Tokisaki3333/h415-LSM6DSV16XTR/docs/参考源_官方手册与规范.md

# 参考源：官方手册、规范与外部实现

> **定位**：本目录集中存放**厂商/官方**的原始资料，供实现与核对时引用。
> 这些资料是**一手权威**，不受本项目历史口径变动影响。
>
> 建立日期：2026-10-15

---

## 1. 器件数据手册（`docs/datasheets/`）

| 文件 | 器件 | 用途 | 本板是否在用 |
|---|---|---|---|
| `LSM6DSV16XTR_datasheet.PDF` | ST LSM6DSV16X | IMU（陀螺 + 加计） | ★ **在用** |
| `MMC5983MA_datasheet.PDF` | MEMSIC MMC5983MA | 三轴磁强计（18 位，SET/RESET） | ★ **在用** |
| `BMP388_datasheet.PDF` | Bosch BMP388 | 气压计 | ★ **在用** |
| `CH32H417_datasheet.PDF` | WCH CH32H417 | MCU 数据手册 | ★ **在用**（V3F/V5F 双核） |
| `CH32H417_reference_manual.PDF` | WCH CH32H417 | MCU 参考手册（寄存器级） | ★ **在用** |
| `ATGM336H_GNSS_module_manual.PDF` | 中科微 ATGM336H | GNSS 模块用户手册 | ★ **在用** |
| `MMC5603NJ_datasheet.PDF` | MEMSIC MMC5603NJ | 磁强计（**无 SET/RESET**） | ✗ 历史/对照 |
| `ICM-42605_datasheet_legacy.PDF` | TDK ICM-42605 | IMU（**旧代器件**） | ✗ 仅旧代归档 |

**另有**：`LSM6DSV16X_register_map.md`（寄存器映射速查，中文，13 KB）。

### 器件换代说明（引用时必须注意）

```
当前硬件 = LSM6DSV16X + MMC5983MA
旧代硬件 = ICM-42605 + IST8310（现存于 _archive/legacy_icm42605_ist8310/）
⟹ 凡文档提到 ICM-42605 / IST8310 / MMC5603NJ 的配置、寄存器、噪声，
   都是【旧代】结论，不可直接用于当前器件。
   ★ 已知受影响文档：docs/reference_implementations_survey.md
     （其全文为 ICM-42605 + IST8310 时代的调研，含旧代寄存器值）
```

---

## 2. 器件驱动源码

**本仓库内的实现即驱动本身**，位于 `Common/Common/`：

| 文件 | 说明 |
|---|---|
| `lsm6dsv16x.c` / `.h` / `lsm6dsv16x_reg.h` | IMU 驱动 + 寄存器定义 |
| `mmc5983.c` / `.h` / `mmc5983ma_reg.h` | 磁强计驱动 + 寄存器定义 |
| `bmp388.c` / `.h` / `bmp388_reg.h` | 气压计驱动 + 寄存器定义 |
| `i2c_soft.c` / `.h`、`sensor_spi.c` / `.h`、`sensor_dma.h` | 总线层 |

**注意**：
```
1. 工程内未内置厂商的原始驱动【包】（ST 的 lsm6dsv16x-pid、MEMSIC 的 MMC5983MA
   参考驱动源码树）—— 本地未找到对应压缩包。
2. 若需逐寄存器核对，请以 docs/datasheets/ 的手册 + 仓库内 *_reg.h 为准；
   后者是从手册抄录的寄存器定义。
3. 磁强计的 SET/RESET 时序口径（官方驱动 AP_Compass_MMC5XX3 的做法）见
   docs/S2_地磁读法与阶段结论.md 与 docs/mag_calibration_log.md。
```

---

## 3. 外部实现对照（调研结论）

`docs/reference_implementations_survey.md` —— PX4 / ArduPilot / Betaflight / Paparazzi / xioTechnologies Fusion 的对照调研。

```
★ 该文档为【旧代（ICM-42605 + IST8310）】时代的产物，其寄存器值与结论不可直接用于
  当前器件；但其"对照什么、用什么判据"的方法论仍可参考。
```

---

## 4. 引用纪律

```
1. 手册 > 仓库内 *_reg.h > 文档中的转述。
   凡"文档说器件如何"与手册冲突，以手册为准，并应修正文档。
2. 任何来自旧代器件的数字（ICM-42605 / IST8310 / MMC5603NJ）必须标注【旧代】。
3. 本目录只放官方/厂商资料。项目的分析口径、常数溯源、结论登记
   分别在 docs/接力_*.md、V5F/User/inc/proc_tune.h 注释、
   docs/地磁结论信任登记表.md 中，不要混入本目录。
```
