Tokisaki3333/h415-LSM6DSV16XTR/地磁工作交接_20261015.md

# 地磁工作交接文档（2026-10-15 建立）

# ★★★★★ 唯一验收判据（本文件一切数字都挂在这条上）

# **地磁矢量在世界系坐标的集中程度**

```
唯一的量:  B̂_world = R(q) · (m̂_body)
           其中 m̂_body = 该姿态下的实测地磁单位矢量
                R(q)   = 该姿态相对世界系的旋转
           集中程度 = 各姿态的 B̂_world 相对其均值的夹角散布

唯一记法:  报告【总角误差】的 σ / max（单位：度）
```

## 明确【不算】判据的量

```
✗ 模长 |B| 的散布                （用户明确：模长没有意义）
✗ "欠零点"的散布                 （中间量，不是判据）
✗ 与陀螺积分的吻合度             （陀螺不是判据的基准）
✗ dip（场与重力夹角）的散布      （诊断量，不是判据）
✗ 同姿态重访的一致性             （辅助量，不是判据）
```

## 为什么必须写在最前面

```
本文件里有三组数字相差一个量级，极易互相误用：
    总角误差  ≈ 2.70°（max）
    倾角分量  ≈ 1.51°（σ）
    偏航分量  ≈ 3.79°（σ）
若不知道"唯一记法是总角误差"，就会把偏航分量的 3.79° 当成"精度 ±4°"，
或把校准后的 0.49° 当成已经达标 —— 两者都是错的。

另：任何精度数字都必须同时标注其【零点前提】（见 §3 U-1），
    否则该数字不可复现、也不可比较。
```

---

> **本文档的用途**：把当前地磁方向精度工作的**全部尝试、实测效果、以及我（AI 助手）的假设**
> 如实交接。**核心要求：严格区分"真理/事实"与"假设"。**
>
> **阅读约定（务必遵守）**：
> - `【事实】` = 由本仓库数据直接算出、可复现、不依赖任何未验证前提的陈述
> - `【假设】` = 我提出的解释或推断，**未经验证，不得当作结论引用**
> - `【已否证】` = 曾提出、已被数据否决
> - `【未验证前提】` = 某结论成立所依赖、但当前无法证实/证伪的条件
>
> **本文档不含"结论级"断言。** 未经验证的推断一律放在 §4~§6，不得提升为事实。
>
> ★ **不得参考分析源脚本实现**：本工作区（含 v3 根目录的 2084 个 .py）里的
>   分析脚本一律**不作为实现依据**，以防止把过程性尝试固化成"事实"。
>   详见 `docs/参考源_官方手册与规范.md` 与接力文档。判据与事实以本文档 §2 为准。

---

## 1. 当前处境（一句话）

```
以【§0 唯一判据】衡量：
  未校准      : 总角误差 max ≈ 2.70°（σ 0.26°）
  单录制校准后: 总角误差 max ≈ 0.97°（σ 0.25°）
但校准用的水平零点偏移 δ 逐录制不同（061932 |δ|=399、052232 |δ|=433），
搬到另一份录制上反而变差（052232: 4.21° → 5.14°）。
⟹ 修正量无法跨录制沿用。这是当前唯一卡住的地方。
```

---

## 2. 【事实】清单（可直接复现）

### F-1 帧解析

```
168 B FULL 帧；帧头 = 4 个 float（2×sync + type + seq）；载荷从 float[4] 开始
  q      = float[4..7]      gyro = float[8..10]   accel = float[11..13]
  mag    = float[23..25]    pol  = flag2 bit0 = float[29]
  flag   = float[17]        bias = float[30..32]
  ts     = float[18]×2^24 + float[41]，单位 10 ns
自检: |q| 偏离 1 ≤ 1.6e-7（全部帧）；R:\ 上有 15 份录制首 sync 在偏移 104
复现: frame168.py
```

### F-2 两份关键录制的性质

| 录制 | 帧数 | 时长 | SET | RST | SET 占比 | |a| 中位 |
|---|---|---|---|---|---|---|
| `rec_20261015_055817` | 230263 | 30.0 s | 228407 | 1856 | 99.19% | 1.0863 |
| `rec_20261015_061932` | 460506 | 60.0 s | 456802 | 3704 | 99.20% | 1.0050 |
| `rec_20261015_052232` | 921255 | 120.0 s | 913842 | — | — | — |

### F-3 两份录制的 SET 样本三维覆盖

```
055817  SET 228407  去均值协方差特征值 [5.7e6, 1.34e7, 2.52e7]   最小/最大 0.226
052232  SET 913842  去均值协方差特征值 [17992.5, 6.788e6, 8.878e6] 最小/最大 0.002027
        最小方差方向 [0.0072, 0.0177, 0.9998]（≈体 z），沿该方向跨度 3738 counts
061932  SET 456802  去均值协方差特征值 [17375, 4.92e6, 9.13e6]   最小/最大 0.001904
```

### F-4 球拟合结果

```
055817（覆盖充分）: 球心 [130652.4, 131531.8, 132346.2]  R = 8091.9  残差 σ = 176.3 (2.1787%)
                   椭球中心 [130725.2, 131487.5, 132298.7]（差 340）
                   半轴比 [1.015649, 1.002318, 0.982032]  各向异性 3.3617%
052232（覆盖不足）: 自拟合给出 R = 4068.5（而 |f| 应 ≈8100）⟹ 退化解
061932（覆盖不足）: 同
```

### F-5 两相中点在单次录制内与姿态无关

```
061932，6 个姿态（0°,45°,…,225°）的两相中点:
  [131718.52 130976.42 132047.57]  [131721.52 130993.63 132041.12]
  [131709.43 130979.66 132032.07]  [131726.70 130964.43 132039.91]
  [131712.76 130970.67 132047.94]  [131726.00 130984.76 132033.70]
  跨姿态极差 = [17.27, 29.20, 15.87] counts
052232，多个姿态的两相中点: |Δ| = 12.0 / 12.2 / 13.8 counts
⟹ 存在一个【姿态无关的固定矢量】，其估计值即两相中点
```

### F-6 两相中点与球心不是同一个点

```
055817: 两相中点 = [131899.48, 130824.78, 132157.04]
        球心     = [130652.40, 131531.80, 132346.20]
        差       = [-1247.1, +707.0, +189.2]   |差| = 1446.0 counts
```

### F-7 陀螺在 061932 六窗口间的净转角（用户声明为整 45°）

```
0→1 44.6146°   1→2 45.1722°   2→3 44.2463°   3→4 44.3726°   4→5 44.7682°
转轴 [-0.007, 0.019, -0.9998]，与体 z 夹角 1.12~1.20°
⟹ 与"步进 45°"一致到 ≤0.75°
```

### F-8 加计在 061932 六窗口间的一致性

```
重力方向（体坐标）: [0.02324 -0.00302 0.99973]  [0.01845 0.00075 0.99983]
                   [0.01255 0.00030 0.99992]  [0.01116 -0.00583 0.99992]
                   [0.01237 -0.01174 0.99985] [0.01850 -0.01539 0.99971]
相对均值散布: 0.2801° ~ 0.5659°
g_z 极差 2.1e-4    |a| 中位 1.00502
```

### F-9 061932 的场矢量与角度分解（零点 = 055817 球心）

```
SET 均值:
  [127752.5 128698.3 139612.1]  [130588.6 127674.3 139621.5]
  [133333.4 129013.8 139581.6]  [134346.9 131817.9 139525.8]
  [133138.0 134522.0 139490.4]  [130390.5 135610.5 139501.9]
|f| : 8320.56  8234.92  8116.61  8079.48  8133.83  8240.67   相对σ 1.0262%
f·ĝ : 7205.12  7269.98  7267.77  7218.60  7138.78  7086.03
dip : 59.9904  61.9848  63.5625  63.3098  61.3620  59.3037
      中位 61.6734°  σ 1.5728°  极差 4.2588°

相邻方位差: 44.5065  48.7198  49.2285  46.7391  43.2450   （应 45°）
```

### F-10 061932 的角度误差分解

```
                        总角误差σ    max       倾角分量σ   偏航分量σ
  原始（锚点 45° 参照）   0.2624°   2.7037°    1.5078°     1.8006°
  原始（陀螺参照）        0.2592°   1.9745°    1.1743°     1.1685°
  零点重解后（锚点）      0.2517°   0.9712°    0.2125°     0.4947°
  零点重解后（陀螺）      0.3901°   2.5370°    1.3187°     1.4649°

原始偏航残差（锚点参照）: -4.4705 -4.9640 -1.2443 +2.9843 +4.7234 +2.9684
   中位|·| 3.7274°  σ 3.7904°  max 4.9640°   （极差/σ = 2.556，接近正弦的 2.83）
原始倾角残差（相对中位）: -1.683 +0.311 +1.889 +1.636 -0.311 -2.370
```

### F-11 水平模长（应恒定）在 061932 上不恒定

```
|h| : 4109.57  3819.36  3564.45  3593.84  3848.79  4137.45
相对σ 5.7951%   极差 573.1 counts
```

### F-12 "正六边形约束"反解水平零点偏移 δ 的效果

```
定义: h_k = (S_k − Z) 的水平分量；约束 = |h_k| 恒定 且 相邻方位差 = 45°；只解 2 参数

061932: δ = (+363.60, −164.60)  |δ| = 399.12
        偏航残差 σ 3.7904° → 1.0241°（max 4.9640° → 1.9137°）
        |h| 相对σ 5.7951% → 0.3616%
        |h| : 4109.6 3819.4 3564.4 3593.8 3848.8 4137.5
            → 3971.6 3983.9 3942.6 3945.8 3962.1 3955.7

052232: δ = (+332.80, +276.40)  |δ| = 432.61   （步数由陀螺定: [0 1 2 3 4 5 5 7 8 9 10 11 12]）
        偏航残差 σ 4.2084° → 0.8061°（max 6.5575° → 1.7415°）
        |h| 相对σ 8.1780% → 0.7295%
```

### F-13 δ 不可跨录制沿用

```
把 061932 的 δ 用到 052232 上:
    偏航残差 σ 4.2084° → 5.1371°（变差）
    |h| 相对σ 8.1780% → 6.8937%
两份录制的 δ: 061932 |δ|=399（方向角≈062°）；052232 |δ|=433（方向角≈040°）
    差值 344 counts，方向差 22°
```

---

## 3. 【未验证前提】清单（结论成立所依赖、但当前无法证实/证伪）

```
U-1 零点取值
    055817 球心能不能当 061932/052232 的零点？
    ⟹ 无法判定。052232/061932 的 SET 覆盖不足（F-3），其真实零点不可辨识。
    ⟹ 一切依赖零点取值的精度数字，都必须标注该前提。

U-2 转台动作的几何
    用户声明 061932 的步进是整 45°、六窗口静置（已用于 F-7 的对照）。
    "转台轴 = 世界竖直" 这一条未独立验证。

U-3 磁与加计的相对安装
    假定两者同体坐标系、无相对安装角。未独立标定。

U-4 场在装置所处位置的均匀性与时间稳定性
    按物理常识假定地磁矢量在录制期间恒定。未独立测量。
```

---

## 4. 【假设】清单（我的推断，均未验证）

```
H-1 偏航误差的主要来源是"未补偿的水平零点/硬磁偏移"
    支持: F-11（|h| 随方位周期波动 5.8%）+ F-12（解掉该偏移后偏航误差降 3.7 倍）
    反证缺失，但也未排除其他来源（标度/交叉轴/加计对应项）
    状态: 【假设】

H-2 F-12 里解出的 δ 是一个"物理量"而非拟合噪声
    支持: 只用 2 个参数，同时改善了 (a) 12~13 点的模长恒定性 与 (b) 步进等角性
    风险: 单录制拟合，无法排除"吸收了这个录制特有的系统项"
    状态: 【假设】

H-3 δ 逐录制不同的原因
    候选（本数据无法区分）:
      a) 磁零点的会话间漂移
      b) 055817 球心估计本身的系统偏差（其 RST 仅 1856 样本）
      c) 两个水平轴的标度/交叉轴项（会伪装成 δ）
    状态: 【假设，未区分】
```

### 曾提出并已【已否证】的假设

```
X-1 "差分流 (RST−SET)/2 自动消掉零点，无需重拟合"
    ⇒ 否证依据: 用 055817 球心作零点时还需额外 δ（F-12）；两相中点与球心差 1446（F-6）
    注: 后来用户裁断"无法判断一个预制零点是否合适"，故该否证本身也降级为
        "两种零点口径给出不同结果"这一事实陈述

X-2 "运动污染地磁读数"
    ⇒ 否证: 055817 SET 样本 corr(log10|ω|, 球拟合残差%) = +0.098（不相关）
            各运动层 |f−c| 均值 8048~8123（差 0.9%）

X-3 "dip 极差由竖直零点或水平增益造成"
    ⇒ 否证: c_z 变动 ±200 counts ⟹ dip 极差仅 4.21°→4.31°
            水平 ×0.95~1.05 ⟹ dip 极差仅 4.14°→4.37°

X-4 "用 grav_open 位可直接判定静置平台"
    ⇒ 否证: 052232 里 grav_open=1 有 331 个游程，绝大多数 <0.3 s，前后闭口 0.00~0.04 s
            段内 |ω| max 普遍 20 dps（门开/关过渡的爆发）

X-5 "陀螺与磁不自洽（差 23~26°）"
    ⇒ 否证: 我自己把步进几何公式写反了。
            正确式 θ = arccos(cos²α + sin²α·cosφ)（α = 场与转轴夹角）
            我误用 arccos(sin²α + cos²α·cosφ)
```

---

## 5. 【事实】级的勘误（我犯过、必须留档）

```
E-1 Δts 单位错: 曾按 1 µs 用，实为 10 ns（dt 差 100 倍）
E-2 录制时长: 曾用 ts 跨度当时长 ⟹ 误报"丢帧 88%"。
    实际是文件开头 ~8 KB CDC 陈旧积压（时戳早 74 s），实时窗口内 Δseq ≡ 1
E-3 帧头 float 数: 曾数成 3 个，实为 4 个
E-4 无 sync 搜索的加载器: 在 size%168==104 的文件上 100% 静默错误
E-5 列位置: 曾把 float[4:7] 当加计（那是 qw,qx,qy）；float[14:16] 当 mag_u（那是 IGG 权与统计量）
E-6 degrees(sum) 漏乘 dt: 把 179° 读成 10256°
E-7 用 ∫ω dt 的模当转轴: 多动作窗口下不可靠，应从积分四元数取轴
E-8 二次型拟合不看条件数: 曾输出"各向异性 1.54%"，而奇异值 min/max = 2.86e-10
E-9 共面点集做 3D 球拟合: 曾给出 R=7032 的伪解（而 |f|≈8563）
E-10 PowerShell 内联 Python 改文件时 \n 被当真换行，块间多插 16 个空行
E-11 我曾用中间版索引去覆盖当前索引，丢掉了 10-13 的合法更新（已恢复）
```

---

## 6. 待做的判定实验（最小充分条件）

```
D-1 【区分"零点漂移"与"标度/交叉轴"】
    同一姿态、把器件原地绕竖直自转 180°（不换面、不换夹具），再回到原位
      δ 跟着器件朝向变 ⟹ 标度/交叉轴（与器件朝向绑定）
      δ 不变         ⟹ 零点漂移（与姿态无关）
    理论依据: F-5 已证明两相中点与姿态无关；若 δ 属于同一类，它也应与姿态无关

D-2 【分离"系统性"与"重复性"】
    每个姿态停 ≥2 s 并重复访问（如 0°/45°/…/315° 各停两次）
    当前 061932 每个姿态只测一次，无法把方位相关系统误差与随机误差分开

D-3 【独立验证"转台轴 = 世界竖直"】
    在同一录制内加一段纯倾斜（不绕竖直转），看 dip 是否随倾斜角保持
```

---

## 7. 脚本资产（本次工作产出）

| 脚本 | 作用 | 状态 |
|---|---|---|
| `frame168.py` | 168 B 帧权威解析（sync 搜索） | 已验 |
| `gyro_pc.py` | PC 侧陀螺零偏追踪复现 | 已验（与板载差中位 ≤0.0036 dps） |
| `deltasolve2.py` | 正六边形约束反解水平零点 δ | F-12 来源 |
| `deltacross2.py` | δ 的跨录制验证 | F-13 来源 |
| `sep_061932.py` | 倾角/偏航分量分离 | F-10 来源 |
| `dipdiag.py` / `dipdiag2.py` | dip 极差归因（否证 X-3） | X-3 来源 |
| `zerocross.py` | 两相中点姿态无关性、球心 vs 中点 | F-5 / F-6 来源 |
| `ellipsoid_full.py` | SET-only 球/椭球拟合 | F-4 来源 |
| `prec_061932.py` | 精度口径汇总 | F-10 汇总 |
| `anchor061932.py` `anchor2_061932.py` `anchor3_061932.py` | 锚点法（含两次符号错误留档） | 参考 |
| `motionresid.py` | 残差 vs \|ω\| 相关性（否证 X-2） | X-2 来源 |

---

## 8. 交接要点（给下一位）

```
1. 先读顶部【唯一验收判据】，再读 §2（事实）与 §3（未验证前提），最后 §4（假设）。
   不要把 §4 当结论。
2. 凡引用任何精度数字，必须同时标注其【零点前提】（见 U-1）。
3. 零点标定必须用专用全覆盖录制；验收录制不具备自标定能力（F-3）。
4. 静置平台提取不要用 grav_open 直接判定（X-4）。
5. 每个精度数字必须写明是"哪两个坐标系之间的角"：
   总角误差 ≠ 倾角分量 ≠ 偏航分量（F-10 三个数差一个量级）。
6. 卡点只有一个：δ 逐录制不同（F-13）。D-1 是解开它的最小实验。
```

---

## 9. 仓库边界与已知冲突点（2026-10-15 补齐）

### 9.1 ★ 知识污染防护：不得参考分析源脚本

```
本项目明确【不得参考分析源脚本的实现】。

理由：本次及以往工作在工作区根目录（v3）积累了 2084 个一次性分析脚本。
      它们承载的是【当时的过程性尝试】，其中相当一部分后来被证否：
        · 以模长 |B| 为判据
        · 用自制 |ω| 阈值 / 滑杆中值切静置平台
        · 在近共面（三维覆盖不足）的点集上做 3D 球拟合
        · 二次型拟合不看条件数（曾输出伪"各向异性 1.54%"，实际条件数 1e9）
        · 用 arcsin(|f·ĝ|/|f|) 或 180°−∠ 算 dip
        · Δts 当 1 µs（实为 10 ns）
      把这些脚本放进仓库，会让后来者把它们当成"已验证的方法"照搬，
      从而把已被否证的思路复活。

⟹ 判据、事实、常数溯源一律以【文档 + 原始 .bin + 固件源码】为准，
   不以任何分析脚本的实现为准。
⟹ 本仓库【不收】分析脚本；`tools/recording/` 只收采集工具与协议。
```

### 9.2 已发现并已修正的不一致

| # | 位置 | 问题 | 处置 |
|---|---|---|---|
| 1 | `V5F/User/src/proc_eskf.c` L64 注释 | 注释写 `ESKF_KS_SCALE = 636 ppm` 并附完整推导，而 L71 实际定义是 `7.5e-5f`（75 ppm），两值差 8.5 倍；且 `ESKF_KS_SCALE²` 进 Q，倍率差 72 倍，直接决定所有观测的 K | **已改**：注释改为"当前 75 ppm；下方 636 ppm 为已被替换的旧值推导记录，勿据它改回"。变更出处 `8c30f77` 已写入注释 |
| 2 | `V5F/User/inc/proc_tune.h` L121-142 | 注释论证"K 取 0.02"，实际 `CORR_K_MIN = CORR_K_MAX = 0.0f`，二者矛盾，读者会以为漏改 | **已改**：注明 `= 0` 是**有意关闭**（出处 `3f9bfc0` 原注释「关闭：本链路只做陀螺直接积分」），并指明地磁牵引强度的实际控制点在 `proc_eskf.c` 的 `ESKF_MAG_PERP_DEG` / `ESKF_MAG_PAR_DEG` / `ESKF_KS_SCALE` |
| 3 | `docs/接力_20261014_地磁与ESKF.md` §1.9 | 称 9 个改动"未提交"，实际均已在仓库 | **已加**顶部状态校正表，原文保留 |
| 4 | 同上 §2.1 | 称目标行在 `proc_eskf.c:1108` | **已加**校正：实际在 `:1022`（文件现 1284 行），行号已漂移 |
| 5 | `docs/reference_implementations_survey.md` | 全文为**旧代器件**（ICM-42605 + IST8310）时代 | **已加**标注（在 `docs/参考源_官方手册与规范.md` §1 与接力文档顶部校正表），不可用于当前器件 |

### 9.3 ⚠️ 未处置的冲突：零点是三方冲突，**需你裁决**

```
三套零点值同时存在，且互不一致：

【A】V5F/User/inc/proc_tune.h  宏定义（固件正在用）
     MAG_ZERO_X/Y/Z_CNT = [130417.0, 131373.0, 132319.0]
     出处：2026-10-14 连续采样模式下两次独立会话的 SET 相球心均值
     该文件同时断言："用【常量】零点，不做逐录制拟合"，
       理由是"地磁矢量方向在世界系恒定 ⟹ 本就不需要拟合"，
       且"姿态覆盖不足的录制逐录制拟合会病态"

【B】本会话 2026-10-15 在 rec_20261015_055817 上拟合的 SET-only 球心
     [130652.4, 131531.8, 132346.2]   R = 8091.9   残差 2.1787%
     已写入本文档 §2 F-4 与 §4 H-3

【C】proc_tune.h 注释中保留的更旧值
     [129652.4, 131607.4, 131318.5]（触发模式时代）

冲突点：
  · A 与 B 差 [−235.4, +158.8, +27.2]，|差| = 285 counts
  · 本会话 F-13 实测"额外水平偏移 δ 逐录制不同"（061932 |δ|=399、052232 |δ|=433）
    ⟹ 与 A 的"用常量、不拟合"直接矛盾
  · 但按用户裁断，052232/061932 的 SET 覆盖不足、其真实零点不可辨识（U-1）
    ⟹ 本会话【无法】判定 A 与 B 谁对

处置：本轮【未改动】任何零点常量（改动会改变固件行为，属实质决策）。
      请裁决：以 A 为准？以 B 为准？或先做 D-1 实验再定？
```

### 9.4 本仓库缺什么（补齐记录）

```
已补齐（2026-10-15）:
  ✓ docs/datasheets/  —— 9 份官方手册/规范（LSM6DSV16X、MMC5983MA、MMC5603NJ、
                          BMP388、ICM-42605[旧代]、CH32H417 数据手册与参考手册、
                          ATGM336H GNSS 手册、LSM6DSV16X 寄存器映射表）
  ✓ docs/参考源_官方手册与规范.md —— 手册索引 + 器件换代说明 + 引用纪律
  ✓ tools/recording/  —— record.ps1 / record.cmd / 录制协议 / 本目录 README
  ✓ 本文件（地磁工作交接_20261015.md）

仍然缺（按必要性）:
  ✗ §4.3 的 7 份【MCU 原始录制】—— 全部不存在
    （R:\ 为 RAM 盘已清空；_recordings/ 为空目录；全盘搜索无 rec_20261014_*.bin）
  ✗ 构建 / 烧录 / 取录制的运行手册（按用户指示，这些由使用者自行完成，本仓库不提供）
  ✗ 厂商原始驱动包（ST lsm6dsv16x-pid / MEMSIC MMC5983MA 参考驱动源码树）——
    本地未找到；工程内 Common/Common/ 的实现即驱动本身
```

### 9.4.1 ★ 已找到并保留下来的录制数据（2026-10-15）

```
【PC 复刻导出】—— 唯一幸存的录制数据
  位置: R:\rec_关键_20261014\        （按用户指示，大文件放 R 盘）
  内容: 8 个文件, 482 MB, 已逐个 SHA256 校验通过
        x_025232_on.bin  x_025232_off.bin      (75.1 MB × 2)
        x_034941_on.bin  x_034941_off.bin      (58.0 MB × 2)
        x_033516_on.bin  x_033516_off.bin      (49.7 MB × 2)
        x_043549_on.bin  x_043549_off.bin      (58.4 MB × 2)
        _on = 磁观测开启, _off = 磁观测关闭（供 A/B 对照）
  格式: 76 B/帧 = 19 × float32，1,036,002 帧/份
  清单: R:\rec_关键_20261014\录制清单.md（逐文件 SHA256 + 与接力文档 §4.3 的对应表）

  对应关系: 这四份正是接力文档 §4.3 的 A / B / C / D

  ★ 但它们【不是】MCU 原始 .bin，而是 PC 复刻链的输出 —— 比原始字节少一层信息。
    若需要"原始字节级复现"，必须重新录制（见 tools/recording/）。

  ✗ 仍缺: rec_20261014_023847 / 023556（100 s 全静止，γσ = 0.1248°/0.1197° 的来源）
          rec_20261014_025044（多姿态静止，球心用于零点更新的依据）

【PC 复刻源码】存在于工作区根目录（未入库，按知识污染纪律）:
    pc_chain_main.c  pc_eskf_main.c  pc_shim.h
    build_pcchain.bat  build_pcchain_nomag.bat  build_pceskf.bat  magmap.py
  （magmap.py 另有一份已入库: docs/tools/magmap.py）
```

### 9.4.2 ★ 大文件纪律（用户明确指示）

```
"大文件操作（例如录制缓存、仿真缓存）放到 R 盘"

⟹ 录制输出、PC 复刻导出、仿真中间产物、任何百 MB 级缓存，统一写 R:\，
   不要写在 C:\ 的工作区/仓库里。
★ 但 R:\ 是 RAM 盘（本机 4 GB，可用约 2.5 GB），重启即失。
  ⟹ R:\ 是【工作区】不是【归档处】；需长期保留的必须另存持久位置。
```

### 9.5 关于本次 67 个分析脚本

```
按 9.1 的纪律，它们【不入库】。
若确需留存，请放在版本控制之外的位置（例如本地备份目录），
并明确标注"过程性尝试，不得作为实现依据"。
本会话已另有一份带 SHA256 校验的本地备份：
    备份_20261015_地磁方向精度_源码\  （含 备份校验清单.md 与 _verify_backup.py）
```
