Tokisaki3333/h415-LSM6DSV16XTR/docs/接力_20261014_地磁与ESKF.md

# 接力文档 —— 地磁链路与 ESKF（2026-10-14 会话交接）

> ## ⚠️ 2026-10-15 状态校正（由后续会话追加，原文未改）
>
> 本文档写于 2026-10-14，其"代码树状态"描述已过期。校正如下：
>
> | 原文处 | 原文 | 现况（2026-10-15 核实） |
> |---|---|---|
> | §1.9 | "代码树当前状态（**未提交**，未烧录）"，列出 9 个 `M` 文件 | **这些改动已在仓库中**（见 `git log`：`3f9bfc0` / `c9c5d46` / `8c30f77` / `e0a3c01`）。§1.9 的 `git status` 快照不再成立。 |
> | §1.9 | "未跟踪: 任务③…、地磁结论信任登记表.md、接力_20261014…" | **三者均已入库**。 |
> | §2.1 | "`proc_eskf.c:1108`" | **行号已漂移**：目标语句实际在 `proc_eskf.c:1022`（该文件现 1284 行）。 |
> | §2.1 | "用单一 `k_s = 75 ppm`" | 与代码一致（`ESKF_KS_SCALE = 7.5e-5f`），**但该常量上方注释仍写着 636 ppm**，已在本轮修正注释。 |
>
> **另需知道的两条（本轮核实）**：
> 1. `docs/reference_implementations_survey.md` 全文为**旧代器件**（ICM-42605 + IST8310）时代，
>    不可用于当前 LSM6DSV16X + MMC5983MA。
> 2. **本文档 §4.3 的 7 份关键录制、§4.2 的 11 个分析脚本，在仓库与 `_recordings/` 中均不存在**
>    （`R:\` 为 RAM 盘，仅存当日录制；`_recordings/` 为空目录）。
>    ⟹ §2.1 / §2.2 的验收判据目前**无法执行**。
>
> **本轮工作的交接见**：`地磁工作交接_20261015.md`（含唯一验收判据、事实/假设分级、三处冲突点）。
> **官方手册与录制工具**：`docs/参考源_官方手册与规范.md`、`tools/recording/`。

> 目的：把本会话的**成果、残留任务、未解疑惑**集中到一处，供接力者直接接手。
> **铁律**：判据只能是**原始 `.bin` 字节 + 生成它们的固件源码**。任何未经验证的结论不得进入设计依据。
> 时间戳规则见 `地磁结论信任登记表.md`（唯一正确磁读取脚本 = `magmap.py`）。

---

## 0. 一句话现状

**磁链读取/解算链路已闭合且板上验证；ESKF 侧剩一个明确的参数问题：`k_s` 偏低导致所有观测增益 `K = P/(P+R)` 偏小，磁牵引偏弱。**
**已定位到具体行号与具体数值，未实施（见 §2.1）。**

---

## 1. 成果（已实施 / 已验证）

### 1.1 固件硬件层（板上实测验证）

| # | 项 | 结果 | 证据 |
|---|---|---|---|
| 1 | **连续采样模式修复** | 磁率 **743 → 1206 Hz** | `023556`/`023847`/`025044`/`025232`/`034941`/`033516` 六份录制 |
| 2 | **按需 RST**（V5F 请求 → V3F 构造时序） | RST 间隔 **1.0001~1.0008 s**，`req`/`done` 同步增长 | 同上；语义：`req` 持续领先 `done` ⟹ V3F 未响应（地磁失效） |
| 3 | **RST 状态机修复** | 状态优先（`s_polarity==1` 必走完收尾） | `board_io.c:592`；缺陷由 `verify_rst_fsm.py` 抓出 |
| 4 | **连续 SET 段不再每拍写 CTRL0 触发** | 仅 `s_mmc_cmm_on==0` 时写一次 | `board_io.c:650` |
| 5 | **RST 收尾恢复连续模式** | 写回 `CTRL0=0x24` + `CTRL2=0x8F` | `board_io.c:604-610` |
| 6 | **停止累加被禁的中点零点** | `(RST+SET)/2` 不再累加 | `board_io.c:564-575` |

**RST 两代实现的判别法**：旧 = 间隔恒为 1024 个磁样本；新 = 间隔恒为 1.000 s。

### 1.2 标定参数（代码已改）

| 文件:行 | 常量 | 旧 → 新 | 依据 |
|---|---|---|---|
| `proc_tune.h:63-65` | `MAG_ZERO_X/Y/Z_CNT` | 129652.4 / 131607.4 / 131318.5 → **130417 / 131373 / 132319** | 两次独立会话球心互证：`025044`[130430.3 131333.5 132385.0]（多姿态静止，覆盖 118.5°）与 `025232`[130403.7 131411.5 132252.3]（剧烈全姿态，球残差 1.079%），两者仅差 **156 counts**；旧值距新值 1214~1348 counts（15~17%） |
| `proc_eskf.c:94` | `ESKF_SIG_NOGRAV` | 6.7e-3 → **2.384e-3** rad/s | 四份录制双参数拟合 b = 0.1366 °/s。旧值是"为让 `000422` 落进 IGG 接受域"反推的，**而磁通道 IGG 已移除，该理由不再成立** |
| `proc_eskf.c:69` | `ESKF_KS_SCALE` | 保持 **7.5e-5**（75 ppm） | **⚠ 待改，见 §2.1**；注释里"636 ppm"是陈旧文字，需同步 |

### 1.3 EKF 结构改动（代码已改）

| 文件:行 | 改动 |
|---|---|
| `proc_eskf.c:317` | `eskf_update()` 增加 `uint8_t use_igg` 参数 |
| `proc_eskf.c:385+` | IGG 三段权包进 `if (use_igg)`；`use_igg==0` ⟹ `w ≡ 1.0` |
| `proc_eskf.c:1180` | **磁**调用：`eskf_update(v_mag, z, rp², rq², **0u**)` |
| `proc_eskf.c:1225` | **重力**调用：`eskf_update(v_up, z, rs², rs², **1u**)`（保持） |

**动机**：磁与重力原先共用 `eskf_update` ⟹ 共用 IGG ⟹ 磁的大新息被判粗差、权重压到 `WMIN=1e-3`。
（**⚠ 该"改善"的性质存疑，见 §3.1**）

**★★ IGG-III 本身的完整设计记录见 `IGG-III稳健权设计记录.md`**
（含设计动机、旧方案失效原因、χ² 自由度归一修正、离线验证、
 以及"为何对重力无害而对地磁有害"的机理与未解疑惑）。

### 1.4 建立的分析口径（用户指定，唯一合法）

```
真磁残差(t) = angle( z_meas(t) , R(q_nomag(t))ᵀ · v_mag )

  z_meas = (mag − MAG_ZERO)/|·|   或 magmap 正路 cal[want] 球心（两者自洽）
  q_nomag = 【未融合地磁的 EKF】姿态（pc_chain_nomag 输出）
  v_mag   = 世界系场参考；由运动前静止段拟合，或取板上 EKF 实际值（两者自洽）

★ 禁止: 用"融合了地磁的 EKF"与"未融合的"作比较（磁开结果在参数未定时无物理意义）
★ 分段 = 每两个磁数据之间为一段（段极短 ⟹ 无 180° 环绕）
★ 物理含义: q_nomag 可信 ⟹ 残差 = 地磁链 + 姿态误差在 ⊥场 方向的投影
```

### 1.5 拟合出的方程（核心成果）

```
残差 = a·转角 + b·时间          ← 用户给定模型，无常数项（常数视为白噪声）

四份录制联合：a = 81.8 ppm      b = 0.1366 度/秒
  录制（记号见 §4.3.1）    θ/t 比(°/s)   |ω|中位(dps)
  A `025232`                1385          1725
  B `034941`                1312          1735
  C `033516`                1435          1727
  D `043549`（慢转）          553           561      ← ★ 它打破共线（corr 0.99+ → 0.694，条件数 2.6e3）

交叉点（地磁开始主导的判据）：
  比例项 θ* = σ_m/a :  σ_m=0.44° → 5379°    σ_m=0.12° → 1467°
  零偏项 t* = σ_m/b :  σ_m=0.44° → 3.22 s   σ_m=0.12° → 0.88 s
```

### 1.6 率相关标度的直接测量（关键新发现）

**按 |ω| 分档测过原点斜率（ppm）：**

| 录制（记号见 §4.3.1） | 0-200 | 200-600 | 600-1200 | 1200-2000 |
|---|---|---|---|---|
| **D** `043549` **慢转** | 430 | 306 | 227 | — |
| **B** `034941` 快转 | 147 | 104 | 231 | **260** |
| **A** `025232` 快转 | 138 | 128 | 217 | **214** |
| **C** `033516` 快转 | 93 | 128 | 105 | **194** |

```
★ 低转速段 (<600 dps):  93~430 ppm，中位 ≈ 130 ppm
★ 高转速段 (1200~2000):  194~260 ppm，中位 ≈ 220 ppm
★ 四份一致单调上升 ⟹ 陀螺标度误差【率相关】确认
★ 这解释了代码里两个并存的值：ESKF_KS_SCALE=75 ppm（低端）与 SG_PPM=246 ppm（高端）
```

### 1.7 已排除的候选（省得接力者重走）

| 候选 | 结论 | 证据 |
|---|---|---|
| 地磁启动漂移 | ✗ 排除 | 启动窗内磁方向变化 0.000~0.028° |
| `v_mag` 构造方式（方案2 世界系约定） | ✗ 数学等价于原式 | 与原式倾角完全相同；mag_resid 逐位相同 |
| 零点错误导致末态 7° | ✗ 排除 | 新旧零点下末态残留 7.74° vs 7.86° |
| 重力/加计误差 | ✗ 排除 | 用户确认"每次放回台座姿态正确" |
| 滞后（测量→DRDY） | ✗ 排除 | 残差与 \|ω\| 相关系数仅 −0.05~+0.03；滞后 0~0.5 ms < 采样周期 0.829 ms |
| 软磁/非旋转映射（3×3） | ✗ 排除 | 3×3 拟合使残差【变差】（3.8→5.0°）；奇异值形变仅 1~3.6% |
| 地磁传感器数据伪迹 | ✗ 排除 | 磁矢量方向变化/陀螺转动 中位 0.761 ≤ 1；原始 counts 平滑 |
| 姿态冻结 | ✗ 排除 | 逐陀螺帧(130µs) θ_quat/θ_gyro = 0.996；10ms 窗 0.986~0.992 |
| 陀螺野值污染 θ | ✗ 排除 | 限幅 ±2000 dps 前后 θ 逐位相同 |
| 表头列映射偏移 | 已确认 | v4 = 168B/42 floats，含 4-float 前导 ⟹ 文档列号偏移 **+4** |
| 输出列含义 | 已确认 | `pc_chain_main.c:174-184`；`col4=acc_resid col5=mag_resid col6=ready col7=grav_open col12-15=q_pre col16-19=q_post` |

### 1.8 常数清单（地磁→EKF 路径）

```
磁→体坐标  : MAG_ZERO_X/Y/Z_CNT(130417/131373/132319)  MAG_CNT_PER_G(16384)
             MAG_DEV_BIAS_G/UX/UY/UZ  ← 死/近死（MAG_DEV_BIAS_G 引用=0）
             MAG_ZERO_CNT             ← 死（引用=0，仅注释提及）
有效性门   : MAG_MIN_UNIT(0.10G)  MAG_STALL_FRAMES(1536)
             MAG_MIN_PERP(0.02G)  MAG_ACC_LIMIT_G(0.03)   ← 仅 proc_mag_corr.c 用
世界系参考 : MAG_REF_NX/NY/NZ(0/0.53920/0.84218)  ← 默认值，PC 复刻会注入覆盖
EKF 磁观测 : ESKF_MAG_PERP_DEG(0.44° ← ★待改)  ESKF_MAG_PAR_DEG(4.00°)
             ESKF_MAG_SIG_DEG(0.3°) ← 观测未使用
EKF 重力   : ESKF_ACC_SIG_DEG(0.1312°)  ESKF_ACC_MAGLIM_G(0.05)  ESKF_GRAV_WLIM_DPS(20)
EKF 的 Q   : ESKF_SIG_G(3.6943e-05)  ESKF_KS_SCALE(7.5e-5 ← ★待改)  ESKF_SIG_NOGRAV(2.384e-3)
并行链路   : SG_PPM(246 ppm)  PG_THR_DEG(0.30)  W_FLOOR_DPS(40)  CORR_K_MIN(0)
             ← 这些被 proc_attitude.c 使用（★ 不要误删，本会话曾误删并已恢复）
```

**★ 重要：`proc_attitude.c` 只在 `proc_eskf_ready()==0`（上电标定完成前）活跃。ESKF 正式运行期间 `k_s` 始终是 `ESKF_KS_SCALE`。**

### 1.9 代码树当前状态（★ 未提交，未烧录）

```
git status（工作区 C:\Users\33\Documents\v3\h415-imu42605-）:

 M Common/Common/board_io.c         (连续模式/SET 段/RST 收尾/状态优先/停止中点累加)
 M Common/Common/mipc_shm.h         (mmc_rst_req / mmc_rst_done / mmc_rst_hz_x10)
 M Common/Common/mmc5983.c          (注释修正)
 M V5F/User/inc/proc.h
 M V5F/User/inc/proc_tune.h         (MAG_ZERO_X/Y/Z 更新; 死常数核查后未删)
 M V5F/User/main.c                  (V5F 每秒发一个 RST 请求)
 M V5F/User/src/proc_chain.c
 M V5F/User/src/proc_eskf.c         (use_igg 参数; ESKF_SIG_NOGRAV 重标)
 M V5F/User/src/proc_mag.c

未跟踪:
 ?? docs/任务③_地磁在线标定方案.md
 ?? docs/地磁结论信任登记表.md
 ?? docs/接力_20261014_地磁与ESKF.md   ← 本文档

★ 板上固件版本 = 上述改动【除 §2.1 与 §2.2】（即已烧录并实测的那一版）
★ 本次会话对 proc_tune.h 的常数删除【曾误删后已全部恢复】，当前与改动前一致
  （误删原因：审计脚本漏扫 proc_attitude.c，而它引用了 SG_PPM/PG_THR_DEG/
    W_FLOOR_DPS/CORR_K_MIN。★ 接力者清理死常数时务必先扫 proc_attitude.c）
```

---

## 2. 残留任务（按优先级）

### 2.1 ★★★ 实施率相关 `k_s`（最高优先，已定位到行）

**问题**：`proc_eskf.c:1108`
```c
qg += 2.0f * ESKF_KS_SCALE * ESKF_KS_SCALE * s_throt_acc * wn * dt_s;
```
用单一 `k_s = 75 ppm`，而实测率相关（130 ppm @<600dps，220 ppm @1700dps）。

**后果**：Q 在高速段偏小 `(220/75)² = 8.6` 倍 ⟹ P 偏小 ⟹ **所有观测的 `K = P/(P+R)` 偏小** ⟹ 磁牵引弱、重力重锚慢。
（地磁通道已无 IGG ⟹ 牵引强度**完全**由 K 决定 ⟹ 这是唯一解释。）

**建议实施**（`k_s(|ω|) = k0 + k1·|ω|`，`|ω|` 单位 dps）：
```c
/* 实测两点拟合: |ω|=400 → 130 ppm, |ω|=1600 → 220 ppm */
#define ESKF_KS_K0   1.0e-4f     /* 100 ppm */
#define ESKF_KS_K1   7.5e-8f     /* 0.075 ppm per dps */
...
float ks = ESKF_KS_K0 + ESKF_KS_K1 * wn;
qg += 2.0f * ks * ks * s_throt_acc * wn * dt_s;
```
**验收判据**：四份转动录制（**A `025232` / B `034941` / C `033516` / D `043549`**，见 §4.3.1）PC 复刻重跑：
- `mag_resid` 中位与末段应【下降】（现为 0.31~1.15°）
- 高速段（\>1200 dps）的 `mag_resid` 应显著改善
- 重力门行为不得变差（`grav_open` 开率、`acc_resid`）

**替代方案（更简、更保守）**：直接把 `ESKF_KS_SCALE` 提到 **200 ppm**（高速端对，低速端偏大 1.5 倍）。

### 2.2 重标 `ESKF_MAG_PERP_DEG`

```
现值 0.44°（旧触发模式时代的估计）
实测（新连续模式）γσ = 0.1197°（023556）、0.1248°（023847）
⟹ 建议改为 0.12°
```
**收益**：K 提高约 13 倍（方差比 (0.44/0.12)²）⟹ 牵引更快。
**注意**：与 §2.1 的改动叠加后需重新验收，避免 K 过大（`PG_CEIL_DEG=2.0` 的注释警告"K→1 退化为直连磁输出"）。

### 2.3 清理与文档同步

| 项 | 位置 | 动作 |
|---|---|---|
| 陈旧注释 `ESKF_KS_SCALE = 636 ppm` | `proc_eskf.c:62` | 改为 75 ppm + 说明率相关 |
| 死常数 `MAG_ZERO_CNT`、`MAG_DEV_BIAS_G` | `proc_tune.h` | 删除（引用=0） |
| 近死 `MAG_DEV_BIAS_UX/UY/UZ` | `proc_tune.h` | 仅 `proc_mag.c` 1 处引用，核查后决定 |
| `ESKF_MAG_SIG_DEG` | `proc_eskf.c:164` | 观测未使用，核查后决定 |
| **`proc_mag.c:145` 被禁中点 TODO** | `proc_mag.c` | 该 TODO 推荐 `(SET+RST)/2`（**被禁口径**）⟹ 必须改，防后来者照做 |
| 文档列映射偏移 4 | `mag_calibration_log.md` 等 | 全部原始列号 +4 |
| 死代码 `s_pend_rst`/`s_have_rst` | `board_io.c:595-598` | 保留（零成本，将来可做 (SET−RST)/2 差分校验）或删除 |

### 2.4 绝对航向问题（独立议题）

```
现象: 023847（100% 静止）的 mag_resid 中位 31.805°
根因: v_mag = MAG_REF_N = (0, 0.5392, 0.84218)（水平指向 +Y=北）与该录制实际朝向差 31.8°
影响: 不影响零点与相对精度，只影响【绝对航向验收】
建议: v_mag 应取该站点实测场方向（含磁偏角），而非 MAG_REF_N
```

### 2.5 `proc_mag_corr.c` 降级链路的处置

```
调用点: proc_chain.c:247 if (mag_valid && proc_eskf_valid()) proc_mag_corr_step(...)
        —— 仅 ESKF 未 ready 时生效
★ 若要删除整条链路，需同时处理该调用点与 proc_attitude.c 的常量引用
```

---

## 3. 未解疑惑（接力者需正面回答）

### 3.1 ★★★ "去掉地磁 IGG 使残差降 8.5 倍"是真改善还是自证式改善？

```
实测: 末段 mag_resid 5.598° → 0.661°（025232）；中位 3.659° → 0.603°
★ 质疑（用户提出，未被反驳）:
   残差的定义就是【姿态与磁的差】⟹ 让滤波器更信磁，残差【必然变小】
   ⟹ 这是【自证式改善】，不能作为"IGG 有害"的证据
   ⟹ 若磁本身有误差，姿态会被拽到磁的方向 ⟹ 残差小但姿态错
★ 需要: 一个【独立于磁】的判据来评价该改动（例如与重力倾斜的一致性、
   或与外部真值对比、或看航向复现性）
```

### 3.2 ★★★ 残差的慢变主项（2.6~3.8° RMS）是什么？

```
性质（已实测）:
  · 慢变占 98.6~98.9%（83 ms 均值 RMS 3.2~3.8°，快变仅 0.39~0.45°）
  · 与 |ω| 无关（相关系数 −0.05~+0.03）
  · 与转角弱相关（R²=0.002~0.065）
  · 四份录制：025232 3.844 / 034941 3.297 / 033516 3.400 / 043549 3.407（RMS）
已排除: 滞后、软磁、比例误差、零偏、磁传感器伪迹、姿态冻结
★ 基线参考: 023847（100 s 全静止）的磁关残差 1.09~2.20°
  ⟹ 运动段的 3.2~3.8° = 1~2° 基线 + 1.5~2° 未知
★ 头号剩余嫌疑: 磁链的慢时变项 —— 但 023847 实测漂移仅 0.3°/min，18 s 只够 0.1°
★ 或: v 的优化方式仍不足以吸收（可试全局最小二乘 / 椭球全矩阵）
```

### 3.3 ★★ `a = 81.8 ppm`（联合拟合）与分档测量的 130/220 ppm 不一致

```
· 四份联合双参数拟合: a = 81.8 ppm（θ/t 共线被 043549 打破后）
· 按 |ω| 分档过原点斜率: 低速中位 130 ppm，高速中位 220 ppm
⟹ 两者差 1.6~2.7 倍 ⟹ 哪个才是"陀螺比例误差"？
★ 可能: 分档斜率混入了慢变主项（§3.2）的残余趋势 ⟹ 被高估
★ 或: 联合拟合的 a 被慢变主项"吸收"走了一部分 ⟹ 被低估
★ 需要: 一个能把 §3.2 主项分离掉的口径
```

### 3.4 ★ 率相关标度的物理机理未定

```
已确认现象: 400 dps → ~130 ppm，1700 dps → ~220 ppm（四份一致）
候选机理:
  ① 交叉轴耦合（∝|ω|）—— 文档 mag_calibration_log.md §8.16 记录过
     "29 dps 慢转档 Y −2387 ppm vs 297 dps −4860 ppm ⇒ 速率相关标度"
  ② 驱动模态 AGC 响应滞后
  ③ 非线性标度
★ 未做: 用转台在不同速率下逐轴测，分离 ①/②/③
```

### 3.5 `v_mag` 的倾角是否需在线精化？

```
现状: v_mag = R0·u_mean，其【倾角由启动窗口那 2 秒的加计均值决定】
★ 该量= cos(angle(a_body, m_body))（旋转不变量）⟹ 信息只来自 a 与 m
★ 若 a 的启动方向有误差 ⟹ v_mag 倾角永久偏 ⟹ 重力与磁在倾斜上分歧
★ 用户已确认"放回台座姿态正确"⟹ 重力无误差 ⟹ 该路径未必有问题
★ 但: 用户建议的方案1（在线精化标量夹角 θ_est）尚未实现，也未验证是否有收益
   建议形态（防自陷）: θ_est ← θ_est + k·(angle(a,m) − θ_est)，k 小（时间常数数十秒）
                        v_mag = [0, cos(θ_est), sin(θ_est)]  ← 由标量重建，不做姿态回代
```

### 3.6 `025232` 在 t=29.0~29.4 s 的孤立磁事件

```
现象: 磁体坐标方向在 0.4 s 内变化约 3.5°（my 132980→132458）
      而同期陀螺积分仅 0.073°、加计 |a| 不变、四元数不变
★ 细查: 原始 counts 是【平滑渐变】不是跳变 ⟹ 数据自洽
★ 系统性检查: 静止段中"磁方向变>2° 且 陀螺积分<0.2°"的事件数
   025232: 1 个 / 034941: 0 个 / 033516: 0 个
   ⟹ 用户判断正确: 若是系统错误应有【大量】⟹ 这是孤立事件
★ 该事件使 025232 的偏航残差从 4.74° 跳到 7.98° 并保持
★ 未定案: 是什么（外部磁干扰？相间残留？读取链路偶发？）
```

### 3.7 重力门与 `k_s` 的关系（本会话曾推理错误，已纠正）

```
★ 错误链条（曾提出后被用户否证）:
   "k_s 偏小 ⟹ P 偏小 ⟹ 重力门自锁"
★ 否证: 现用 75 ppm 跑，而高速录制实测 200+ ppm，重力门【没有】自锁
★ 正确理解:
   · 自锁需要【两个条件同时满足】: ① P 偏小（S 塌到 R）② 残差 r 远大于 R
   · 重力门开门条件是 | |a|−1 |<0.05 且 |ω|<20 dps ⟹ 门一开残差本来就小
     ⟹ 即便 P 偏小，rd 也不会越界 ⟹ 不自锁
   · ★ 所以"高速录制没自锁"是【残差小】决定的，不能用来检验 k_s
★ 另: ESKF 的 IGG 有 WMIN=1e-3 【地板】（不是拒绝）
   ⟹ 不是数学意义上的锁，但收敛时间常数被拉长 1000 倍 ⟹ 录制时长内表现为锁
```

---

## 4. 工具与数据索引

### 4.1 PC 复刻

```
构建: build_pcchain.bat（磁观测开）  build_pcchain_nomag.bat（/DESKF_USE_MAG_OBS=0）
运行: pc_chain.exe <rec.bin> <out.bin>     ← ★ 不要传后面三个参数（argv[6..8]）
                                             传了会把 v_mag 注入成 [0,0,0]
输出 57 floats/帧: col0-3=q_eskf col4=acc_resid col5=mag_resid col6=ready
                   col7=grav_open col8-11=q_eskf col12-15=q_pre col16-19=q_post
                   col20-23=upd col24=nis col25=applied col26-28=p_pre
                   col29-31=p_post col32-37=p6pre col38-43=p6post col44=wigg
                   col45=mv col46=mn col47=mr col48=magcnt ...
★ PC 复刻不编译 board_io.c ⟹ 该文件改动只能靠人工核对 + 仿真验证
★ pc_chain_main.c:866 有 v_mag 注入分支（优先于 proc_eskf.c:737 的构造）
```

### 4.2 本会话新建的分析脚本（工作区根 C:\Users\33\Documents\v3）

| 脚本 | 用途 |
|---|---|
| `magmap.py` | **唯一正确的磁读取**（`Frames` → `calibrate` → `MagSolver.run` → `mag_vector`） |
| `rawmag_only.py` | 真磁残差（magmap 正路 + magmap 球心 + 纯陀螺姿态） |
| `curves_final.py` | 磁残差 vs 转角 / vs 时间（磁关 vs 磁开，**磁开不得用于设计依据**） |
| `joint_fit_vk.py` | 联合拟合 (v, k) 消常数偏置 |
| `fit_with_slow.py` | 双参数 `r = a·θ + b·t`（含慢转 043549 打破共线） |
| `rate_dep_scale.py` | **率相关标度的分档测量**（§1.6 的来源） |
| `check_softiron.py` | 3×3 非旋转映射检验（已排除） |
| `diagnose_resid_main.py` | 残差主项诊断（慢变/快变分解、与 \|ω\| 相关性） |
| `deliver_true_resid.py` | 真磁残差（磁关复刻 vs 磁传感器） |
| `audit_constants.py` | 常数引用审计（★ 慢，且遗漏 proc_attitude.c，慎用） |
| `verify_rst_fsm.py` | RST 状态机仿真 |
| `chk_*`/`recalc_*`/`deliver_*` | 各类专项核查 |

### 4.3 关键录制

| 录制 | 类型 | 关键数据 |
|---|---|---|
| `R:\rec_20261014_025232.bin` | 剧烈翻滚 45 s | θ末 25371°，\|ω\|中位 1725 dps，磁率 1205.8 Hz |
| `R:\rec_20261014_034941.bin` | 剧烈翻滚 35 s | θ末 18393°，\|ω\|中位 1735 |
| `R:\rec_20261014_033516.bin` | 剧烈翻滚 30 s | θ末 26227°，\|ω\|中位 1727 |
| `R:\rec_20261014_043549.bin` | **慢转 30 s** | θ末 14420°，\|ω\|中位 561，θ/t=553 °/s ← **打破共线，关键** |
| `R:\rec_20261014_023847.bin` | 100 s 全静止 | γσ=0.1248°，漂移 0.51°/100s |
| `R:\rec_20261014_023556.bin` | 静止 | γσ=0.1197°（本会话最佳） |
| `R:\rec_20261014_025044.bin` | 多姿态静止 45 s | 球心用于零点更新，覆盖 118.5° |

#### 4.3.1 ★★ 本文档中"几次转动录制"具体指哪几份

**§1.5（双参数拟合）、§1.6（率相关标度）、§2.1（`k_s` 验收）、§3.2（残差主项）
所用的"转动录制"= 以下四份，全部为新固件（连续模式 + 按需 RST，磁率 1170~1278 Hz）：**

| 记号 | 文件 | 转动性质 | \|ω\|中位 | θ末 | θ/t 比 | 在分析中的角色 |
|---|---|---|---|---|---|---|
| **A** | `R:\rec_20261014_025232.bin` | 剧烈翻滚 45 s | 1725 dps | 25371° | 1385 °/s | 主力样本；t=29.2 s 有孤立磁事件（§3.6） |
| **B** | `R:\rec_20261014_034941.bin` | 剧烈翻滚 35 s | 1735 dps | 18393° | 1312 °/s | 主力样本；磁开曲线纹波最小之一 |
| **C** | `R:\rec_20261014_033516.bin` | 剧烈翻滚 30 s | 1727 dps | 26227° | 1435 °/s | 主力样本；θ 最大 |
| **D** | `R:\rec_20261014_043549.bin` | **慢转 30 s** | **561 dps** | 14420° | **553 °/s** | ★★ **关键：唯一打破 θ/t 共线的样本**（把池化 corr 从 0.99+ 降到 0.694） |

**★ A/B/C 是"快转"，D 是"慢转"—— 这个快慢差异正是 §1.6 率相关结论与 §1.5 可辨识性的来源。**

**另有两份旧录制在早期分析中出现过（触发模式时代，**不作为设计依据**）：**

| 文件 | 性质 | 用途 |
|---|---|---|
| `R:\rec_20261014_022427.bin` | 触发模式 743 Hz 剧烈翻滚 45 s | 仅用于"连续模式修复前后"的对照（磁率 743 vs 1205 Hz） |
| `R:\rec_20261011_235545.bin` | 触发电磁时代 | 仅存在于早期 ppm 拟合记录中 |

**静止参照（非转动录制）：** `023847`（100 s）、`023556`、`025044`（多姿态静止）。

### 4.4 权威文档（★ 注意弃用）

| 文档 | 状态 |
|---|---|
| `mag_calibration_log.md` §8.16.1/§8.16.2/§8.16.3 | ★ **权威方法**：tg 锚点 + 倾角残差 + **每轴路径角**分母 |
| `ekf_native_gate_design.md` | 权威：Q/R 的诚实卡尔曼设计 |
| `地磁结论信任登记表.md` | 权威：铁律三条 + 时间线 + 逐条登记 |
| `任务③_地磁在线标定方案.md` | 结论：不做在线标定（但该结论用了**模长口径**，已作废，需用方向口径复核） |
| ~~`636 / 890~4860 / 2000 ppm`~~ | ★ **已弃用**（用户明示） |
| `SG_PPM = 246 ppm` | 仍在用（proc_attitude.c），代表**高速端**实测值 |

### 4.5 用户告知的客观事实（不得质疑）

```
★ 陀螺比例误差 = 75 ppm，由大量数据定出
★ 每次放回台座姿态正确 ⟹ 重力无误差
★ 地磁没有 IGG-III 级别门控的必要，且现在不考虑外部磁干扰
★ 重力门本身的开关先前已反复实验无误
★ 636 / 890~4860 / 2000 ppm 是陈旧的已弃用文档
```

---

## 5. 建议的接手顺序

```
1. 读 §1.5/§1.6 建立对"残差 = a·θ + b·t"与率相关标度的认识
2. 解决 §3.3（81.8 vs 130/220 ppm 的不一致）—— 它决定 §2.1 的 k_s 取值
3. 实施 §2.1（率相关 k_s），PC 复刻四份录制验收
4. 实施 §2.2（R_mag 重标），与 3 联合验收
5. 清理 §2.3（尤其 proc_mag.c:145 的被禁 TODO —— 风险最高）
6. 回答 §3.1（IGG 改动的独立判据）与 §3.2（残差慢变主项）
```

**★ 最后提醒：本会话多次因口径错误得出错误结论（模长 vs 方向、路径 vs 净转角、
标签反转、单位 ×57.3、样本筛选错位、把并行链路的常量当 ESKF 的）。
任何结论落进设计依据前，务必先用【与结论独立的判据】交叉验证。**
