Tokisaki3333/h415-LSM6DSV16XTR/docs/任务③_地磁在线标定方案.md

# 任务③：地磁正常工况下的在线标定方案

> 建立日期：2026-10-14
> **前提：本文所有依据必须能在 `地磁结论信任登记表.md` §3 查到。**
> 依据条目：§3-A（两相不同心，已逐位复现）、§3-F（可辨识性，自量）、
> §3-G（离线零点 0.82°）、§3-H（融合收益）、§3-I（必要性，弱）。
> **本文不引用任何早于 `magmap.py`(10-13 08:26) 且未经复现的地磁说法。**

---

## 一、必要性（实测结论：**弱，且不在"慢漂"上**）

| 判据 | 实测值 | 含义 |
|---|---|---|
| 同录制前后半 SET 球心差 | **1.11°**（158.6 counts），拟合残差 122.3 counts ⟹ 比值 **1.3** | 零点确实在动，但只略高于拟合噪声 |
| 跨录制 SET 球心散布 | 中位 **0.75°**，max **2.83°** | 会话间变化小 |
| 地磁自身精度 | γ σ = **0.737°** | 标尺 |
| 离线常量 vs 六面金牌标准 | **0.82°** | 已足够好 |

**⟹ 结论：**
1. **离线预标定已把零点做到与地磁自身噪声同量级** ⟹ 在线标定跟随慢漂的**边际收益只有 ~1° 量级**；
2. **在线标定真正的价值是【捕捉阶跃变化】**：新增磁体 / 换装夹 / 换外壳 / 换电池
   ⟹ 硬磁可能**跳变**数十度，这类变化离线常量无法预知；
3. **⟹ 因此设计目标不是"更激进的跟踪"，而是"有充分证据才动的、带锚定的慢跟踪 + 跳变告警"。**

**❌ 已否证、禁止使用的必要性论据**（见信任登记表 §3-D）：
"换摆位硬磁可达 27°"。恒定体坐标硬磁产生的是**随航向的正弦误差**
`δψ ≈ (c_⊥/|B_h|)·sin(ψ−φ)`，不是摆位改变硬磁。

---

## 二、在线数据能标定什么（可辨识性，实测）

**方法（不用姿态）：** 机体系磁场单位向量 `N_i=(m_i−c)/|m_i−c|` 的
局部可辨识矩阵 `M = Σ N_i N_iᵀ`，其特征值 `λ1≥λ2≥λ3` 即各方向被激励的强度。

| 工况 | mz 跨度 | λ3/λ1 | 可辨识性 |
|---|---|---|---|
| `230659` 纯水平慢转 | **139~328 counts** | **0.0000~0.0024** | 竖直方向**不可辨识** ⟹ `c_z` 与 `A` 的 z 行不可辨识 |
| `234141` 含翻滚（良好窗口） | 16178 | 0.14~0.55 | 三维可辨识 |
| 六面整圈（全姿态） | 16178 | 0.11~0.19 | 三维可辨识 |

**⟹ 可标定 / 不可标定清单：**

| 量 | 正常工况（不大的姿态运动） | 依据 |
|---|---|---|
| **水平子空间的零点分量**（⊥ 重力锥轴） | ✅ 可标定 | λ1,λ2 被激励 |
| **沿重力/锥轴的分量 `c_z`** | ❌ **不可标定** ⟹ 必须冻结 | λ3/λ1 ≤ 0.0024 |
| **9 参数椭球（含 z 行尺度与交叉）** | ❌ 不可标定 | 需全球面激励 |
| **RST 相零点** | ❌ 不可拟合（1024:1 下仅 15~91 样本） | 信任登记表 §2 |
| **两相混用** | 🚫 **禁止**（两相球心距 3588 counts = 43% 场强） | §3-A |
| **观测量 `|m−c| = |B|`** | ✅ 免姿态、非循环 | 物理恒定事实 |

---

## 三、在线标定目标（设计）

> **⚠ 阅读顺序警告：§三 与 §四点五 是中间过程稿。其中"样本准入门"里的
> `|ω|` 门已被 §7.1 审计判定为【有害】（与姿态强相关，引入 3800~9100 counts 偏置），
> §7.3 已正式取消。**
> **最终权威结论在 §七（7.1~7.4）。引用请以 §七 为准。**

### 3.1 目标（按优先级）

```
G1【主目标】在【可辨识子空间】内在线修正 SET 相零点 c_SET，
            未激励方向【严格冻结】在离线先验 c_off 上。
G2【副产物】在线给出 |B|（场强）及其散布 —— 作为标定质量与"磁场环境变化"的健康指标。
G3【告警】 |B| 或拟合残差出现【阶跃/持续超限】时给出"需重标"告警（捕捉阶跃变化）。
G4【门控】 SET-only + 准静态 + |a|≈1g 的样本准入（见 §3.3）。
```

### 3.2 算法：子空间约束的递推球拟合（已在真实数据上验证）

```
观测量（免姿态）：  |m_i − c| = |B|           （物理事实，与姿态无关 ⟹ 非循环）

滑窗 W（建议 30~60 s 或固定样本数）内：
  1) 一次无约束球拟合得 c0，取法向 N_i = (m_i−c0)/|m_i−c0|
  2) 局部可辨识矩阵  M = Σ_i N_i N_iᵀ ，特征分解得 λ(升序), V
  3) 取可辨识基  B = V[:, λ_k ≥ rel_thr·λ_max]      （rel_thr 建议 0.10）
  4) 令 c = c_off + B·α ，代回球方程 |m|² = 2c·m + b（对 c 线性）：
         min_{α,b}  Σ_i ‖ |m_i|² − 2(c_off+Bα)·m_i − b ‖²
     ⟹ 精确最小二乘（无迭代、无姿态）
  5) 输出 c；并把 (λ_max/λ_min, B 的维数, 残差 RMS, |B|) 作为置信度与告警输入
```

**★ 这个形式的三个关键性质（均已数值验证）：**

| 性质 | 说明 | 实测 |
|---|---|---|
| **不可辨识方向自动冻结** | `B` 只含激励足够的特征向量 ⟹ 沿锥轴的分量**根本不出现在参数里** | `230659`: 与先验差 **119~342** counts（对比弱标量正则的 7500~9700，改善 **20~80 倍**） |
| **激励充分时自动退化为全参数** | 三轴都被激励 ⟹ `B` 取满 3 维 | 六面: 取 3 维，收敛到 magmap 球心 **36~71 counts = 0.25~0.49°** |
| **维度随窗口自洽切换** | 窗口退化时降维、恢复时升维 | `234141`: 1 维 ⇄ 3 维自动切换 |

### 3.3 样本准入门（四道）

```
① 极性: 仅 SET（pol==0）。RST 样本一律丢弃 —— 两相球心距 43% 场强，混用即灾难。
② 速率: |ω| < W_MAX（建议 25~50 dps）。理由：磁与姿态的配准受上报栅格限制，
        |ω|=50 dps 下配准误差约 0.15°（该限制的定量来源见 S3 协议，但该文档未验证，
        故此处以"宁严勿松"取值）。
③ 重力: | |a| − 1g | < 0.05（重力可信 ⟹ 姿态可信 ⟹ 样本可信）。
④ 场强: ||m−c| − |B|_ref| < 阈值（剔除被外部磁体污染或卡死的样本）。
```

### 3.4 更新策略：锚定 + 慢时标 + 阶跃告警

```
· 先验锚定: c 从 c_off 出发；c_off = 固件离线常量（已验证距六面金牌 0.82°）。
· 慢时标:   滑窗长度取 30~60 s；且对 c 的更新再加一阶低通（时间常数 60~300 s）。
           理由（§3-I）：真实慢漂只有 ~1°，不需要快跟踪；快跟踪只会放大噪声。
· 死区:     当 |Δc| 小于噪声当量（约 0.3~0.5°）时不写回，避免抖动。
· 阶跃告警: 当 |B| 中位相对基线偏移 > 1.5%（各录制实测散度中位 1.606%），
           或拟合残差 RMS 持续 > 2 倍基线 ⟹ 置"需重标"标志，而不是自动大改 c。
           （阶跃变化用告警+重标，比让在线估计器去追更安全。）
```

### 3.5 明确不做（Non-goals）

```
✗ 不做 9 参数椭球在线拟合  —— 需全球面激励，正常工况不可辨识（§二）
✗ 不做 RST 相零点在线拟合  —— 1024:1 下样本 15~91 个，不可拟合（§二）
✗ 不做两相混用/中点零点    —— 信任登记表 §3-A/§3-D 已否证
✗ 不追慢漂（>0.5°/min 的响应没必要）—— §一 显示边际收益仅 ~1°
✗ 不用姿态当观测基准       —— 循环论证（信任登记表铁律）
```

---

## 四、验收判据（设计完成后应满足）

| # | 判据 | 门限 |
|---|---|---|
| V1 | 纯水平旋转数据上，`c` 的沿锥轴分量漂移 | **< 0.3°**（当前设计实测 119~342 counts ≈ 0.8~2.4°；需再压低，见下"待办"） |
| V2 | 全姿态数据上，在线 `c` 与 magmap 逐录制球心差 | **< 0.5°**（实测 0.25~0.49° ✅） |
| V3 | 在线 `c` 相对离线常量的偏离 | 在无环境变化时 **< 1°** |
| V4 | 场强 `|B|` 中位稳定 | 跨会话 σ < 1% |
| V5 | 阶跃告警 | 人为贴磁体后 60 s 内告警 |

---

## 四点五、自陷点分析与精度预算（2026-10-14 补充，关键）

### A. 为什么"弱可辨识方向"绝不能"勉强标定"

```
严格冻结: 该方向根本不在参数里 ⟹ 保持离线先验 ⟹ 误差 = 先验误差（已实测 0.82°）
勉强标定: 该方向在参数里但信息量不足 ⟹ 解由噪声/病态决定 ⟹ 误差可任意大，
         且会反过来污染下一拍的可辨识结构与门控 ⟹ 【自陷】
```

**实测证据（本设计的递推版，`t3f_recursive.py` 第一版）**：
`c` 从 `[129652 131607 131318]` 发散到 `[-236742 120596 285388]` 并**稳定停在那里**。
这就是自陷点的活体标本：`c` 错 ⟹ `N=(m−c)/|m−c|` 错 ⟹ 基 `B` 错 ⟹ 解出的 `c` 更错。

### B. 反馈回路穷举与切断（自陷源清单）

| 回路 | 路径 | 状态 | 切断方式 |
|---|---|---|---|
| A | `c` → `N=(m−c)/\|m−c\|` → 基 `B` → 解 → `c` | **实测自陷** | 基的参考**固定为 `c_off`**，禁止用当前 `c` |
| B | `c` → 门控 `\|\|m−c\|−\|B\|\|` → 样本集 → 解 → `c` | 隐患 | 门控用固定先验 `c_off`，带宽取宽（±5%） |
| C | `c` → 残差 → 置信度 → 更新率 → `c` | 隐患 | 更新率固定，不由残差自适应 |
| D | `c` → ESKF → 姿态 → 磁处理 → `c` | **天然切断** | 观测量只用 `\|m−c\|=\|B\|`，**不含姿态** |
| E | `c` → ESKF → 重力门 → 样本集 → `c` | **天然切断** | 门控用**原始加计**，不经 ESKF |

**⟹ 安全设计的硬条件：A 必须切；B/C 必须显式断开；D/E 由"免姿态"天然满足。**

### C. 精度预算（用实测数字闭合）

```
|B| = 8316 counts(三维)   |B_h| = 4002 counts(水平)   放大因子 1/cos(dip) = 2.08

环节                        误差贡献              折算航向误差
离线常量 vs 六面金牌        118 counts            1.69°
逐录制球心跨会话            中位 0.75° / max 2.83° 1.6° / 5.9°
同录制前后半漂移            158.6 counts          2.27°
弱方向"勉强标定"            119~342 counts        1.7° ~ 4.9°    ← 可接受上限
弱方向"自陷"                7500~9700 counts      107° ~ 139°    ← 灾难，必须杜绝
拟合噪声底                  122 counts            1.75°
地磁自身噪声(γ σ)           0.737°                0.74°

闭合验证: 1.69² ⊕ 1.75² ⊕ 0.74² 开方 = 2.56°
          实测【融合后固件内部 mag_resid 中位 = 2.18°】⟹ 预算闭合 ✓
          （这就是任务②-3 项"精度符合单验结论"的定量答案）
```

### D. 由预算推出的设计安全界限（新增硬约束）

```
S1 在线修正幅度硬限幅: |Δc| ≤ 300 counts
      理由: 300/4002 = 4.3°，与噪声同量级；超出则拒绝更新并置告警
S2 灾难门槛: |Δc| ≥ 3000 counts 视为自陷征兆 ⟹ 立即回滚到 c_off + 报警
S3 弱可辨识方向【严格冻结】，不得"勉强标定"
      理由: 该方向对误差的贡献是 1.7°(冻结) vs 107°(自陷)，差 60 倍
S4 无跨窗状态: 每次更新【独立】求解，不累积正反馈（放弃递推式累积）
S5 不可自愈性认识: 一旦错误零点写进运行状态，该次上电全程航向带
      δψ ≈ (δc_⊥/|B_h|) 的航向正弦偏置，滤波器无法区分 ⟹ 只能靠限幅预防
```

### E. 修订后的算法（相对 §3.2 的变更）

```
取消: 递推累积可辨识矩阵 SM（会产生回路 A/C 的跨窗正反馈）
改为: 每次更新只用【一个固定长度窗口】独立求解，且
      ① 基 B 由【固定参考 c_off】下的法向计算（切断回路 A）
      ② 门控用固定先验 c_off（切断回路 B）
      ③ 更新率固定（切断回路 C）
      ④ 更新量硬限幅 ±300 counts（S1），超限拒绝并告警
      ⑤ 拒绝后【不做任何状态累积】，下一窗口从 c_off 重新出发（S4）
```

---

### F. 最终验证结果（`t3g_safe.py`，无自陷安全设计）

```
工况                         维数  w3/w1          max|c−c_off|    与magmap差   结论
六面整圈(全姿态)             2→3   0.086~0.188    102.4 counts    33~84 counts  ✅ 收敛
230659(纯水平慢转)            1    0.00003~0.004  300(限幅)       8270(注)      ✅ 未失控
233844(混合)                 1→2   0.0001~0.011   300(限幅)       153~296       ✅ 未失控
234141(含翻滚)                1    0.0002~0.0007  300(限幅)       314~319       ✅ 未失控
000534(静止为主)              1    ~0.0000        300(限幅)       307           ✅ 未失控
```
（注：`230659` 的 magmap 球心自身退化，R=4098、几何门判不可用，不是可靠参照。）

**对比递推版**：同一批数据上递推版发散到 `[-236742 120596 285388]`（航向误差 ~10⁴°），
安全设计把最大偏离压在 **300 counts**（航向当量 4.29°）⟹ 改善约 **2.4 万倍**。

### G. 关键发现：**两道门都需要，而且安全网是限幅**

```
· 子空间约束 → 防【维度灾难】（冻结不可辨识方向）—— 六面/纯水平都已验证有效
· 硬限幅     → 防【噪声驱动偏移】—— 但实测弱激励工况【频繁打满限幅】
  ⟹ 说明：在姿态多样性不足时，连"被识别出的那一维"也在跟噪声走
  ⟹ 单靠子空间约束【不够】，限幅才是最终安全网
· ⟹ 因此还需第三道：激励准入
     要求 λ1/M（归一化激励强度）超过阈值，否则【本窗不产生任何更新】
     典型: 000534(静止为主) 的 w3/w1≈0，应直接判"本窗不可标定"而不出解
```

### H. 三道门 + 一道网的最终架构

```
① 极性门  : 仅 SET（pol==0）
② 样本门  : |ω|<50 dps 且 | |a|−1 |<0.05 且 场强带（用固定先验 c_off 判）
③ 激励门  : λ1/M ≥ 阈值（不够则本窗【不出解】，而不是出个勉强解）
④ 冻结+限幅: 基 B 只取 λ_k ≥ 0.10·λ_max 的方向；|Δc| ≤ 300 counts，超限拒绝并告警
```

---

## 七、数据判决与最终设计（2026-10-14）

> **本节经过一次自我否证与重做。** 第一版（§7-旧）依据"在线校正量摆动且偏离离线值
> 2000~7000 counts"得出"关闭在线校正"。**该结论已被审计推翻**，原因是我自己的
> 估计器有两个缺陷（见 §7.1）。保留全过程以便复核。

### 7.1 【审计】为何曾得出"偏离数千 counts"——两个自身缺陷

**自洽性前提**：离线常量 `MAG_ZERO_*` 已验证距六面金牌 SET 球心仅 **118 counts = 0.82°**。
⟹ **任何正确的在线估计器都应落在离线常量附近（百 counts 量级）**；
若给出数千 counts 偏差，**必是实现有 bug**，不能归因于"激励不足"。

**逐级加功能的审计（`t3i_audit.py`）**：

| tag | V0 magmap(参照) 与c_off | **V1 朴素全样本** 与c_off | **V2 +样本门** 与c_off | V3 +子空间 与c_off |
|---|---|---|---|---|
| 六面整圈 | 118.7 | **118.7（与V0逐位相同）** | 121.1 | 121.1 |
| 230659 | 8544.1 | **8544.1（同V0）** | 8481.0 | **4.7** |
| 232607 | 342.3 | **342.3（同V0）** | 316.4 | 316.4 |
| 233844 | 151.9 | **151.9（同V0）** | **4859.2** | 786.2 |
| 234141 | 55.8 | **55.8（同V0）** | **3827.7** | 3473.9 |
| 235545 | 135.1 | **135.1（同V0）** | **9100.3** | 7978.6 |
| 000534 | 10.4 | **10.4（同V0）** | **8681.8** | 8522.0 |

**结论：**
```
缺陷① 【样本门有害】 V1（全部样本）与 magmap 逐位相同 ⟹ 数据口径与球拟合都对。
       加上 |ω|<50 dps 且 | |a|−1 |<0.05 的门后偏离 3800~9100 counts。
       根因: 该门是为【姿态辅助拟合】准备的（那才需要姿态准）；
             而本设计是【免姿态】的（只用 |m−c|=|B|），磁计数在任何转速下都有效。
             ⟹ 该门既无必要，又因筛出的样本与姿态强相关而引入严重偏置。
缺陷② 【窗太短】 切 12 窗（每窗 ~8%）时 σ|Δc| 达 2200~5200 counts；
       窗加长到 ≥30% 后降到 27~110 counts。
```

### 7.2 去门后的窗宽扫描（`t3j`，最终依据）

```
σ|Δc| (counts)
数据         10%    15%    20%    30%    40%    50%   全样本
六面         460    134    101     31     27     37    118.7
232607      4372   4161   4192   3476   2468   3222    342.3   ← 纯平动，永不收敛
233844      3197   2968    333     79     90     62    151.9
234141      3938   3846   3183     32     65     65     55.8
235545      3340     89   3457     90     45     89    135.1
ARC13       3200    819    812     98    110     80    167.4
```

**两条硬结论（取代 §7-旧）：**
1. **窗 ≥30% 时 σ|Δc| = 27~110 counts，与全样本偏差（56~168）同量级 ⟹ 在线估计【收敛且正确】✓
   ⟹ 在线零点校正在技术上【可行】；其可达精度 ~100 counts ≈ 0.7° 航向，优于离线常量的 1.69°。**
2. **唯一真正无信息的是 `232607`（纯平动、零转动）：任何窗宽都不收敛（2468~4372）⟹
   需要【覆盖率/激励门】把它挡掉。这不是"窗不够长"，是真的没有姿态多样性。**

### 7.3 最终设计（修订版，取代 §四点五 与 §7-旧）

```
D0 【窗长】滑窗 ≥ 会话的 30%（或等价的长时标累积，时间常数 ≥ 数分钟）。
       理由: §7.2 —— 窗 ≥30% 才收敛；短窗解是病态噪声，必须丢弃。
D1 【取消运动门】不做 |ω| 门、不做 |a| 门。
       理由: §7.1 缺陷① —— 免姿态估计器不需要，且会引入姿态相关偏置。
       仅保留: 极性门（仅 SET）。若需防"加计不可信"，只把它用在【健康判定】上，
       绝不用于筛标定样本。
D2 【覆盖率/激励门】用 λ1/M（归一化激励强度）判本窗是否可标定；
       不够则【本窗不出解】。用于挡掉 232607 那类纯平动、零转动工况。
D3 【子空间冻结】基 B 只取 λ_k ≥ 0.10·λ_max 的方向；不可辨识方向严格冻结在 c_off。
       理由: 实测 230659（纯水平旋转）下，这个约束把偏差从 8544 压到 4.7 counts（1800 倍）。
D4 【硬限幅】|Δc| ≤ 300 counts（≈3×收敛值）。超限 ⟹ 拒绝更新 + 告警。
D5 【无递推反馈】每窗独立求解，不跨窗累积状态。
       理由: 递推版实测自陷并发散到 −2e5（`t3f_recursive.py`）。
D6 【阶跃告警】若要捕捉"贴磁体/换安装"的阶跃，用 |B| 模长与残差判定并告警，
       不靠自动挪零点（阶跃期短窗解不可信，见 §7.2）。
```

### 7.4 与固件现状的关系

```
固件现状: 离线常量 + 不做在线零点跟踪 ⟹ 零点误差恒为已知的 0.82°(航向 1.69°)
本设计  : 可把该误差压到 ~0.7° 航向，代价是要实现长窗球拟合 + 3x3 特征分解 + 三道门
⟹ 属于【可选优化】而非【必需修复】；若不做，现状也是安全的。
⟹ 但 §7.1 缺陷① 的教训必须记住: 任何为"姿态辅助"设计的门，
   都不能搬到免姿态的估计器上。
```

### 【已作废】旧 §7 的 A/B/C/D 四小节

> 旧版据「Δc 摆动且偏离离线值 2000~7000 counts」得出「关闭在线校正」。
> **该结论已被 §7.1 审计推翻**：那是我的样本门（与姿态强相关，
> 引入 3800~9100 counts 偏置）与短窗病态（σ 2200~5200 counts）两个自身缺陷叠加的假象。
> 去门 + 长窗后 σ|Δc| 降到 27~110 counts，估计器收敛（§7.2）。
> **一切以 §7.1~§7.4 为准。** 全文删除上述四小节以免误引。

### 7.5 【正面效果证明】收益存在但可忽略；且风险远大于收益（`t3k_benefit.py`）

**一致性只是最基本的交叉校验。** 要证明正面效果，必须比"用离线常量"更好。
姿态不可用作参照（循环），故用**免姿态判据**：模长一致性 `RMS(|m − c|)` ——
它就是球拟合的目标函数，`c` 越准残差越小，且完全不含姿态。

三种零点对比：`c_off`（固件离线常量）、`c_win`（在线算法，会话后半长窗）、
`c_rec`（该录制自身球心 = 逐会话 oracle = 在线标定的理论上限）。

```
tag        RMS(c_off) RMS(c_win) RMS(c_rec)   离线当量°  在线当量°  oracle当量°
六面整圈        92.7      66.5      56.4       0.638     0.458     0.389
ARC09           99.4      66.0      65.0       0.685     0.455     0.448
ARC10           86.8      69.0      68.5       0.598     0.475     0.472
235545         136.4     125.9     115.3       0.940     0.867     0.794
233844         147.9     130.7     129.6       1.019     0.901     0.893
ARC13          196.1     185.9     180.2       1.351     1.281     1.242
232607         275.4     258.7     256.0       1.897     1.783     1.764
ARC11          333.2     302.8     253.1       2.296     2.086     1.744
000534         130.4     132.5     130.3       0.899     0.913     0.898   ✗
234141         140.1     143.7     138.2       0.966     0.990     0.952   ✗
ARC12          189.9    1077.9     169.6       1.861     5.887     1.662   ✗✗ 灾难

★ 中位方向当量: 离线 0.940°   在线 0.901°   oracle 0.893°
★ 在线改善 0.039°    oracle 改善（理论上限）0.047°   在线捕获 83%
★ 正面对比 11/15（百分比口径中位 +6.378%）
```

**结论（三条，缺一不可）：**
```
B1 正面效果【确实存在】：oracle 可改善 0.047°，在线捕获 83%（0.039°）
   ⟹ 不是"估计器坏"，也不是"无信息"，是真的有一点点收益
B2 但收益【可忽略】：0.039° 相对地磁自身噪声 0.737° 只有 5%，
   相对离线零点折算的 1.69° 航向误差只有 2%
B3 而风险【远大于收益】：ARC12 一个实例就把方向当量从 1.86° 恶化到 5.9°（+4.1°）
   ⟹ 收益 0.04° vs 风险 4.1° ⟹ 风险/收益 ≈ 100 倍
```

**⟹ 工程结论：不做在线零点校正。** 固件现状（离线常量 `MAG_ZERO_*` + 不做在线零点跟踪）
是正确且安全的。理由不再是"估计器有 bug"（§7.1 已修），
而是**收益 0.039° 抵不上任何一点引入自陷风险的可能**。

**⟹ 若仍要做，则必须同时满足（否则风险>收益）：**
```
C1 激励门 λ1/M（挡掉 230659 那类竖直不可辨识、232607 那类零转动）
C2 质量控制门（挡掉 ARC12 那类 usable_for_calibration=False）
C3 收益门：只有当本窗估计与当前零点之差在 yaw 当量上 > 0.1°（> 噪声的 ~15%）才允许更新
C4 硬限幅 ±300 counts + 超限拒绝与告警（§7.3-D4）
```

### 7.6 目前会被在线标定修改的固件常数（唯一清单，已核对源码）

| 常数 | 位置 | 当前值 | 是否该被在线标定改 |
|---|---|---|---|
| **`MAG_ZERO_X_CNT`** | `proc_tune.h:54` | 129652.4f | **★ 是（唯一合法目标）** |
| **`MAG_ZERO_Y_CNT`** | `proc_tune.h:55` | 131607.4f | **★ 是** |
| **`MAG_ZERO_Z_CNT`** | `proc_tune.h:56` | 131318.5f | **★ 是** |
| `MAG_CNT_PER_G` | `proc_tune.h:41` | 16384.0f | ❌ 标度在线不可辨识（需全球面） |
| `MAG_DEV_BIAS_G/UX/UY/UZ` | `proc_tune.h:59-64` | 0.0423 / (.528,−.342,.777) | ❌ **死常数**（仅赋给未使用的 `s_bias_u`；`proc_tune.h:52` 已注明"从未被使用/验证"） |
| `MAG_REF_NX/NY/NZ` | `proc_tune.h:163-165` | 0 / 0.5392 / 0.84218 | ❌ **站点**常数（当地场方向），非安装常数 |
| `ESKF_MAG_PERP_DEG` / `PAR_DEG` | `proc_eskf.c:83,86` | 0.44 / 4.00 | ❌ 观测噪声 R |
| `MAG_MIN_PERP` / `MIN_UNIT` / `ACC_LIMIT_G` / `STALL_FRAMES` | `proc_tune.h:140-145` | — | ❌ 门限 |
| `MAG_COS_MAX_STEP` | `proc_mag.c:49` | cos10° | ❌ 配对连续性判据 |

**使用点**：`proc_mag.c:127-129`  `gx=(cur[0]−MAG_ZERO_X_CNT)/MAG_CNT_PER_G`（同理 y/z）。

### 7.7 【发现的缺陷】`proc_mag.c:145` 的 TODO 推荐了被禁的中点零点

```
proc_mag.c:145-146 原文:
  * TODO(更优)：用 (SET+RST)/2 在线标定器件偏置、净场取 (SET−RST)/2，
  *   则两相样本都可用，且不必硬编码零点。
```
**该写法正是 `地磁解析根因_定位.md` §五-1 明令禁止的 E4 中点零点**
（残余 `|Δ|/2 = 1794 counts = 场强 21.6%`，会产生 ±21.6% 的确定性方向调制）。
**⟹ 这是一个潜伏陷阱：后来者照此实现会引入永久性大误差。必须改掉该注释。**

同段注释里的数字也需更正（来自 `magmap.py` 之前的时代）：
```
"球心距实测 3820~4452 counts"  ⟹ magmap 逐位复现值: 3588.2 counts（六面）
"两相球心距 3820~4452" 与 "28.1°/11.3°/10.1° 残差" 均属未验证时代数字
```

| 脚本 | 作用 |
|---|---|
| `t3a_necessity.py` | §一 必要性（前后半/跨录制球心差） |
| `t3b_identify.py` | §二 可辨识性（各轴跨度、s3/s1） |
| `t3c_design_check.py` | 弱标量正则的失效演示（7500~9700 counts 漂移） |
| `t3d_aniso_design.py` | 各向异性权重构造（未生效，留作反例） |
| `t3e_subspace.py` | 单窗子空间约束（§3.2） |
| `t3f_recursive.py` | 递推累积版 —— **自陷反例**（发散到 −2e5） |
| `t3g_safe.py` | §四点五-F 无自陷安全设计（已验证） |
| `t3h_oscillation.py` | 摆动/单调判决（**含有害门的版本，已被 §7.1 推翻**） |
| **`t3i_audit.py`** | **§7.1 审计：定位"样本门有害"（V0/V1 逐位吻合 magmap，V2 偏离 3800~9100）** |
| **`t3j_sweep.py`** | **§7.2 去门后窗宽扫描（最终依据：≥30% 收敛到 27~110 counts）** |
| **	3k_benefit.py** | **§7.5 正面效果证明（模长一致性 + 方向当量换算）** |

---

## 八、待办（诚实列出未闭合处）

```
U1 §七-C 的阈值 T_ok=150 / T_warn=500 counts 取自本批数据的 3σ 量级，
   样本偏小（13 份录制）。建议扩充会话后再定。
U2 §七-C 未在固件实现，也无 MCU 算力评估（球拟合 + 3x3 特征分解，
   每 30~60 s 一次，算力可接受但未实测）。
U3 未做"人为贴磁体"的阶跃实验来验证 D2 的告警确实触发。
U4 §七-B 显示 1024:1 录制"怎么加宽都不收敛"，其根因（竖直不可辨识）已由
   §二 的 s3/s1 解释，但未做"加入一次 180° 翻转后是否收敛"的验证 ——
   若要给在线方案留后路，这是唯一值得试的方向。
```
