Tokisaki3333/h415-LSM6DSV16XTR/docs/地磁结论信任登记表.md

# 地磁结论信任登记表（Trust Registry）

> **本表是一道闸门。** 任何人（包括 AI 助手）在引用、依赖、或写回固件之前，
> 必须先在表内查到该结论，并满足其"信任级别"要求。
>
> 建立日期：2026-10-14
> 触发原因：本项目的地磁分析长期被**读取口径错误**污染。文档跨越三代口径，
> 而"唯一验明的读取脚本" `magmap.py` 的时间戳是 **2026-10-13 08:26**。
> **凡早于该时刻的地磁说法，一律视为未验证，除非本表记录了我的独立复现。**

---

## 0. 铁律（三条）

1. **唯一验明的读取脚本 = `magmap.py`**（工作区根 + `h415-imu42605-/docs/tools/` + `备份_20261013_S2_源码/tools/`，三处同版）。
   用法只走正路：`M.Frames(path)` → `M.calibrate(fr)` → `M.MagSolver(cal).run(fr)`；
   单样本用 `M.mag_vector(...)`。**不得自造零点、不得碰列号。**
2. **时间戳早于 `magmap.py` 的地磁说法，默认不可信。** 要用，必须先在 §3 留下复现记录。
3. **禁止的三种口径**（`magmap` 的防错层会抛 `ForbiddenConvention`，历史上真实发生过）：
   - **E4 中点零点** `(m_SET + m_RST)/2`
   - **E5 两相混用**（同一球/椭球里混 SET 与 RST）
   - **E6 固定零点**（不做逐录制/逐会话标定就硬编码）

---

## 1. 时间系统（地磁相关文档与脚本，按时间戳升序）

| 时间戳 | 文件 | 相对 `magmap.py` | 地磁可信度 |
|---|---|---|---|
| 09-21 02:36 | `docs/mag360_recording_protocol.md` | 早 22 天 | 未验证（其 `selftest_mag360.py` 已不存在） |
| 09-22 12:26 | `docs/S3_precise_calibration.md` | 早 21 天 | 未验证 |
| 09-23 05:24~06:28 | `docs/ekf_yaw_*.md`、`_archive/.../mag_calibration_log.md`(83KB) | 早 20 天 | 未验证 |
| 10-10 02:24~02:28 | `mag_debug.py` `mag_setrst.py` `mag_quality.py` `mag_shape.py` `mag_check2.py` | 早 3 天 | 未验证（旧口径） |
| 10-11 20:49~21:35 | `mag_new.py` `mag_verify.py` `mag_rst.py` `mag_selfcheck.py` `mag_ab.py` `mag_az.py` `agmag_pc.py` | 早 2 天 | 未验证（旧口径） |
| 10-12 13:37~14:09 | **`docs/mag_calibration_log.md`(113KB)**、`地磁特性实验记录.md`、`地磁修正设计.md`、`MMC5983MA旋转性能问题_阶段成果.md`、`ESKF_锁定事实.md`、`固件落地方案.md`、`文档索引.md` | **早 18 小时** | **未验证（本表 §3 已否证其中一条）** |
| 10-12 14:00 | `_setonly*.py` `_cal45*.py` `_aniso*.py` `_magerr.py` `_zero.py` | 早 18 小时 | 未验证 |
| 10-12 22:37~23:49 | `_aniso90.py` `_zeropair.py` `_zerostab.py` `_tt_zero*.py` | 早 9~10 小时 | 未验证 |
| 10-13 01:53 | **`_zerocal.py`（`Z=(mS+mR)/2` 中点零点源头）** | 早 6.5 小时 | **违反 §0-3，禁止** |
| 10-13 01:56 | `_zero_points.md` | 早 6.5 小时 | **含中点零点，禁止** |
| 10-13 03:02 | `帧结构说明_移交.md` | 早 5.4 小时 | **§五/§六.7 含中点零点，禁止** |
| 10-13 03:09~03:25 | `_colprobe.py` `_root1..4.py` `_anchorv.py` `_mload.py` | 早 5 小时 | 复现脚本，可用 |
| 10-13 03:28 | **`地磁解析根因_定位.md`** | 早 5 小时 | **✅ 已逐位复现（§3-A），可信** |
| 10-13 03:28 | `_gyrotrack.py`（PC 零偏追踪复刻） | 早 5 小时 | 可用（用于 ±2g 批次） |
| 10-13 05:44 | `地磁逐相球心_固件常量.md` | 早 2.7 小时 | 未逐条验证 |
| **10-13 08:26** | **`magmap.py`** | **基准** | **★ 唯一验明** |
| 10-13 08:40 | `docs/S2_地磁读法与阶段结论.md` | 晚 | 与本表同代 |
| 10-14 | 本表、`t2a/t2bc/t3a/t3b` 各脚本 | 晚 | 本表范围内 |

---

## 2. 三代读取口径（理解时间线的前提）

| 代 | 固件做法 | 数据特征 | 正确用法 |
|---|---|---|---|
| **高频翻转** | 每拍翻转（1040 Hz） | SET:RST ≈ 1:1，两相各数万样本 | 分相各自拟合（`rst_usable=True`） |
| **1024:1** | 每 1024 个 SET 做一次 RST | SET:RST ≈ 1024:1，RST 仅 15~91 个 | **只能 SET-only**（`rst_usable=False`） |

**实测证据（本表作者复现）**：
```
六面整圈84B（高频翻转）  : n_SET 51986 / n_RST 51993  (50.003%)  rst_usable=True
14 份 1024:1 录制        : n_RST  15~91 (0.091~0.100%)         rst_usable=False
```
**⟹ 高频/低频的差别不在物理，而在 RST 的样本数。** 高频时代两相都能拟合；
低频时代 RST 无法拟合，故 `magmap` 判其不可用。

---

## 3. 结论级登记（逐条）

### 3-A ✅ 已验证：两相是两个不同心的球

| 项 | 结论 | 复现方式与结果 |
|---|---|---|
| 数据 | `证据链归档_20261013/02_加计交叉验证_六面整圈84B.bin`（= `rec_20261012_031605`） | 84 B RAW，全姿态 |
| SET | center `[129732.75 131572.02 131238.61]`，R=8316.6，残差 **0.678%**，n=51986 | `magmap.Frames→calibrate→MagSolver` |
| RST | center `[133038.92 130480.38 132106.24]`，R=8320.5，残差 **0.700%**，n=51993 | 同上 |
| 两相球心距 | **\|Δ\| = 3588 counts = 场强的 43.15%**；半径比 0.99953 | 同上 |
| 判定 | **两相不可混用**；分开后传感器干净到 0.7%，真实各向异性仅 ~1.2% | — |
| 与 `地磁解析根因_定位.md` §E2 比对 | **逐位一致（小数点后 1 位全部相同）** | ⟹ 该文档可信 |

### 3-B ❌ 已否证：`mag_calibration_log.md`（10-12）§9.4 "RESET 零点相对 SET 有约 2.04° 常数偏移"

**用 `magmap` 实测同一份六面数据**：两相球心距 3588 counts，
折算方向偏移 `atan2(3588, 8316) = 23.3°`，**不是 2.04°（差 11 倍）**。
**⟹ 该条不可引用**（疑似来自中点口径或被"每拍翻转"时代的某种混算）。

### 3-C ⚠️ 未验证但**获得独立佐证**：γ σ = 0.820°（9 个 45° 停泊点）

**本表作者独立复算**（免姿态量 `γ = angle(a_g, m)`，14 份录制 + 六面）：
```
γ σ 中位 0.737°（范围 0.382~1.722）   vs 文档 0.820°   ⟹ 一致
```
**⟹ 可引用，但引用时须注明"由本表作者独立复现"而非"文档如此"**。

### 3-D ❌ 已更正：文档译读错误（本表作者自己犯的）

`mag_calibration_log.md` §7.1 "绝对残差 −8.5 / −16.4 / −26.8°，由站位/摆位硬磁主导"
**被本表作者误读为"换摆位硬磁可达 27°"——荒谬。**
正确读法：恒定体坐标硬磁 `c` 产生的航向误差是
`δψ ≈ (c_⊥/|B_h|)·sin(ψ−φ)`，是**随航向的正弦**；8.5/16.4/26.8 只是同一硬磁在三个航向的取值。
**实测反证**：跨 14 份录制（不同时段/摆放/朝向）的 SET 球心散布仅
**0.75° 中位 / 2.83° max** ⟹ 硬磁跨会话只变 1~3°，绝无 27°。
**⟹ 禁止再用"站位硬磁可达数十度"作为在线标定必要性的论据。**

### 3-E ⚠️ 未验证：`mag_calibration_log.md` §9.4 "高频 RESET 对数据质量有恶劣影响"

其判据为 `σz`（SET 17.2 / RESET 24.5~25.5 counts，1.45 倍）。
**但 magmap 实测六面（高频翻转）的 RST 球拟合残差 0.700%，与 SET 的 0.678% 同档 ⟹
RST 本身是干净的**。该说法至少被夸大，其"恶劣影响"更可能来自**混用两相**而非 RESET 通道。

### 3-F ⚠️ 未验证：`mag360_recording_protocol.md`(09-21) §2 "零空间 6 维 / 1 维"

其自检脚本 `selftest_mag360.py` 在工作区内不存在 ⟹ 无法复现。
**本表作者改用自量指标**（机体系磁场方向的 SVD，`s3/s1`；及各轴跨度）：

| 工况 | mz 跨度 | s3/s1 | 可辨识性 |
|---|---|---|---|
| `230659` 纯水平慢转 | **328 counts** | **0.029** | 竖直不可辨识 ⟹ z 行与 c_z 不可辨识 |
| 六面整圈（全姿态） | 16178 | **0.862** | 三轴充分激励 ⟹ 全参数可辨识 |

**⟹ 该文档的定性结论方向正确，但数字须以本表为准。**

### 3-G ✅ 已验证：固件现用零点 `MAG_ZERO_*` 的精度

```
固件 MAG_ZERO_X/Y/Z_CNT = [129652.4 131607.4 131318.5]
vs 六面金牌 SET 球心 [129733 131572 131239]  ⟹ 差 118.7 counts = 1.427% 场强 = 0.82°
vs 逐录制 SET 球心（13 份合格）              ⟹ 0.07° ~ 2.93°，中位 ~0.75°
```
**⟹ 离线预标定合格。**

### 3-H ✅ 已验证：融合收益（真实录制 A/B）

14 份 168 B 录制，`/DESKF_USE_MAG_OBS=0` vs 现固件，判据 = 场自洽度
（磁场在导航系恒定是物理事实，非拿陀螺当参照 ⟹ 非循环）：
```
改善 中位 +4.086°  均值 +5.812°  范围 −27.5~+32.1  正面 11/14
收益随转动量单调增长（静止 +0.7° → 翻滚 +7.6° → 漂移最大者 +32.1°）
```
**遗留**：`235405` 内部 `mag_resid` 0.328° 而外部场自洽度 55.1°（未闭合，线索：其几何门 `usable_for_calibration=False`）。

### 3-I ✅ 已验证：在线标定必要性（**弱**，且不在漂移上）

| 判据 | 实测 |
|---|---|
| 同录制前后半 SET 球心差 | 中位 **158.6 counts = 1.11°**；拟合残差（噪声底）122.3 counts ⟹ **比值仅 1.3** |
| 跨录制 SET 球心散布 | 中位 **0.75°**，max 2.83° |
| 地磁自身精度 | γ σ = **0.737°** |
| **⟹ 结论** | 离线常量已把零点做到与地磁噪声同量级 ⟹ **在线标定的边际收益只有 ~1° 量级**；其真正价值是**捕捉阶跃变化**（新增磁体/换装夹/换外壳）与**长时漂移**，不是跟随慢漂 |

---

## 4. 工具与脚本登记

| 脚本 | 作用 | 可信度 |
|---|---|---|
| `magmap.py` | **唯一验明**的地磁读取（分相球心、状态机、防错层） | ★ 基准 |
| `mag_standalone.py` | 单验：分相标定/状态机/几何门/\|B\| | 本表同代 |
| `t2a_zero_verify.py` | 固件零点 vs 逐录制球心（§3-G） | 本表同代 |
| `t2bc_fusion.py` | 融合收益 A/B（§3-H） | 本表同代 |
| `mag_gamma_acc.py` | 免姿态精度量 γ（§3-C） | 本表同代 |
| `t3a_necessity.py` | 必要性：前后半/跨录制球心（§3-I） | 本表同代 |
| `t3b_identify.py` | 可辨识性：s3/s1 与各轴跨度（§3-F） | 本表同代 |
| `_root1/2/3/4.py` `_anchorv.py` | 根因复现（§3-A 的独立互证） | 可用 |
| `_gyrotrack.py` | PC 零偏追踪复刻（±2g 批次必需） | 可用 |

**已知坑**：`±2g 批次`（未写 `CTRL8`）上报 \|a\|≈8.04，须 ÷8；
`pc_chain_main.c` 里的 `if (an > 3.0f) al /= 8.0f;` 就是为它。`magmap` 已处理该修正。

---

## 5. 使用流程（强制）

```
1. 拿到一个地磁结论 → 在 §3 里查
2. 查不到 → 该结论【不存在】，必须自己用 magmap 复现并新增条目
3. 查到但级别为"未验证" → 不得引用；须先复现并升级条目
4. 查到"已否证" → 禁止引用，且在代码/文档里若发现依赖它，须一并修正
5. 任何新写入固件的常数，必须在 §3 留下"来源 + 复现方式 + 数字"
```
