Tokisaki3333/h415-LSM6DSV16XTR/docs/S2_地磁读法与阶段结论.md

# S2 阶段结论 + 地磁读法防错清单

**日期**：2026-10-13
**交付录制**：`20261013_S2阶段已达成目标_地磁基准陀螺残差.bin`（= `rec_20261013_082322.bin`，168 B v4）
**本文件的目的**：让任何人看过之后**不再重复本阶段我犯过的 6 个错**。前 4 个是真实犯下的，后 2 个是"看似合理但会被数据否掉"的陷阱。

> 阅读顺序：先看 §2 的错误清单，再看 §1 的已核实事实，最后 §3 的正确工作流。
> **凡与本文冲突的早期 md 文档，一律不作依据**（`magmap.py` 文件头的 D1 原则同样适用）。

---

## 1. 本阶段新核实的事实（都有一份录制或一次测量作依据）

| 项 | 值 | 依据 |
|---|---|---|
| v4 帧长 | **168 B**（= v3 的 164 B + `[41] ts_lo24`） | 解析步长实测 168；`magmap` 已加支持，`layout_v=4` |
| 磁 counts 位置 | **col23..25（当前拍）/ col26..28（上一拍）** | `magmap` C3；实测两域数值完全重复 |
| `col14..16` | **`mag_u`，本版固件写死 0** | 实测 100% 为 0；`magmap` E8 |
| 磁计数数值域 | 122925 ~ 139855（18 位，中心偏移 ≈131000） | 本录制统计 |
| `MAG_CNT_PER_G` | **16384.0**（±8 G 满量程，名义零点 131072） | 器件手册；球拟合 R=8304 counts ⟹ 0.5068 G ✓ 地磁场量级 |
| 地磁采样率 | **≈1 kHz**（实测 `new_mag` = 10.17% × 7677.5 = 781 Hz） | 本录制 + 用户确认"地磁频率 1 kHz" |
| MMC 一次测量耗时 | **0.5 ~ 1 ms** | 用户确认（**不是 10 ms**，见 M2） |
| RST 样本数 | **35 / 34970** ⟹ 只能 **SET-only** | `magmap` C7；`calibrate` 的 `info['rst_usable']=False` |
| `mag_valid` | **0.00%**（固件不把地磁送进 ESKF） | flag bit0；`proc_mag.c` 未算 `mag_u` |
| 椭球(软磁)各向异性 | **仅 0.4%** | `_ellip_set.npy` 的 Q 对角 1.4727/1.4607/1.4715e-8 ⟹ 半轴比 1 : 1.00411 : 0.99959 |
| 椭球交叉项 | 约为对角元的 0.5~0.7% | 同上（Q 非对角 −7.96e−11 / −3.14e−11 / −5.58e−11） |
| 椭球等效半径 | 1/√1.4727e−8 = **8241 counts = 0.5030 G** | 与 `magmap` 的 8304.2 = 0.5068 G 相差 0.7% |

---

## 2. ★ 错误清单（本阶段我真实犯过 / 险些犯下）

### M1 —— 把 `|B|` 的模长起伏当成"地磁误差"或"环境场梯度" ❌

**我当时的推理**：图上 `|B|` 在运动段有 ±7~8% 的大幅摆动 ⟹ 地磁在运动中不可用。

**为什么错**：**模长起伏不代表角度误差。** 地磁的角度精度是典型 **±0.5°、且与速度无关**（先前实测）。模长会被以下因素改变而角度不受影响：传感器在非均匀场中平移、运动引起的真实场扰、乃至标定残差。

**正确口径**：
```
只用【方向】：v = mag_vector(...);  v /= |v|
模长可以完全丢弃，不进入任何误差量。
判据用【角度】，不用【模长】。
```

---

### M2 —— 把磁-姿态残差里的 18° 归因于 MMC 的"10 ms 测量延迟" ❌

**我当时的推理**：MMC 一次测量 10 ms，2000 dps 下就是 20°，正好解释观测到的 18° 振荡。

**为什么错**：**MMC5983MA 一次测量只要 0.5~1 ms。** 1 ms @2000 dps 只有 **2°**，两个数量级都不够。

**而且实测直接否掉了"存在时差"这个前提**（见 M5）：Δτ 扫描在 [0, 1 ms] 上**单调上升、无谷底**，最优就是 Δτ=0。

**教训**：**先用已知量级做上限自检**。任何"解释"如果要求某个参数比器件手册差 10 倍，先怀疑解释本身。

---

### M3 —— 拿磁的**净转角**去比陀螺的**路径长度** ❌

**我当时的推理**：`Σ|ω|dt`（陀螺）vs 磁的每样本转角，比值 0.64~0.88 ⟹ 磁在高转速下漏读 30%。

**为什么错**：磁测到的是**净转角 `|∫ω dt|`**，而我算出的是**路径长度 `∫|ω|dt`**。翻滚时**转轴自身在转（锥动）**，路径必然 ≥ 净转：

```
路径 ∫|ω|dt  ≥  净转 |∫ω dt|     等号仅在转轴固定时成立
⟹ 比值 < 1 是锥动的【必然结果】，不是漏读
```

**正确口径**：要比就比同一种量——**陀螺必须取矢量积分的模 `|Σ ω·dt|`**，不是标量积分的 `Σ|ω|·dt`。

---

### M4 —— 以为"套上椭球矫正"能压掉模长起伏 ❌

**我当时的推理**：B 做过椭球矫正，所以起伏是没套软磁矩阵造成的。

**为什么错**：实测椭球**各向异性只有 0.4%**（Q 对角 1.4727/1.4607/1.4715e-8），交叉项 0.5~0.7%。**套上去最多改 0.4%，差 20 倍**，解释不了 ±7~8%。

**另一层**：`magmap.to_gauss()` 本来就**只做硬磁**（逐相球心 `(m − center)/16384`）。这不是缺陷——**C4 的实测结论是分相各减自己球心后残差 0.678%/0.700%，已经够了**；软磁项小到不值得引入。

---

### M5 —— "磁样本与帧姿态有固定时差"（陷阱：无谷底时不要硬凑）⚠

**这个方向本身是对的**（值得测），错的是**结论的读法**。

```
正确做法: 对每个磁样本做 q_true = q[j] ⊗ exp(−ω[j]·Δτ)，扫 Δτ 使 b_nav 最稳
实测结果: Δτ = 0.00 ms → 运动 RMS 2.5920°   （最小）
          Δτ = 0.50 ms → 运动 RMS 2.7360°
          Δτ = 1.00 ms → 运动 RMS 2.8327°   （最大）
          ⟹ 单调上升，无任何极小值
```

**正确的读法**：**无谷底 = 对齐量本就是 0 = 磁样本与帧姿态本来就对齐**。
**错误的读法**（要避免）：因为曲线在边界最小，就去扫描负 Δτ 或扩大范围，硬找出一个谷底。
**单调 + 边界最优 ⟹ 结论就是"无需补偿"。**

---

### M6 —— 量级自检缺失会直接产出荒谬数 ⚠

我在修 M3 时写了个有 bug 的矢量积分，**1.3 ms 内算出 157° 的净转角**。

**自检规则（务必执行）**：
```
任意区间的净转角  ≤  |ω|max × Δt
   本例上限: 2500 dps × 1.303 ms = 3.26°
   ⟹ 算出 157° 就是实现错误，不要往下解读
```
**任何物理量先算它的上限，超了就回头查代码，不要写进结论。**

---

## 3. 正确工作流（照抄即可）

```python
import sys; sys.path.insert(0, '.')
import numpy as np, magmap

fr = magmap.Frames(path)                       # 跳 8192 B；按字节判别布局；168 ⟹ layout_v=4

# ★ calibrate 返回【元组】，不是单个对象
cal, info = magmap.calibrate(fr, prefer='SET')
#   cal['SET'] = PhaseCal(n=…, R=…, 残差=…%, 转轴可辨识=…, cov比=…)
#   info      = {'n_set':…, 'n_rst':…, 'rst_usable':…, 'primary':'SET'}
R = cal['SET'].radius_gauss                    # ★ 属性，不要加括号

# 只取【新磁样本】的帧（C9 卡死判据）
m = fr.new_mask(); idx = np.where(m)[0]
raw = fr.mag[m]; polm = fr.pol[m]              # pol: 0 = SET, 非 0 = RST

for k in range(len(idx)):
    try:
        v, degraded = magmap.mag_vector(raw[k], polm[k], cal, strict_phase=True)  # ★ 也返回元组
        v = v / np.linalg.norm(v)              # ★ 只留方向（M1）
    except Exception:
        continue                               # 该相未标定 ⟹ 跳过，绝不用另一相顶替（C4）

# 地磁当绝对基准量陀螺残差:
#   b_nav = R(q_eskf) · b_body_unit
#   err   = angle(b_nav, mean(b_nav))        ← 这条曲线就是"陀螺残差"
```

**必须遵守的旧约束**（`magmap.py` 文件头，不要绕开）：
```
C1 跳开头 8192 B
C4 绝不用 (m_SET + m_RESET)/2 当零点；两相是两个不同心球（球心距 3588.2 counts = 场强 43.15%）
C5 零点必须逐录制解，不能沿用常量（SET 相球心跨录制 x 差 38、y 差 204 counts）
C6 偏航录制的转轴分量先天不可辨识 ⟹ 用 axis_known=False 标出，倾角不可信
C7 RST < MIN_RST(100) 时只能 SET-only
C9 卡死判据：新磁样本 = mmc_cnt 递增
```

---

## 4. S2 阶段达成情况

### 4.1 门控修复链（每一步都有量化依据）

| 级 | 改动 | 实测量化 | 验证方式 |
|---|---|---|---|
| S1 | **删除自适应残差门** `resid < acc_thr` | 恢复能力 **0% → 97.2%**；低速大残差保全 0.2% → 100% | 离线消融 + 硬件 |
| S2a | 速率门 `ESKF_GRAV_WLIM_DPS` 2.0 → 20.0 | 手端平开门 **48.3% → 85.5%**；`\|ω\|>20` 帧开门率 0% | 五份录制消融 |
| S2b | `Q` 的 `k_s` 项改为**系统性**形式 `2k_s²θ_rot·\|ω\|·dt` | `P` 倾斜 1σ 随转角线性长到 ~24°（旧式只有 0.49°） | 板载 P 六分量实测 + 保真复刻 |
| S2c | **限幅从 `dx` 移到增益 `K`** | resid 13.478° → 3.0°（4.5 倍） | 硬件 `082033` |
| S2d | **关闭 NIS**（阈值 → 1e9） | resid 2.999° → **0.131°**；末段 `grav_open` 0% → **100%** | 硬件 `082322` |

**S2c 为什么必须移到 K 上**：只截断 `dx` 会让**协方差按全额增益收缩、而姿态几乎不动** ⟹ `S = HPHᵀ+R` 塌掉 ⟹ NIS 爆炸 ⟹ 此后永久拒绝。板载实测证据：tilt σ **12.61°(t=16) → 0.36°(t=20)** 而 resid 停在 9.07°。

### 4.2 交付录制的验收数字（`082322`）

```
ready 100%  valid 100%  calib_n 15000
grav_open 总 45.2%
末段: resid 0.131°   grav_open 100.0%
运动后静止段 (t=16):  grav_open 89.4%   resid 0.277°
手持段      (t=20):  grav_open 60.5%   resid 0.317°
大运动段 (t=8/12/24/28): grav_open 0.0~0.3%   ← 正确关闭
```

### 4.3 地磁作为绝对基准的验证结论

```
① 静止段磁自身每样本表观转角 0.14°（陀螺在那里只有 0.0003°）
   ⟹ 0.14° 只能是磁的角度抖动 ⟹ 与"角度精度典型 ±0.5°"一致 ✓
② Δτ 扫描 [0,1ms] 无谷底 ⟹ 磁样本与帧姿态本来对齐，无时差 ✓
③ 残差曲线【光滑、每转一次、幅度受限】而非随机散布
   ⟹ 磁若有角度噪声，扫任何 Δτ 都压不下去；磁若有时差，扫描会出现明显谷底
   ⟹ 二者都没有 ⟹ 磁矢量是干净的绝对基准 ✓

运动段残差: 2.6° RMS / max 18.5°  ⟹ 这是 ESKF/陀螺的真实误差
   （运动中重力门关闭、姿态纯陀螺积分 ⟹ 标度类误差累积，量级自洽）
静止段残差: 7.1° → 2.8° → 7.1°，跨 34,146° 转角【无累积】
   ⟹ 门一开就被重力拉回；静止段看到的是"当次偏航偏置"，不是累计漂移
待办: 用这条干净基准【独立重标 k_s】（先前 636 ppm 是在坏固件上得到的）
```

---

## 5. 归档内容

```
证据链归档_20261013_S2\
  20261013_S2阶段已达成目标_地磁基准陀螺残差.bin      ← 交付录制 (55.0 MB)
  20261013_S2前一步_NIS未关留3度平台.bin              ← 对照: 关 NIS 前
  20261013_S2前一步_限幅在dx导致3度平台.bin           ← 对照: 限幅移到 K 前
  20261013_旧门锁死基线_手持段grav开0pct.bin          ← 对照: 修复前基线
  20261013_五秒保活printf已删_稳态丢帧0.bin           ← 对照: 5s 周期丢帧已消除
  gyro_resid_by_mag.png                               ← 陀螺残差图
  mag_error_082322.png                                ← 误读示范图（见 M1/M4: 那是模长，不是误差）
  README_地磁读法与S2结论.md                          ← 本文件

备份_20261013_S2_源码\                                 ← 复制粘贴备份（未用 git）
  src\  proc_eskf.c proc_chain.c proc_gyro_bias.c proc_mag.c proc_mag_corr.c
        proc_attitude.c main.c justfloat.c mipc_shm.h board_io.c sensor_dma_rx.c
  inc\  proc_tune.h justfloat.h
  pc\   pc_chain_main.c pc_eskf_main.c pc_shim.h build_pcchain.bat build_pceskf.bat
  tools\ magmap.py plot_gyro_resid.py plot_mag.py scan_dtau.py mag_gyro_short.py
```

---

## 6. 待办（本阶段已定位、未完成）

1. **用磁基准独立重标 `k_s`**（现在的 636 ppm 是坏固件时期得的；M5 的方法已经能给出干净基准）
2. **地磁融合的准入门**：`mag_valid` 仍为 0。若要接偏航观测，准入应同时看**场的局部稳定性**与 `|ω|`，且只在准静止窗口更新（M1 的教训：判据用角度，不用模长）
3. **`mag_u` 未算**：`proc_mag.c` 未产出体坐标磁矢量
4. **PC 复刻的一个已知局限**：`s_throt_acc` 注入为 0（板载是自开机累加），因此阈值附近的门抖动相位可能与板载不同；门开合逐帧一致率 99.8%，但个别边界帧会分叉
5. **稳态丢帧 0.18%（634 帧/24 事件）**：属 CDC 背压突发，非主算法问题（`Δq = |ω|·d_real` 已证明板载积分用真实 dt）
