Tokisaki3333/h415-LSM6DSV16XTR/docs/img_gyro_resid_by_mag.png

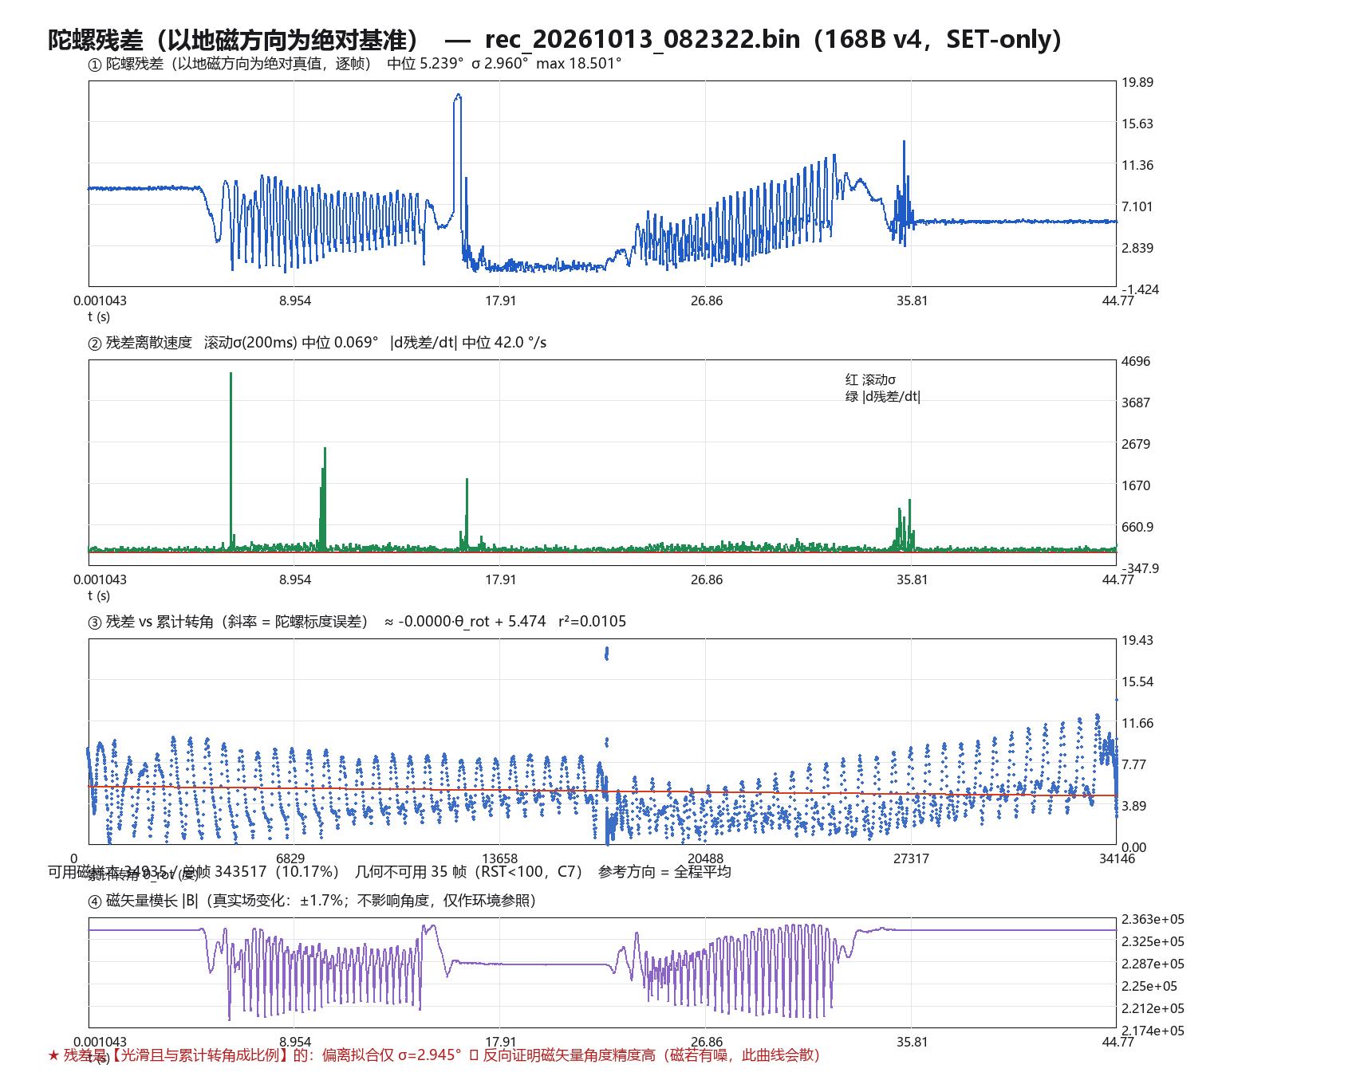
docs/img_gyro_resid_by_mag.png
