Tokisaki3333/h415-LSM6DSV16XTR/docs/img_mag_modulus_misread_demo.png

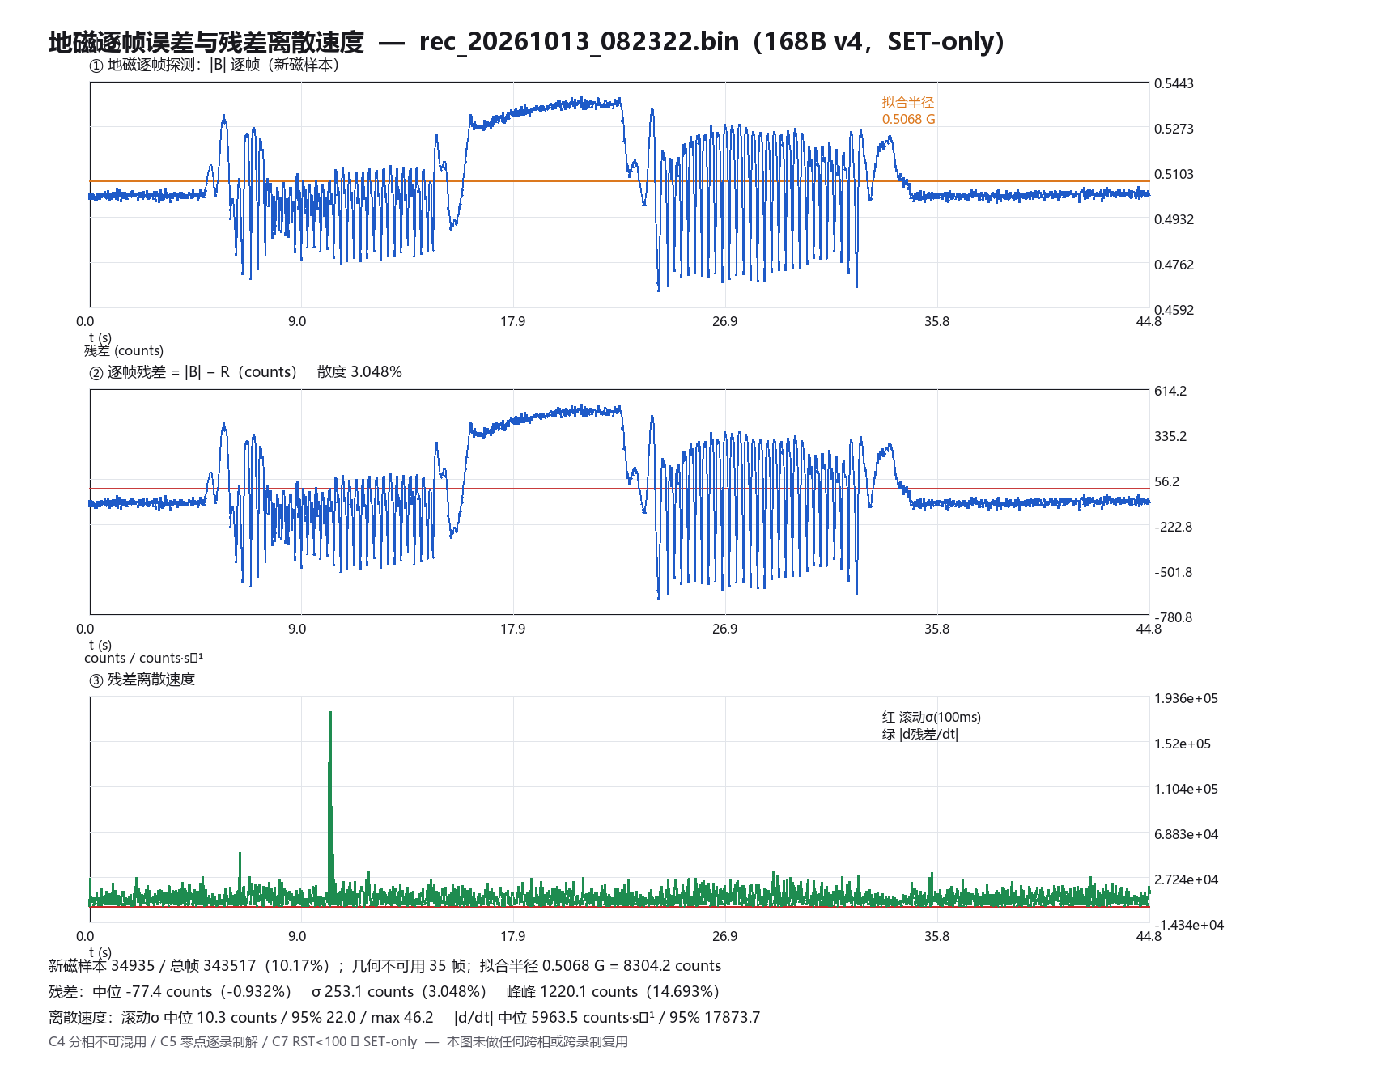
docs/img_mag_modulus_misread_demo.png
