Tokisaki3333/h415-LSM6DSV16XTR/docs/img_mag_show_preview.png

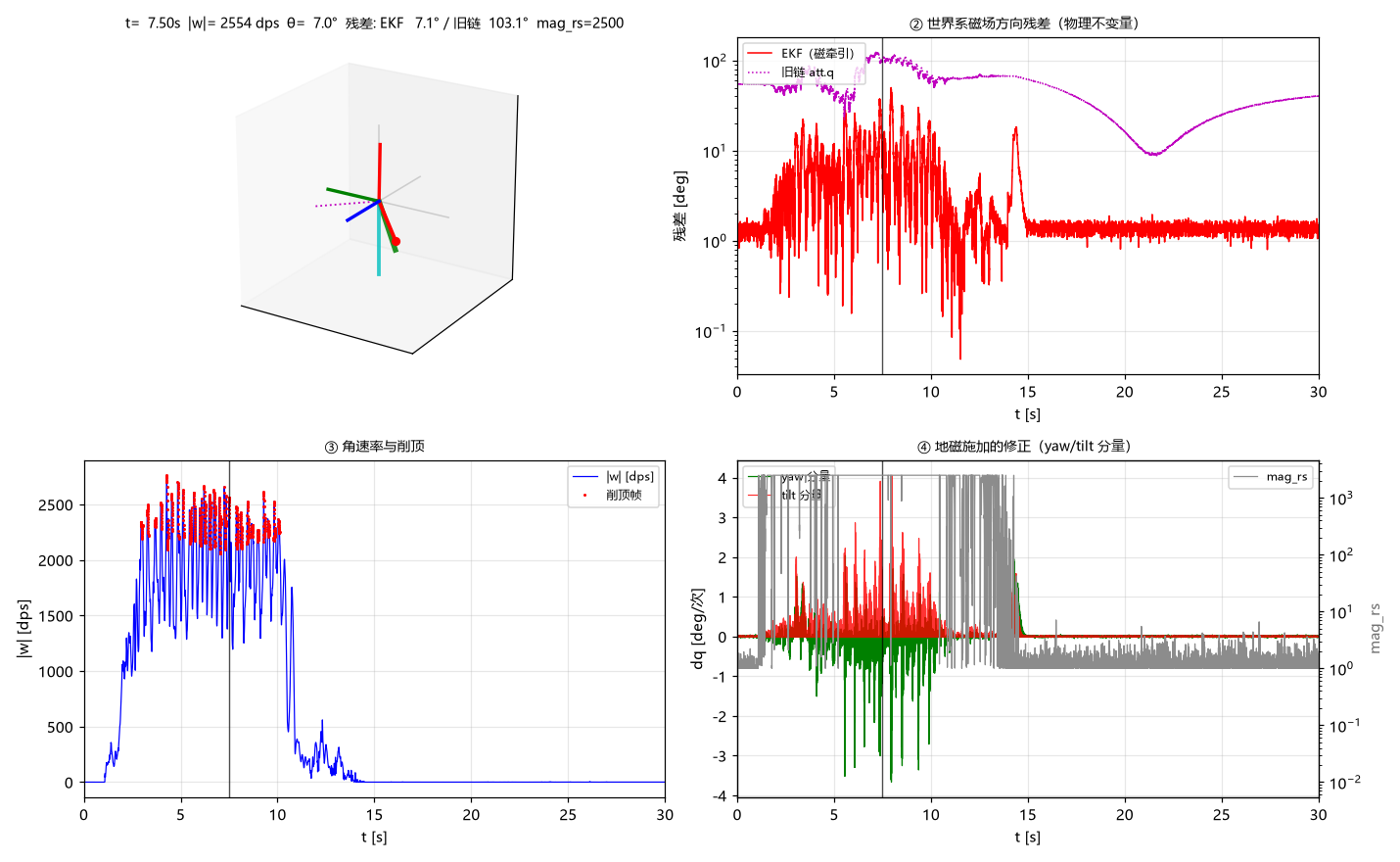
docs/img_mag_show_preview.png
