Tokisaki3333/h415-LSM6DSV16XTR/hardware/calibration_fixture/零件.FCStd

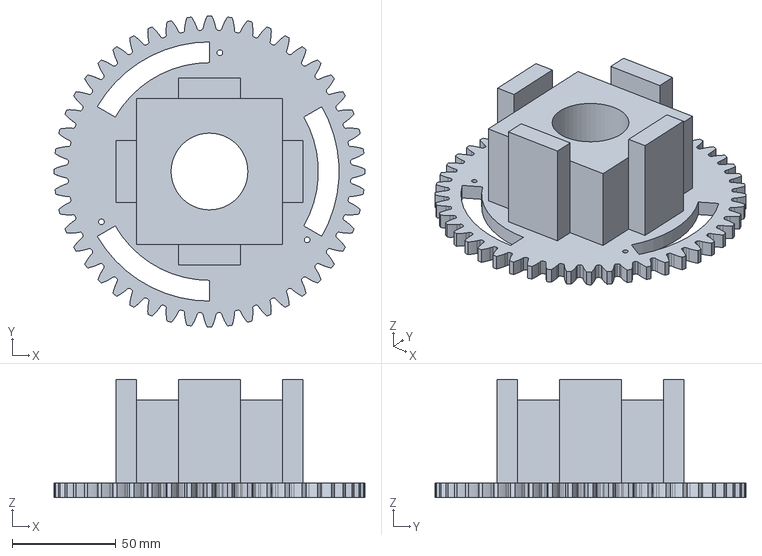
[picture p4: CAD file, 2026-10-14]
hardware/calibration_fixture/零件.FCStd
150.0 x 150.0 x 57.0 mm
