Tokisaki3333/h415-LSM6DSV16XTR/hardware/calibration_fixture/支架.FCStd

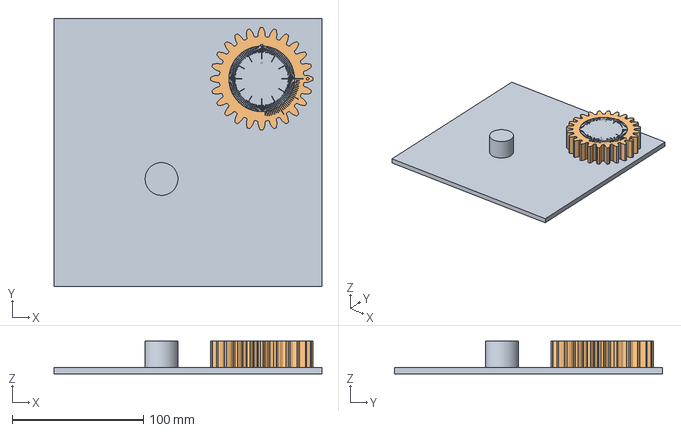
[picture p5: CAD file, 2026-10-14]
hardware/calibration_fixture/支架.FCStd
204.4 x 204.4 x 25.0 mm
