Tokisaki3333/h415-LSM6DSV16XTR/hardware/calibration_fixture/下齿轮.FCStd

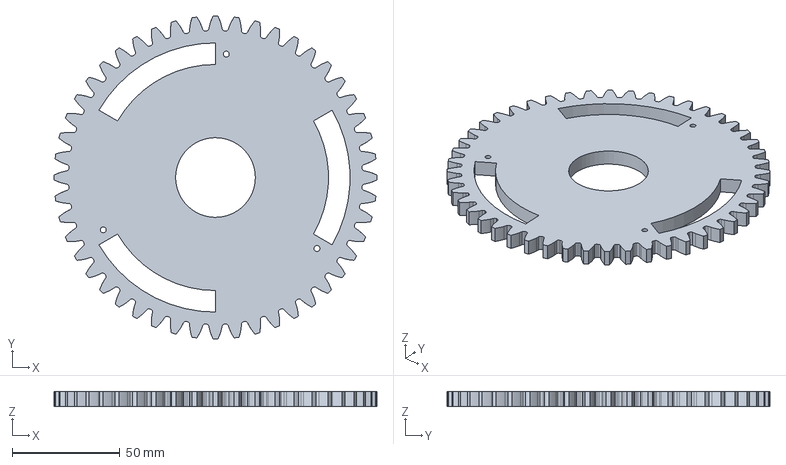
[picture p6: CAD file, 2026-10-14]
hardware/calibration_fixture/下齿轮.FCStd
150.0 x 150.0 x 7.00 mm
