Tokisaki3333/h415-LSM6DSV16XTR/hardware/calibration_fixture/未命名.FCStd

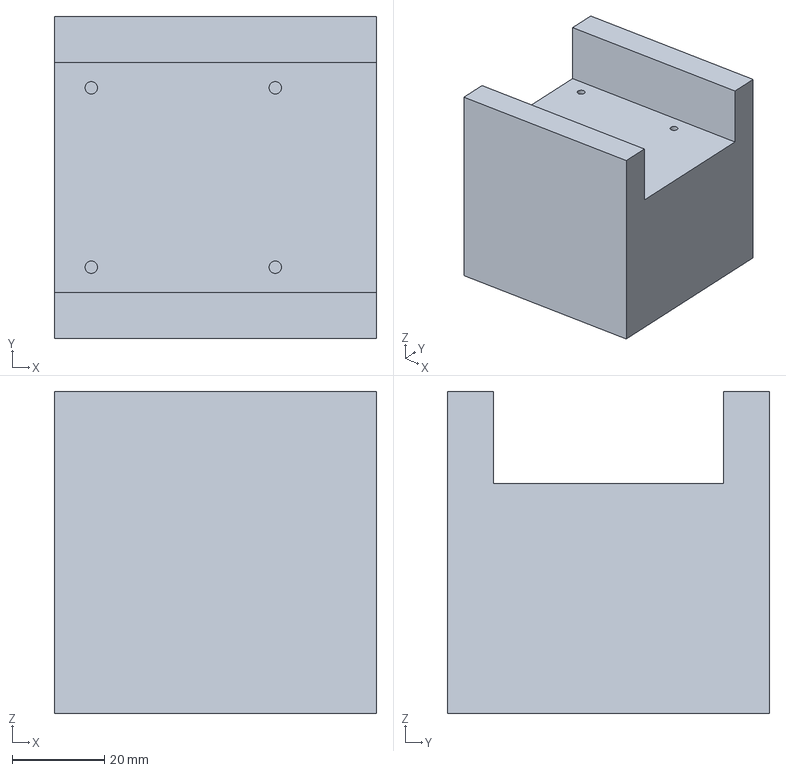
[picture p7: CAD file, 2026-10-14]
hardware/calibration_fixture/未命名.FCStd
70.0 x 70.0 x 70.0 mm
