Tokisaki3333/h415-LSM6DSV16XTR/(list of files, cad)

Other CAD files:
hardware/calibration_fixture/上齿轮.FCStd
hardware/calibration_fixture/齿轮台.FCStd
