Tokisaki3333/h415-LSM6DSV16XTR/docs/mag_calibration_log.md

# 磁标定版本台账（每版 A/C 的完整验证数字，别再丢）

> **最后核对**：早于 2026-10-12 14:09 记录 —— **未经本轮复核**。若与本仓库 2026-10-12 14:09 之后核对的文档冲突，以时间较晚者为准。

## 目录

- [0. 四条判据（缺一不可！）](#0-四条判据缺一不可)
- [1. 版本台账](#1-版本台账)
- [2. 数据清单（都在 `R:\`）](#2-数据清单都在-r)
- [3. 台面(107/108) A/C —— VER=116 现用](#3-台面107108-ac-ver116-现用)
- [4. 下一步（VER=116 的验收与收敛）](#4-下一步ver116-的验收与收敛)
- [5. 工具与脚本](#5-工具与脚本)
- [6. VER=113/114/115 的定责数字（2026-09-21）](#6-ver113114115-的定责数字2026-09-21)
- [7. VER=116 落地记录](#7-ver116-落地记录)
  - [7.1 校验录像 `054928`（VER=115 实机、朝北(不精确)起步、顺时针精确 90°×3、每段静置 9.6~13.5 s）](#71-校验录像-054928ver115-实机朝北不精确起步顺时针精确-903每段静置-96135-s)
  - [7.2 综合测验 `055519`（**VER=116 实机** fw_tag=7643655；正北(外部仪器精确)起步、多次旋转 + 一次大旋转、60 s、7 静置段）](#72-综合测验-055519ver116-实机-fwtag7643655正北外部仪器精确起步多次旋转-一次大旋转60-s7-静置段)
- [8. VER=117 / VER=118：误差模型按标准 KF 方式载入](#8-ver117-ver118误差模型按标准-kf-方式载入)
  - [8.1 VER=117：算力探针](#81-ver117算力探针)
  - [8.2 VER=118：S3 标定结论 → EKF 噪声模型](#82-ver118s3-标定结论-ekf-噪声模型)
  - [8.3 S3 实测标定数字（用于 8.2）](#83-s3-实测标定数字用于-82)
  - [8.4 VER=119：三轴陀螺标度的固定比例修正 + R 降低](#84-ver119三轴陀螺标度的固定比例修正-r-降低)
  - [8.5 【作废 / 从未上机】VER=121：地磁偏航"慢牵引"](#85-作废-从未上机ver121地磁偏航慢牵引)
    - [8.5.1 要抵消的漂移率 = 1000 ppm × 满量程 = 2 dps（**不是** 1.23 deg/h）](#851-要抵消的漂移率-1000-ppm-满量程-2-dps不是-123-degh)
    - [8.5.2 设计准则：**牵引稳态滞后 = 漂移率 × τ ≤ σ_mag = 2°**](#852-设计准则牵引稳态滞后-漂移率-τ-σmag-2)
    - [8.5.3 顺带量出来的三个模型错（不是调参）](#853-顺带量出来的三个模型错不是调参)
    - [8.5.4 改动清单（`patch_v121_magpull.py`）](#854-改动清单patchv121magpullpy)
    - [8.5.5 遗留项（不阻塞本次验收）](#855-遗留项不阻塞本次验收)
    - [8.5.6 验收（烧录 VER=121 后）](#856-验收烧录-ver121-后)
- [8.6 【2026-09-22 回退记录】VER=119/120/121 全部作废，源码回到 VER=118](#86-2026-09-22-回退记录ver119120121-全部作废源码回到-ver118)
  - [8.6.1 本次回退了什么、从哪个备份回退](#861-本次回退了什么从哪个备份回退)
  - [8.6.2 回退后的静态自检（PC 侧，全部通过）](#862-回退后的静态自检pc-侧全部通过)
  - [8.6.3 事后判断：VER=119~121 各改了什么（供定位"乱转"）](#863-事后判断ver119121-各改了什么供定位乱转)
  - [8.6.4 后续铁律（避免再犯）](#864-后续铁律避免再犯)
- [8.7 VER=122 = VER=118 + ①恢复 v119 精度标定 + ②地磁修正速度用 **EKF 标准数学** 实现](#87-ver122-ver118-①恢复-v119-精度标定-②地磁修正速度用-ekf-标准数学-实现)
  - [8.7.1 ① v119 精度标定（原样恢复）](#871-①-v119-精度标定原样恢复)
  - [8.7.2 ② 修正速度为什么必须"以标准数学实现"](#872-②-修正速度为什么必须以标准数学实现)
  - [8.7.3 工作点（实测公式，非仿真）](#873-工作点实测公式非仿真)
  - [8.7.4 "先前讨论值 2 dps" 如何被严格卡住](#874-先前讨论值-2-dps-如何被严格卡住)
  - [8.7.5 上报量的变化（预期，不是回归）](#875-上报量的变化预期不是回归)
  - [8.7.6 验收（烧录 VER=122 后）](#876-验收烧录-ver122-后)
- [8.8 VER=123：地磁→EKF 的**两个入口**（互斥）+ 重力矢量误差估计累加器](#88-ver123地磁ekf-的两个入口互斥-重力矢量误差估计累加器)
  - [8.8.1 两个入口（互斥，一次只执行一个）](#881-两个入口互斥一次只执行一个)
  - [8.8.2 累加器 = 重力矢量（倾角）误差估计（u32 定点，单位 1e-6 deg）](#882-累加器-重力矢量倾角误差估计u32-定点单位-1e-6-deg)
  - [8.8.3 方向正确性](#883-方向正确性)
  - [8.8.4 上报](#884-上报)
  - [8.8.5 事故记录（本轮踩的坑，写下来防再犯）](#885-事故记录本轮踩的坑写下来防再犯)
  - [8.8.6 验收（烧录 VER=123 后）](#886-验收烧录-ver123-后)
- [8.9 VER=124：**验收帧**新增一路 float = 当前地磁入口（0/1/2）](#89-ver124验收帧新增一路-float-当前地磁入口012)
  - [8.9.1 验收帧格式（20 B -> 24 B）](#891-验收帧格式20-b---24-b)
  - [8.9.2 改动清单](#892-改动清单)
  - [8.9.3 验收（烧录 VER=124 后）](#893-验收烧录-ver124-后)
- [8.10 VER=125：把地磁"牵引速度"锁到设计值（幅度门不动）](#810-ver125把地磁牵引速度锁到设计值幅度门不动)
  - [8.10.1 新录像（`R:\imu_20260922_195513.bin` / `_195551.bin`，设备**静止** + 外部磁干扰）](#8101-新录像rimu20260922195513bin-195551bin设备静止-外部磁干扰)
  - [8.10.2 相关性核对（用户要求：先验证总磁大小与 EKF 角度偏移的相关性）](#8102-相关性核对用户要求先验证总磁大小与-ekf-角度偏移的相关性)
  - [8.10.3 本版改动（只有牵引速度，标准 EKF 数学）](#8103-本版改动只有牵引速度标准-ekf-数学)
  - [8.10.4 预期效果（用同一段录像推算）](#8104-预期效果用同一段录像推算)
  - [8.10.5 验收（烧录 VER=125 后）](#8105-验收烧录-ver125-后)
- [8.11 VER=126：恢复"上电一次性磁锚定" + 加"地磁失效门（陀螺一致性，按转速放宽）"](#811-ver126恢复上电一次性磁锚定-加地磁失效门陀螺一致性按转速放宽)
  - [8.11.1 ① 上电一次性磁锚定被减速的根因与修法](#8111-①-上电一次性磁锚定被减速的根因与修法)
  - [8.11.2 ② 地磁失效门（陀螺一致性）——参数由新极限段定](#8112-②-地磁失效门陀螺一致性参数由新极限段定)
  - [8.11.3 验收（烧录 VER=126 后）](#8113-验收烧录-ver126-后)
- [8.12 VER=127：地磁失效门的保持时间与判定条件重定（用户口径）](#812-ver127地磁失效门的保持时间与判定条件重定用户口径)
- [8.13 牵引速度上限（常数 R 地板）在极限运动下的实测 —— VER=128 试验，**未落盘、按用户指示回滚**](#813-牵引速度上限常数-r-地板在极限运动下的实测-ver128-试验未落盘按用户指示回滚)
- [8.14 VER=129：牵引速度回滚到 VER=125 **降低之前**（删除常数 R 地板）](#814-ver129牵引速度回滚到-ver125-降低之前删除常数-r-地板)
- [8.15 VER=130：静止态地磁偏航牵引放开到 **τ ≈ 1.5 s**](#815-ver130静止态地磁偏航牵引放开到-τ-15-s)
  - [8.15.1 病因（为什么"被迫慢慢修正"）](#8151-病因为什么被迫慢慢修正)
  - [8.15.2 实现（仍走 EKF 标准数学：调 P 地板，不夹 K）](#8152-实现仍走-ekf-标准数学调-p-地板不夹-k)
  - [8.15.3 设计校核（`tools/ekf_session/static_tau_check.py`）](#8153-设计校核toolsekfsessionstatictaucheckpy)
  - [8.15.4 验收（烧录 VER=130 后）](#8154-验收烧录-ver130-后)
- [8.16 陀螺质量参数实测（用户口径：静止后重力/地磁的**牵引量 = 运动中积攒的误差角**）](#816-陀螺质量参数实测用户口径静止后重力地磁的牵引量-运动中积攒的误差角)
  - [8.16.1 **更正**：上面 100~300 ppm 是**低估**（用户指出：放回台座过程中已触发过修正）](#8161-更正上面-100300-ppm-是低估用户指出放回台座过程中已触发过修正)
  - [8.16.2 新录像 `imu_20260922_210629.bin`（VER=130，60 s，**量程内**、削顶 0.0%）读数](#8162-新录像-imu20260922210629binver13060-s量程内削顶-00读数)
  - [8.16.3 **更正**：分母必须用**每轴路径角** `∫|w_i|dt`，不是净转角 `∫w_i dt`](#8163-更正分母必须用每轴路径角-widt不是净转角-wi-dt)
  - [8.16.4 205255 #2（tg=16423，r0=42.3°）是**野值**，已剔除](#8164-205255-2tg16423r0423是野值已剔除)
- [8.17 静止性能评估：`imu_20260922_211657.bin`（VER=130，300 s，100% 静止）](#817-静止性能评估imu20260922211657binver130300-s100-静止)
  - [8.17.1 数字](#8171-数字)
  - [8.17.2 **重要发现：静止倾角有 3.25° 的固定静差（两套加速度计零偏不一致）**](#8172-重要发现静止倾角有-325-的固定静差两套加速度计零偏不一致)
  - [8.17.3 VER=130 的"静止 τ=1.5 s"**没有生效**（实际快得多）](#8173-ver130-的静止-τ15-s没有生效实际快得多)
- [8.18 VER=131：EKF **误差状态索引**统一（地基修复，附带揪出一个真 bug）](#818-ver131ekf-误差状态索引统一地基修复附带揪出一个真-bug)
- [8.19 VER=132：偏航通道增广「地磁偏置状态」b_m（落实 M3，取代调 τ）](#819-ver132偏航通道增广地磁偏置状态bm落实-m3取代调-τ)
- [8.20 零漂溯源：`imu_20260923_060100.bin`（**VER=132**，600 s，100% 静止）](#820-零漂溯源imu20260923060100binver132600-s100-静止)
- [8.21 双跟踪器核验：**陀螺侧按设计工作，加速度计侧确诊有问题**](#821-双跟踪器核验陀螺侧按设计工作加速度计侧确诊有问题)
  - [8.21.1 实测（每 60 s）](#8211-实测每-60-s)
  - [8.21.2 两条确诊（加速度计侧）](#8212-两条确诊加速度计侧)
  - [8.21.3 建议（**不动陀螺侧**、不动"双追踪"这个设计）](#8213-建议不动陀螺侧不动双追踪这个设计)
- [9. MMC5983MA 在高角速度下 SET/RST 不可用（2026-10-12 实验追加）](#9-mmc5983ma-在高角速度下-setrst-不可用2026-10-12-实验追加)
  - [9.1 背景：此前"磁倾角误差 ~2~3°"的未解释记录](#91-背景此前磁倾角误差-23的未解释记录)
  - [9.2 实验：改"每拍翻转"为"每 1024 个 SET 周期做一次 RESET"](#92-实验改每拍翻转为每-1024-个-set-周期做一次-reset)
  - [9.3 各向异性集中度（验收指标，取代"磁倾角误差"）](#93-各向异性集中度验收指标取代磁倾角误差)
    - [9.3.1 集中度总表](#931-集中度总表)
    - [9.3.2 逐停泊点倾角（各向异性最直接的体现）](#932-逐停泊点倾角各向异性最直接的体现)
    - [9.3.3 与其他口径的对照](#933-与其他口径的对照)
  - [9.4 结论（重要）](#94-结论重要)
  - [9.5 复现与数据](#95-复现与数据)
  - [9.6 控制变量实验：高频 RESET 是唯一的因（2026-10-12）](#96-控制变量实验高频-reset-是唯一的因2026-10-12)
    - [9.6.1 判据选取](#961-判据选取)
    - [9.6.2 对照表（σz，counts）](#962-对照表σzcounts)
    - [9.6.3 收紧到近静止：排除"运动 + 翻转"的交互效应](#963-收紧到近静止排除运动-翻转的交互效应)
    - [9.6.4 零点随时间的稳定性（逐 1 s 切片）](#964-零点随时间的稳定性逐-1-s-切片)
    - [9.6.5 零点与运动幅度的关系](#965-零点与运动幅度的关系)
    - [9.6.6 机理解释（假说）](#966-机理解释假说)
    - [9.6.7 ⚠ 证据闭环状态（重要标注）](#967-证据闭环状态重要标注)
    - [9.6.8 复现命令与脚本](#968-复现命令与脚本)

---

> 目的：任何一次标定改动的**来源、数字、判据、结论**都在这里，不看对话也能复盘。

> 站点：青岛 36.23N 120.44E，WMM2025 @2026.72：**D = −7.639°，I = +54.330°，H = 30466 nT，F = 52247 nT (52.2 µT)**；

> 磁北极(dip pole) 85.40N 133.50E。固件 `V5F_EKF_DIP_TAN = 1.3932f`。

## 0. 四条判据（缺一不可！）

| 判据 | 工具 | 说明 |

|---|---|---|

| **① 倾角 dip** | `mag_site_check.py`、`mag_dip_tilt.py` | dip = ∠(m̂, ĝ) − 90°（**姿态无关**），必须 = **54.330 ± 0.5°**。**对"绕竖直的旋转/镜像"完全不敏感。** |

| **② 偏航符号** | `mag_yaw_sense.py` | 绕竖直转时须有 `dm/dt = −ω × m`：判 `corr(d·az/dt, −ω_z)`，**斜率必须 ≈ +1.0**；≈ −1 就是镜像（牵引方向反了）。 |

| **③ 已知航向基准** | `mag_heading_datum.py` | 用**用户指定的正方向 + 陀螺测得的转向**做绝对航向，量"机头航向误差"。**完全不用 EKF 四元数**：H = D_WMM − atan2(û·(m_h×a_h), m_h·a_h)，û = **+ĝ**。这是唯一能钉住"方位基准（恒定偏置）"的判据。 |

| **④ 倾角不变性** | `mag_dip_tilt.py` | body dip 必须与**倾角无关**。世界系固定干扰只能产生与倾角无关的恒定偏置；**dip 随倾角摆动 = A/C 的真实缺陷**。 |

**教训 1**：VER=112 只过①不过②（斜率 −1.007），被用户抓到"牵引方向彻底错误"。`dip` 对上、镜像解也能对上 ⇒ **只报 dip 一致就上机是错的**。

**教训 2**：①②对"恒定方位偏置"全都瞎。113/114 那轮就是这么坏的（见 §6）。

**教训 3（我犯过）**：`mag_heading_datum.py` 里 up 轴必须取 **û = +ĝ**。加速度计静止测的是**比力**，+z 朝上读 +1 g，所以 +ĝ 就是世界 up（`mag_dip_tilt.py` 用 +ĝ 得到 +54° 也证明这一点）。取 −ĝ 会让 θ 反号，得到**镜像的假象**——我曾据此误报"A 是左手系、航向被镜像"，已撤回。

## 1. 版本台账

| 版本 | A/C 来源 | ① dip（数据/结果） | ② 偏航斜率 | 结论 |

|---|---|---|---|---|

| VER=102（台面） | 姿态辅助 9 参数拟合，数据 `022718`（roll±180/pitch105），参考=旧链 att.q | 干净点位 51.45°(−2.88°)；同源数据方向残差 0.48~0.95° | **+1.007 ✓** | 符号正确；dip 偏 2.9° |

| VER=108/109 | 台面 A/C + `DIP_TAN=1.3932` | `043248` 47.61°(−6.72°)；`045004`… 普遍偏低 | ✓ | 只改常量无效 |

| VER=110 | **台面形状 + 由 `040450` 重力对齐得到 U（27.4° 旋转）** | `042518` 54.37°(+0.04)、`040450` 54.39°(+0.06)、`043248` 50.61°(−3.7)、`044249` 51.93° | **+0.989 ✓** | 符号正确；本簇 dip 好、跨簇差 3.7° |

| VER=111 | 椭球(非鲁棒)+重力对齐，源 `043248` | 仅 `043248` 54.31°；三轴集 46.8~47.6°(−7°) | — | 采错簇，作废 |

| VER=112 | 三轴 360° 集显式参数化 GN(形状) + 重力对齐(取向) | 拟合集 **−0.06/−0.11/+0.11°**，留出集 −0.26/−0.14/−0.10°，`mag_rs` **1.1** | **−1.007 ✗ 镜像** | 废弃（det>0 = 镜像解） |

| VER=113/114 | 三轴 360° 集 + **以旧链 att.q 作方位基准**的两参考联合解 | 三轴集 53.92/54.64/54.88 | +1.006 ✓ | **回归**：方位做坏 ~15°，dip 引入随倾角的 10° 摆动（§6） |

| VER=115 | 114 的 A/C + 抬高磁 R + 倾斜通道降权 | 同上 | ✓ | 标定层仍承 114 的缺陷；R/降权本身保留 |

| **VER=116（现用）** | **标定层回退到台面(107/108)版**，保留 115 的 R/降权 | 清洁录像水平 51.4/52.4/52.6；随倾角仅摆 4° | ✓ | §7 |

## 2. 数据清单（都在 `R:\`）

| 录像 | VER | 说明 | 用途 |

|---|---|---|---|

| `022718` | 102 | 台面 roll±180/pitch105 | VER=102 拟合源 |

| `030649` | 107 | 台面剧烈 | 内部一致性（res 1.5°） |

| `040450` | 107 | 90 s 全球面翻滚 | VER=110 取向源 |

| `042518` | 108 | 近静止、低干扰 | 独立复核 |

| `043248` | 108 | 62 s 球型翻滚 | VER=111 源（已废） |

| `044249 / 044537 / 044559` | 111 | z / x / y 各 360°，干净点位 | 三轴拟合集 + 偏航判据 |

| `045243 / 045306 / 045327` | 111 | 平静测试集 | 留出校验 |

| `045813 / 050007` | 112 | 剧烈 | 校验（dip ≈ 51.9°） |

| `052531` | 115 | 朝北起步 → z 360° | 磁自愈/重力修正复核 |

| `053123` | 115 | 4 个方位 | 过渡数据 |

| `053518` | 115 | 4 个方位（朝北起步） | **有硬磁干扰（用户确认）⇒ 不作校验** |

| **`053724`** | 115 | **正西起步、4×90°、每段静置 9.7~12.4 s（清洁）** | **VER=116 的方位基准 + dip 基准** |

## 3. 台面(107/108) A/C —— VER=116 现用

```

A = { +7.82513172e-05, -6.10340235e-03, -7.24195460e-05 }

    { -5.97676400e-03, -1.84772880e-05, -1.84887488e-05 }

    { +3.76624289e-04, +7.79929442e-04, +6.05283507e-03 }

C = { +1.41276398e-02, +9.17333192e-03, -1.31003127e-04 }

```

注意其 x/y 行是 `m_x ≈ −6.10e-3·raw_y`、`m_y ≈ −5.98e-3·raw_x`：**标定已内含"感知轴↔机体系"的 90° 交换**，这就是"机头在体系 −y"的来源。

被替换掉的 113/114 A/C（保留备查）：

```

A = { -1.36027568e-03, -5.85658605e-03, -3.98138235e-04 }

    { -5.88783654e-03, +1.42495667e-03, -1.41592015e-04 }

    { +9.07314301e-05, +3.31179736e-04, +6.13699343e-03 }

C = { +1.63036225e-02, -1.31800427e-02, +7.34305183e-03 }

```

## 4. 下一步（VER=116 的验收与收敛）

烧录后在**同一清洁点位**复做"正西起步、4×90°、每段静置 ≥6 s"，核对：

1. **③ 机头(=体系 −y) 航向残差**应回落到 **−8.5° ± 2°**（现役 113/114 是 −23.3°）；

2. **④ 水平 dip ≈ 52°、且不随朝向摆动**（现役摆 9°，台面版只有 2.3°）；

3. **① 静止段 `mag_rs` / `nis4` / `rej`**（应为 rs ≈ 1、nis 小、rej=0）。

残差收敛路线：把同一协议拿到**更干净的点位**（户外/无钢铁）复录。

- 若 −8.5° 与 −2.5° dip 偏置**缩小** ⇒ 确证是站位(世界系固定)干扰，**A 不应再动**；

- 若仍稳定在 −8.5° ⇒ 才把这 8.5° 折进 A 的方位基准（单次绕体系 z 的 R_z 旋转，A 与 C 同时旋转）。

回退：`Copy-Item bak_src\V5F\User\inc\v5f_tune.h.bak_v116 V5F\User\inc\v5f_tune.h -Force`（→ VER=115）。

## 5. 工具与脚本

- `tools/ekf_session/patch_magAC.py` 通用写回（`--ver N --A "行(逗号分隔)"×3 --C "c1,c2,c3"`；备份进 `bak_src/`、宏唯一性 lint、源码树守门）

- `tools/ekf_session/bakpath.py` / `srcdir_clean.py`（备份唯一合法去处 / 守门）

- `tools/calib/`：`mag_site_check.py`（① 绝对项）、`mag_yaw_sense.py`（② 偏航符号）、**`mag_heading_datum.py`（③ 已知航向基准，独立于 EKF）**、**`mag_dip_tilt.py`（④ dip vs 倾角）**、**`mag_chain_cmp.py`（直算磁 / att.q / ekf.q 三链对比 + 磁修正量）**、`mag_ell_cal.py`、`mag360_cal.py`、`mag_motion_diag.py`、`mag_blind_diag.py`、`wmm_site.py`、`mag_show.py`、`cols_162.py`

- 拟合实现：显式参数化（中心 + log 半轴 + 旋转）GN + 列归一化 + 线搜索；**自测**用真实尺度合成椭球（`|u|~175 LSB`、噪声 0.4 LSB），判据 = 轴比误差 <0.5% 且 `|y|` p1~p99 ⊂ [0.99,1.01]

  （注意：早期"自测"把 `A_true` 取成 `1e-3` 尺度 ⇒ 信噪比 0.0025 的假自测，是全部误判的源头之一）

## 6. VER=113/114/115 的定责数字（2026-09-21）

清洁录像 `053724`（正西起步、4×90°、静置 ≥9.7 s）。段序由**陀螺积分**定：步进 −90.17/−86.30/−87.50（与 EKF yaw 步进同号）⇒ 物理转向可信；锚点=正西 270°。

| A/C | det | ③ 机头(−y)航向残差（各段） | 水平 dip−90 | ④ dip 随倾角摆幅（044249/044537/044559） |

|---|---|---|---|---|

| 113/114（现役） | −2.23e−7 | −23.3 / −18.4 / −20.8 / −26.3（摆 8°） | 46.1…55.1 | **10°**（47.5 … 57.6）✘ |

| **台面 107/108** | −2.20e−7 | **−8.5 ± 1.0**（−8.0/−8.7/−7.5/−9.5） | 51.4/52.4/52.6 | **4°**（49.3 … 53.6）✔ |

| 112（det>0） | +2.33e−7 | 交替（+104.9/−80.6/+98.8/−67.9） | 39.9…55.0 | — |

结论：

1. **det<0 是正确手性**；det>0（112）是镜像解，废弃。

2. **113/114 以 att.q 为方位基准的重拟合是回归**：方位坏 ~15°，且给 dip 引入随倾角的 10° 摆动（世界系干扰**不可能**产生随倾角变化，见判据④）。

3. 台面版的 **−8.5° 恒定航向残差**与 **−2~3° 恒定 dip 偏置**都**与倾角无关** ⇒ 属世界系固定干扰（站位），**不写进 A**。

4. EKF yaw **确实被磁锁住**：直算磁航向与 `ekf.q` 的 −y 残差一致到 0.1°（−23.3 vs −23.2）；`gate_ekf_mag_yaw=1`、`nis4≈0.0~0.07`、`rej=0`、`mag_age_ms≈3.4`。（此前"磁通道没起作用"的猜测不成立。）

5. `att.q` 链（磁不闭环，`SPI_rx.c:145` 明注"★ 不写回 att.q"）的航向在机头=−y 约定下也是对的（−0.3°/段），可作为**独立的航向仲裁**。

## 7. VER=116 落地记录

- 改动：只把 `V5F_MAG_A_INIT` / `V5F_MAG_C_INIT` 换回台面版，`V5F_FW_VER 115u → 116u`；**保留** 115 的磁 R（`V5F_EKF_MAG_VEC_SIG_DEG 1.5f`）与倾斜降权（`SIG_TILT_DEG 6.0f` / `TILT_SIG_MAX_DEG 30.0f`）。

- 命令：`python tools/ekf_session/patch_magAC.py --ver 116 --A "7.82513172e-05,-6.10340235e-03,-7.24195460e-05" "-5.97676400e-03,-1.84772880e-05,-1.84887488e-05" "3.76624289e-04,7.79929442e-04,6.05283507e-03" --C "1.41276398e-02,9.17333192e-03,-1.31003127e-04" --note "..."` → LINT OK、`srcdir_clean --check` 0 残留、VERIFY OK。

- 备份/回退：`bak_src\V5F\User\inc\v5f_tune.h.bak_v116`。

- PC 侧复核（清洁录像上）：③ −8.5°(摆 1.0) ／ ④ 4° ／ ② 斜率 +0.9~1.0（非负 ⇒ 无镜像）。

- **未做**：编译烧录与实机复录（按约定由用户编译）。

### 7.1 校验录像 `054928`（VER=115 实机、朝北(不精确)起步、顺时针精确 90°×3、每段静置 9.6~13.5 s）

段序由**陀螺积分**确认：ω_z 步进 −90.16 / −90.10 / −89.65（与"精确 90°"吻合 0.35°，说明陀螺标度好）。已知航向 = 锚点 0° + 顺时针 90° 递增。

| A/C | ③ 机头(−y)航向残差（4 段） | **③ 摆幅**（与锚点无关） | 水平 dip−90（4 段） | ④ dip 摆幅 |

|---|---|---|---|---|

| **116 台面** | −27.7 / −25.8 / −26.6 / −27.0 | **1.9°** ✔ | 50.3 / 48.5 / 52.1 / 50.0 | **3.6°** ✔ |

| 115（113/114） | −38.3 / −39.0 / −43.6 / −43.9 | 5.6° | 53.2 / 46.2 / 49.8 / 53.2 | 7.1° |

- 结论：台面版把方位一致性改善 ~3 倍、dip 摆幅减半 ⇒ **独立复核通过**（判据是摆幅，不受"朝北不精确"影响）。

- 绝对残差：正西清洁录像 −8.5°、朝北 053518 −16.4°、朝北 054928 −26.8° —— **三条各不相同 ⇒ 由站位/摆位硬磁主导，不折进 A**。

- **EKF 侧新指标**：`ekf yaw 步进` 89.43/86.21/89.73 vs `陀螺步进` 90.16/90.10/89.65，第二段差 **3.9°** —— 转动中磁牵引把 yaw 拉偏 3.9°，与 A/C"航向误差随朝向变化"同源；116 摆幅仅 1/3 ⇒ 烧录后该差值应同步变小，作为实机验收项。

### 7.2 综合测验 `055519`（**VER=116 实机** fw_tag=7643655；正北(外部仪器精确)起步、多次旋转 + 一次大旋转、60 s、7 静置段）

| 项 | 结果 |

|---|---|

| ① dip−90（7 段） | 53.19/53.10/51.58/53.40/51.57/52.52/52.83 → 中位 **52.83**，**摆幅 1.8°**（115 是 46~55、摆 9°） |

| ④ 倾角残差（EKF向上 vs 加速度，静） | 0.32~0.56°，p95 0.79°，max 9.61° |

| yaw 复现性（同朝向多次回到） | −171.00/−170.89/−170.91/−171.41 ⇒ **0.5°** |

| 转动中磁牵引拉偏（ekf yaw 步进 vs 陀螺步进） | −0.37/+0.40/**−0.84**/+0.48（115 同指标 3.9°） |

| 磁残差角（世界系 R(q)m vs WMM b） | p50 **1.71°**、p95 4.03°、max 13.52° |

| 磁 R 自适应 | 静置 ≈1.3~2；运动 mean **1541**、max 2500（115 的"运动中不禁磁 + 自适应抬 R"生效） |

| `grav_ok` | 全程 0.678、**运动中仅 0.027**（重力通道在动中被门掉，这正是"大残差"的来源） |

| 陀螺削顶 | 99 帧 >1990 dps（大旋转段） |

**残差 = 重力修正重新启用后的修正量 θ0**：1→2 不动 0.63°(收敛 0.13 s)／2→3 −90° 0.47°／3→4 +90° 0.59°／4→5 −90° 0.27°／5→6 +90° 0.38°／**6→7 大旋转(峰值 2281 dps、削顶 99 帧) 0.38°**。

**结论**：大旋转**没有**出现"必定的大残差"——陀螺积分 −1678°（4.66 圈且削顶 ⇒ 真实圈数更多），结束后 yaw 与转前差 **0.5°**、dip 52.83 与其它段一致、静置倾角残差 0.36°，即磁在高速段被降权、重力通道动中只占 2.7% 开度，误差没被攒下来 ⇒ 通过。

（注：该转移的"窗口内实际姿态修正量"不可信——低陀螺帧落在旋转途中，2 s 窗口含后续物理运动。）

**遗留**：dip 恒定低 1.5°（52.83 vs 54.33）、与朝向/倾角无关 ⇒ 世界系固定干扰或 A 的 z 行尺度残余；要压掉就是单参数（A 的 z 行尺度）。先在第二个干净点位复录确认是否随地点变，再决定动不动 A。想压出"大残差"场景需**带倾角的剧烈运动**（绕 x/y 猛转把重力通道门掉），纯竖直快转对倾角几乎无激励。

## 8. VER=117 / VER=118：误差模型按标准 KF 方式载入

### 8.1 VER=117：算力探针

`SPI_rx.c` 累加器 + `v5f_isr_probe_1s()` + `main.c` 1 Hz 打印。实测：`isr 8029 Hz avg 21 us max 58 us load 16.86% ovr125 0` ⇒ 全链（含 EKF）已在 8 kHz，日志 24× 抽取。

### 8.2 VER=118：S3 标定结论 → EKF 噪声模型

| 量 | 旧值 | 新值 | 依据 |

|---|---|---|---|

| `V5F_EKF_MAG_VEC_SIG_DEG`（磁航向固定 R） | 1.5 | **2.0°** | S3 实测磁残差 p50 1.7~2.15° |

| `V5F_EKF_MAG_VEC_SIG_TILT_DEG`（磁倾斜固定 R） | 6.0（再乘 1/conf） | **3.0°（固定）** | dip/倾角一致性实测 1.5~3°；**删除 conf 抬 R**（`s_mag_rs` 恒 1.0） |

| `V5F_EKF_GYRO_KS`（陀螺标度误差） | — | **5.0e-3** | 50 RPM/360° 实测：X 890 / Y 4860 / Z 1200 ppm ⇒ 取包络 |

| `Q_att` 新增项 | — | **`(k_s·|w|)²`** | 方差随时间 **与总转角** 单调增长（∫k_s²w²dt = k_s²·ω̄·θ）⇒ 与 dip 交叉点 `θ*=σ_m/k_s` 自洽 |

| `V5F_EKF_SIG_BG_RW`（零偏随机游走） | 0 | **1.0e-5 dps/√s** | 极小：**保偏航高通（相对）精度**，只允许极慢漂移被跟踪 |

| `V5F_EKF_P0_BG_SEED_RADS`（播种零偏 1σ） | — | **0.005 dps** | 追踪器（零速直接测量，残余 1.23 deg/h）有效时用 |

| 对齐时 `IX_BG` | 0 | **播种 `h->imu.gyro_bias_dps[]`** | 单向播种、此后 EKF 独占（不连续注入 ⇒ 保住相对精度） |

| `V5F_EKF_TILT_LEV_DPS`（重力门） | 2.0 | **15.0** | 重力牵引更有效收敛姿态；R 已含离心项 a_c=w²r |

### 8.3 S3 实测标定数字（用于 8.2）

- 陀螺 360° 档（50 RPM，夹具闭环 0.1°）：**X −890 / Y −4860 / Z +1200 ppm**；29 dps 慢转档 Y −2387 ppm ⇒ **速率相关标度**（同向不同速可测）。

- 地磁：**同一会话内椭球 rms 0.019~0.030**（球形状极好）；**会话之间硬磁中心差 2.33 µT ⇒ 4.4° 方向误差** ⇒ 全局 A/C 无法优于 ~3°；须 **SET/RESET 周期复位** 或**在线估计零偏**。

- 五装夹联合 dip：纯 dip 目标可达互差 0.26~0.34°（但方位规范漂 6~21°）⇒ dip 与方位不可兼得，证实零偏漂移是根因。

### 8.4 VER=119：三轴陀螺标度的固定比例修正 + R 降低

| 轴 | 360°档实测残差 (50 RPM/夹具闭环 0.1°) | LSB_PER_DPS 修正 | 新值 |

|---|---|---|---|

| X | −890 ppm（359.68°/360°，1 圈@183 dps） | ×0.999111 | 16.2608 |

| Y | −4860 ppm（358.25°/360°，2 圈@297 dps，互差 0.08%） | ×0.995139 | 16.3992 |

| Z | +1200 ppm（360.43°/360°，3 圈@298 dps，互差 ±0.1°） | ×1.001194 | 16.4431 |

- 修正后三轴在 **360° 档的净标度残差 ≈ 0**；剩余是**速率相关标度**（实测 Y：29 dps −2387 ppm vs 297 dps −4860 ppm ⇒ 固定修正后低速率档残留 ≈ +0.25%）。

- 因此 `V5F_EKF_GYRO_KS` **5.0e-3 → 2.0e-3**（覆盖交叉轴 ~500 ppm + 速率相关 ~2000 ppm）⇒ `Q_att` 的转动相关项方差降 **6.25×**。

- 效果：交叉点 `θ_rot* = σ_m / k_s` 由 `2°/0.005 = 400°` 提升到 **`2°/0.002 = 1000°`** ⇒ 大转角下更信陀螺（相对精度优先），地磁介入更少。

- 回退：`Copy-Item bak_src\V5F\User\inc\v5f_proc.h.bak_v119 V5F\User\inc\v5f_proc.h -Force`（tune 同理，bak_v119）。

- 验收（烧录后）：复做 360°/50 RPM 协议 ⇒ 每圈积分应落在 **360.0 ± 0.1°**（现 X 359.68 / Y 358.25 / Z 360.43）；并复测 dip 与已知航向判据不退化。

### 8.5 【作废 / 从未上机】VER=121：地磁偏航"慢牵引"

> **2026-09-22 作废**：本节描述的改动（τ=600 s → R=0.2077 → 闸门 w）**从未烧录**，

> 而且是在**已经被做坏的基线上**（VER=120）推导的。用户实测口径：

> **VER=118 是最后一个好用版本**，VER=119/120/121 已全部回退（见 §8.6）。

> 本节只作推导过程与两条被否路线的记录，**不要照它改代码**。

> 节内"三个模型错"是离线读码得出的判断，**未经硬件验证**，在 §8.6 里重新评估。

复核脚本：`tools/ekf_session/mag_pull_design.py`（解析稳态，非仿真凑数）。

#### 8.5.1 要抵消的漂移率 = 1000 ppm × 满量程 = 2 dps（**不是** 1.23 deg/h）

- `0.58 deg/√h`、`1.23 deg/h` 这类数只描述**静止**。一旦有转动，主角变成**标度/交叉轴误差**：

  用户口径 **满量程 1000 ppm**，ICM-42605 量程 **±2000 dps**（16.4 LSB/dps，`v5f_tune.h` 141 行）

  ⇒ 不可建模漂移率 = 1000e-6 × 2000 dps = **2 dps = 7200 deg/h**（比例于 |w|，零偏跟踪器拿不掉）。

- 所以"够抵消陀螺漂移速度"必须按 **k_s·|w|** 量化；按 1.23 deg/h 设计的 τ=600 s 是错的：

  300 dps 下跟不上，稳态滞后 **5.8°**（见 8.5.2 对比行）。

#### 8.5.2 设计准则：**牵引稳态滞后 = 漂移率 × τ ≤ σ_mag = 2°**

```

滞后 = k_s·|w|·τ  ≤  σ_mag = 2 deg   （σ_mag = 地磁自身误差，S3 实测残差 p50 1.7~2.15 deg）

最坏点 |w| = FS = 2000 dps  ->  τ(FS) = 2 deg / 2 dps = 1.00 s

R_yaw = Q(FS)·τ²·h²/dt_e = 1.2185e-03 · 1.0 · 0.3400 / 0.00199501 = 0.2077 rad²

```

`τ ∝ 1/|w|`（因为 Q ∝ w²），所以**滞后在所有速率上都是同一个 2.0°**：一个 τ 内转过 2000°，

标度误差正好累积 `k_s·2000 = 2.0°` = 地磁自身误差 —— 即"牵引速率恰好等于漂移速率，一个不多一个不少"。

这就是"尽量慢"与"能抵消漂移"的唯一交点，也自动满足"陀螺 Q 大了地磁才拉得快"（无门、无开关、不抖）。

| \|w\| dps | 0 | 5 | 20 | 50 | 150 | 300 | 1000 | 2000 |

|---|---|---|---|---|---|---|---|---|

| 偏航 Q (rad²/s) | 2.85e-08 | 3.61e-08 | 1.50e-07 | 7.90e-07 | 6.88e-06 | 2.74e-05 | 3.05e-04 | 1.22e-03 |

| 牵引 τ (s) | **206.9** | 183.8 | 90.0 | 39.3 | 13.3 | 6.67 | 2.00 | 1.00 |

| 稳态滞后 (°) | 0.07 | 0.98 | 1.83 | 1.98 | 2.00 | 2.00 | 2.01 | 2.01 |

| `sigma_yaw` 上报 (°) | **0.139** | 0.148 | 0.211 | 0.319 | 0.548 | 0.775 | 1.413 | 1.997 |

| 地磁白噪贡献 (°) | 0.006 | 0.006 | 0.009 | 0.013 | 0.023 | 0.032 | 0.058 | 0.083 |

静态：τ=207 s、零偏 1.23 deg/h 的滞后仅 **0.071°**、`sigma_yaw` 上报 **0.139°**、

地磁白噪声只贡献 0.006°（500 Hz 平均的收益全部保留）。

**对比**（|w|=300 dps）：新方案 τ=6.67 s、滞后 **2.00°**；旧 τ=600 s 方案 τ=19.3 s、滞后 **5.8°**（跟不上）。

`E_MAX` 可调，`R ∝ E_MAX²`（其余不变）：

| E_MAX (°) | R (rad²) | τ(静) (s) | τ(300dps) (s) | sigma_yaw(静) (°) |

|---|---|---|---|---|

| 0.5 | 0.0130 | 51.7 | 1.67 | 0.070 |

| 1.0 | 0.0519 | 103.5 | 3.34 | 0.098 |

| **2.0** | **0.2077** | **206.9** | **6.67** | **0.139** |

| 4.0 | 0.8309 | 413.8 | 13.33 | 0.197 |

#### 8.5.3 顺带量出来的三个模型错（不是调参）

| # | 问题 | 数据 | 后果 |

|---|---|---|---|

| 1 | **VER=120 的 R 乘性门是重复计入**：`R_eff = R·max(1, σ²/P)` 而 `R` 本身已是 `σ²` | 闭环 τ 只剩 **4.6 s**，`P[8][8]` 被压到虚低 **0.379°** | 名义"按不确定度匹配"，实际**更快**把地磁误差灌进偏航 |

| 2 | **偏航基底 Q 高估 336 倍**：`SIG_G_DPS = 0.1224 dps` 是 **8 kHz 单样本 RMS**，被当**谱密度**用 | 当密度 ⇒ 7.34 deg/√h；实测随机游走 **0.58 deg/√h**（`accel_position_design.md` §7） | 地磁对偏航的相对权重被放大 ~18 倍（σ） |

| 3 | **转动项 `(k_s·\|w\|)²` 漏 `DEG2RAD`**（`sq` 其它项 `sr`、`SIG_G_RADS` 都已换算到 rad） | 等效放大 `1/DEG² = 3283` 倍：20 dps 时 Q=1.6e-3、τ=**2.5 s** | **"转动中地磁抢偏航"的直接来源**（§7.1 实测 yaw 步进被拉偏 3.9°） |

#### 8.5.4 改动清单（`patch_v121_magpull.py`）

| 文件 | 改动 |

|---|---|

| `v5f_tune.h` | `+V5F_EKF_Q_YAW_ARW (0.58f/60.0f*0.017453292f)`；`+V5F_EKF_GYRO_KS_YAW 1.0e-3f`（1000 ppm 口径）；`+V5F_EKF_MAG_YAW_R 0.2077f`；`V5F_EKF_Q_YAW_MIN 1e-8 → 1e-12`；`V5F_FW_VER 120u → 121u` |

| `proc_ekf.c` | ① `ekf_m7_mag`：**删掉 VER=120 的 R 乘性门**，`RRv[0] = V5F_EKF_MAG_YAW_R`（顺带删掉不再用的 `sg2`、修正 `RRv[3]` 缩进）；② `ekf_prop_row`：新增局部 `sq_yaw`，**偏航(row 8) Q 与倾角解耦** = `Q_YAW_ARW² + (KS_YAW·\|w\|·DEG2RAD)²`，`row==8` 走 `sq_yaw`，`row 6/7` 保持原 `sq` |

**故意不动**：倾角行(row 6/7)的 Q。它同时喂「速度泄漏 `λ = VLEAK_K·σ_tilt`」与重力恢复，

属另一条已验收通道 ⇒ 另立遗留项。

#### 8.5.5 遗留项（不阻塞本次验收）

1. **倾角行同样是"样本 RMS 当密度 + 漏 DEG2RAD"**（`sq` 对 row 6/7 仍偏大 3283 倍、

   基底仍用 `0.1224 dps`）。改它要连带复测"运动后重力恢复"与"速度泄漏"，单独立项。

2. **0.1224 dps 的物理含义**要钉死：若它确实是 8 kHz 单样本 RMS（`V5F_DET_THR_BASE = 10·σ/√128` 支持这一点），

   则倾角行基底也高估 ~336 倍。需一段**长静止记录**（≥10 min，`tools/calib/zerodrift.py` 的 Allan/ARW）一次定论。

3. **地磁绝对航向 ~3~4.4°**（会话间硬磁中心漂移）仍未解 —— 与"牵引速度"正交，属 S4 前的磁零偏在线估计 / SET-RESET。

#### 8.5.6 验收（烧录 VER=121 后）

| # | 项 | 期望 |

|---|---|---|

| 1 | 第 104 列 `sigma_yaw` | 静止 ≈ **0.14°**（VER=120 的 0.379° 是虚低值；**变成 0.14 是对的**） |

| 2 | 静止 10 min 偏航漂移 | ≤ **0.2°**（= 零偏滞后 0.07° + 噪声底） |

| 3 | 转动中"磁牵引拉偏"（§7.1 指标：ekf yaw 步进 vs 陀螺步进） | 由 3.9°/0.84° 级 → **≤2°**（有界，且不随转角累积） |

| 4 | 同朝向复现性 | 不退化（应更好：地磁瞬态不再进来） |

| 5 | dip / 已知航向 / 偏航符号（§0 的 ①②③④） | 不变（本次没碰 A/C） |

- 回退：`Copy-Item bak_src\V5F\User\inc\v5f_tune.h.bak_v121 V5F\User\inc\v5f_tune.h -Force`

  + `Copy-Item bak_src\V5F\User\src\proc_ekf.c.bak_v121 V5F\User\src\proc_ekf.c -Force`

---

## 8.6 【2026-09-22 回退记录】VER=119/120/121 全部作废，源码回到 VER=118

**用户判定**：`VER=118` 是最后一个好用版本；之后再改，实测**地磁把偏航拽得乱转**（本应"陀螺短期远好于地磁"）。

因此源码已整体回退，**当前树 = VER=118**。

### 8.6.1 本次回退了什么、从哪个备份回退

| 文件 | 回退来源 | 说明 |

|---|---|---|

| `V5F/User/inc/v5f_tune.h` | `bak_src\...\v5f_tune.h.bak_v119` | `V5F_FW_VER = 118u`；`GYRO_KS=5.0e-3`、`Q_YAW_MIN=1.0e-5`、`YAW_P_MIN=(2°)^2`、磁 R 2°/3° 全部是 118 的值 |

| `V5F/User/src/proc_ekf.c` | `bak_src\...\proc_ekf.c.bak_v120` | 与 `.bak_v118`(v117) 逐行比对，差异**恰好**是 VER=118 的四项（`s_wmag`、磁倾斜固定 R、`(KS·\|w\|)²` Q 项、对齐时播种 IX_BG）⇒ 这份就是 VER=118 内容（v119 没动 proc_ekf.c） |

| `V5F/User/inc/v5f_proc.h` | `bak_src\...\v5f_proc.h.bak_v119` | 回到 v119 之前的 per-axis LSB（X16.2753/Y16.4793/Z16.4235）；交叉轴 `V5F_GYRO_KXY/KXZ/KYZ` 本就在，值未变 |

**备份标签语义（重要，之前搞错过一次）**：`.bak_vNNN` = **应用 vNNN 补丁之前**的状态，即"上一版内容"。

所以 `tune.h.bak_v119` 里是 `118u`，`proc_ekf.c.bak_v120` 里是 118/119 的内容。

**以后回退 VER=118 只用这一组（名字无歧义）**：

```

Copy-Item bak_src\V5F\User\inc\v5f_tune.h.bak_v118_LASTGOOD  V5F\User\inc\v5f_tune.h  -Force

Copy-Item bak_src\V5F\User\inc\v5f_proc.h.bak_v118_LASTGOOD  V5F\User\inc\v5f_proc.h  -Force

Copy-Item bak_src\V5F\User\src\proc_ekf.c.bak_v118_LASTGOOD  V5F\User\src\proc_ekf.c  -Force

```

### 8.6.2 回退后的静态自检（PC 侧，全部通过）

- `V5F_FW_VER = 118u`；`DIP_TAN=1.3932`、`DECL=-7.53`、`A/C = 台面(107/108) 版` —— **方向/标定层一个字节都没动**（与 §3 表一致）。

- 全部 `.c` 里用到的 `V5F_*` 宏都能在头文件里找到定义（0 个悬空）⇒ 回退没有留下半截依赖。

- `proc_ekf.c` 去注释后花括号/圆括号配平 0/0；`srcdir_clean.py --check` 干净（源码树无变体副本）。

- 现存备份：`v5f_tune.h` 有 `.bak_v118/119/120/121`，`proc_ekf.c` 有 `.bak_v118/120/121`，`v5f_proc.h` 有 `.bak_v119/120`。

  ⚠️ `proc_ekf.c/tune.h` 的 `.bak_v121` 已被**改成 v121 那份坏内容**（VER=120 的那份没留副本）。

### 8.6.3 事后判断：VER=119~121 各改了什么（供定位"乱转"）

| 版本 | 改动 | 与"地磁乱转"的关系 |

|---|---|---|

| 119 | per-axis 陀螺 LSB（16.2753/16.4793/16.4235 → 16.2608/16.3992/16.4431，±0.1~0.5%）+ `GYRO_KS 5e-3→2e-3` | KS 变小 ⇒ 转动相关 Q 变小 ⇒ 名义上地磁**更少**介入；0.1% 级 LSB 不解释"乱转" |

| 120 | 磁 R 乘性门 `R_eff=R·max(1,σ²/P)`；`Q_YAW_MIN 1e-5→1e-8`；`YAW_P_MIN (2°)²→(0.05°)²` | **可疑**：`YAW_P_MIN` 从 `(2°)²=1.22e-3` 降到 `7.6e-7`（缩小 1600 倍）后，`P[8][8]` 地板几乎消失；配合 R 门会让偏航权重在极小 P 与大 P 之间剧烈变化 —— 需要复现确认 |

| 121 | 我改的：偏航 Q 解耦、R=0.2077、闸门 `s_kscale` | 从未烧录；§8.5 已作废 |

### 8.6.4 后续铁律（避免再犯）

1. **不许在"上一版已经坏了"的基线上继续推公式**：先确认基线（当前 = VER=118）在机上好用，再动。

2. **一次只改一个量**，并且必须能回退到 VER=118（本条已具备）。

3. 偏航通道的任何改动，验收只看 §7.1 那两项：**"ekf yaw 步进 vs 陀螺步进"**（转动中被地磁拉偏多少）

   与 **同朝向复现性**；`sigma_yaw` 只作参考。

4. 复现"乱转"需要用户提供一段**带已知朝向/静止段的录像**（能算 §0 判据），否则无法定位。

---

## 8.7 VER=122 = VER=118 + ①恢复 v119 精度标定 + ②地磁修正速度用 **EKF 标准数学** 实现

用户口径：`VER=118` 是基线（不再乱转）；**恢复 119 的精度标定**；**卡严地磁修正速度限制为先前讨论值**，

且**"地磁修正速度以 ekf 标准数学实现"**（不许再给 K 打钳位这类非标准手法）。

脚本：`tools/ekf_session/patch_v122_magrate.py`；复核：`tools/ekf_session/mag_pull_design.py`。

### 8.7.1 ① v119 精度标定（原样恢复）

| 位置 | 值 |

|---|---|

| `v5f_proc.h` `V5F_GYRO_LSB_PER_DPS_X/Y/Z` | **16.2608 / 16.3992 / 16.4431**（v119 实测：360°@50RPM 残差 −890 / −4860 / +1200 ppm；原 16.2753/16.4793/16.4235） |

| 交叉轴 `V5F_GYRO_KXY/KXZ/KYZ` | 0.001528 / −0.001923 / 0.000005（与 v118 相同） |

| `v5f_tune.h` `V5F_EKF_GYRO_KS` | 5.0e-3 → **2.0e-3**（v119 配套；**只作用于倾角行**） |

### 8.7.2 ② 修正速度为什么必须"以标准数学实现"

VER=118 的偏航修正速度其实**不是**由物理决定的，被两个人造量顶上去：

| 人造量 | VER=118 值 | 后果 |

|---|---|---|

| `V5F_EKF_Q_YAW_MIN` | `1.0e-5`（每 epoch 直接加进 `P[8][8]`）= **5.018e-03 rad²/s** | 比实测随机游走大 **17.6 万倍**，`P[8][8]` 被顶大 ⇒ K 变大 ⇒ 修正被"强制加快" |

| `V5F_EKF_YAW_P_MIN` | `(SIG_DEG·DEG2RAD)² = (2°)²` | `P[8][8]` 的地板就等于"地磁自身误差" ⇒ `K = P/(P+R) ≥ 0.5`，地磁**恒定满权重** |

净效果：VER=118 静止时 **τ = 0.038 s**，1° 偏差的修正速度 **26.5 dps**（比"够抵消漂移"快几百倍）。

本版把偏航行的 **Q、R、地板全部按标准记账**，速度由 `K = P h/(h²P+R)`、`τ = dt·sqrt(R/(Q·dt))/h` 自然给出：

```

R_yaw  = (2°)² = 1.2185e-03 rad²          地磁自身误差（保持 v118 诚实值，不动）

Q_yaw  = min( ARW² + (KS_YAW·|w|·DEG2RAD)² , Q_MAX )

   ARW    = 0.58 deg/√h = 1.6872e-04 rad/√s     S3 实测随机游走（accel_position_design.md §7）

   KS_YAW = 1000 ppm（新增 V5F_EKF_GYRO_KS_YAW；用户口径=满量程 1000 ppm）

   Q_MAX  = 7.14e-06 rad²/s  <=>  τ ≥ τ_min = 1 s

   V5F_EKF_Q_YAW_MIN 1.0e-5 → 1.0e-12（纯数值下限）

   V5F_EKF_YAW_P_MIN (2°)² → (0.01°)²（纯数值地板）

倾角行 row 6/7 的 Q **保持 v118/119 原状**（不动已验收通道）

```

### 8.7.3 工作点（实测公式，非仿真）

| \|w\| dps | 0 | 5 | 20 | 50 | 100 | ≥153 |

|---|---|---|---|---|---|---|

| Q_yaw (rad²/s) | 2.85e-08 | 3.61e-08 | 1.50e-07 | 7.90e-07 | 3.08e-06 | 7.14e-06（截断） |

| 闭环 τ (s) | **15.85** | 14.08 | 6.90 | 3.01 | 1.53 | **1.001** |

| 2° 误差的修正速度 (dps) | 0.126 | 0.142 | 0.290 | 0.665 | 1.31 | **2.00** |

| 1° 误差的修正速度 (dps) | 0.063 | 0.071 | 0.145 | 0.332 | 0.656 | 1.00 |

### 8.7.4 "先前讨论值 2 dps" 如何被严格卡住

- 先前讨论值 = 陀螺**满量程不可建模漂移率** = 1000 ppm × FS(2000 dps) = **2 dps = 7200 deg/h**。

- 标准 KF 里修正速度 = 误差/τ，所以"卡严 2 dps"等价于 **τ ≥ 1 s**（在误差 ≤ 地磁自身误差 2° 的范围内）：

  `τ = dt·sqrt(R/(Q·dt))/h ≥ 1 s  ⇔  Q ≤ R/((h/dt)²·dt) = 7.148e-06` ⇒ 取 `Q_MAX = 7.14e-06`。

- 复核（`mag_pull_design.py`）：**|w| = 0…2000 dps 全段 τ ≥ 1.001 s，2° 误差的修正速度 ≤ 1.999 dps ⇒ 全部满足**。

- 自洽性：满量程漂移 2 dps 下的稳态滞后 = `漂移率 × τ = 2 dps × 1.001 s = 2.0°` = 地磁自身误差 σ_mag

  —— 即"陀螺误差涨到地磁那个量级时，地磁才以刚好能抵消满量程漂移的速度牵引"。

- 全段**没有任何 K 钳位 / 速率钳位**：只改 Q、R、地板，公式全是标准的。

### 8.7.5 上报量的变化（预期，不是回归）

| 列 | VER=118 | VER=122 | 说明 |

|---|---|---|---|

| `sigma_yaw`（104） | ≈0.79°（被 Q_YAW_MIN 顶出来的） | 静止 **0.0385°**（`P[8][8]=4.51e-07`） | 现在如实反映"陀螺自己累积的不确定度" |

| `p_yy`（P[8][8] 自检列） | ~1.9e-04 | ~4.5e-07 | 同上 |

| `ekf_mag_rs`（149） | 1.0 | 1.0 | 未改 |

| 其余列 | — | — | 未动 |

### 8.7.6 验收（烧录 VER=122 后）

| # | 项 | 期望 |

|---|---|---|

| 1 | 静止/小转动：地磁不许把姿态拽走 | 同朝向复现性不退化；静置朝向不随时间被拉向某个固定值 |

| 2 | "ekf yaw 步进 vs 陀螺步进"（§7.1 指标） | 转动中拉偏应**明显小于** VER=118（118 是固定满权重） |

| 3 | 360°/50 RPM 三轴积分 | 每圈 **360.0 ± 0.1°**（v119 标定的验收项，与 §8.4 相同） |

| 4 | `sigma_yaw`（104 列） | 静止 ≈0.04°，随转动增大（τ 缩短）—— 这是**预期**值 |

| 5 | §0 判据 ①②③④ | 不变（本次没碰 A/C / DIP / DECL） |

| 6 | 大机动后姿态回正 | 不出现"阶段";转动中地磁介入随 Q 增大而变快（τ→1 s），但速率绝不超过 2 dps |

- 回退：`Copy-Item bak_src\V5F\User\{inc\v5f_tune.h,inc\v5f_proc.h,src\proc_ekf.c}.bak_v118_LASTGOOD ... -Force`（见 §8.6.1 的三条命令）。

- 备份：本次已存 `v5f_tune.h/v5f_proc.h/proc_ekf.c` 的 `.bak_v122`（= VER=118 内容，供再回退）。

---

## 8.8 VER=123：地磁→EKF 的**两个入口**（互斥）+ 重力矢量误差估计累加器

用户设计口径（原话要点）：小运动下内部维护一个数（无有效重力牵引按**当前速度**累加、有重力牵引**比例衰减**，

用实测系数拟合：**运动误差 1000 ppm、零漂 2 deg/h**），高于阈值才允许地磁用**现在的矢量方式**，

低于阈值（此时重力矢量误差很低）改为**把地磁矢量投影到以重力为法向量的平面**（= 旧的、当年地磁唯一融合方式），

**只修正姿态角**；两个入口**互斥**；**防溢出**（大于 u32 范围时停在最大值不回绕）；

帧基用 **EKF 观测帧**、门控判断用两帧之间的 **DRDY 降采样**。

脚本：`tools/ekf_session/patch_v123_mag_two_entries.py`。

### 8.8.1 两个入口（互斥，一次只执行一个）

| | 入口 A（旧） | 入口 B（今） |

|---|---|---|

| 观测 | **地磁矢量投影到以重力为法向的平面**，取平面内航向角残差 `r = wrap_pi(thm − thp)`（测量−预测） | 矢量方式：e1 偏航维 + e2 倾斜维，二维 `r2v[0]/r2v[1]` |

| H | **只有偏航行** `s_H[0][8] = 1` | H[0]=e1 行、H[1]=e2 行（三姿态行） |

| 注入掩码 | **`0x0100`（只开偏航状态；roll/pitch 的 K 被清零）= 只修正姿态角** | `0x01C0`（6/7/8 三行） |

| R | `σ_h² + (tanI·σ_tilt)²`，σ_h=2°、σ_tilt=√(P66+P77) 上限 5°（重力有效时自动退化成 ≈(2°)²） | `diag((2°)²,(3°)²)`（VER=118 起固定） |

| 源码来源 | `bak_src/V5F/User/src/proc_ekf.c.bak_v103_magvec`（VER=103 之前，当年**地磁唯一融合方式**，实机验证过符号） | VER=103 起的现实现，**一字未改** |

| 何时启用 | `s_grav_err ≤ THR`（重力矢量误差很低） | `s_grav_err > THR`（重力长期没牵引、倾角只能靠陀螺） |

两者前置校验共用（`|m|` 范围、`mag_norm` 门、DRDY 时刻对齐/转动补偿、`s_mag_r > R_MAX` 剔除、IST 采样去重）；

被拦下时**两个都不执行**（另一个也不补偿）——互斥语义。

### 8.8.2 累加器 = 重力矢量（倾角）误差估计（u32 定点，单位 1e-6 deg）

**帧基 = EKF 观测帧**（实测周期 = 16 帧传播 + 7 帧观测 = **23 DRDY 帧 ⇒ 8021.9/23 = 348.8 Hz**；

`v5f_tune.h` 里"DECIM=16 → 501.4 Hz"的旧注释是错的，已在本节更正）。

**门控判断 = 两观测帧之间 23 个 DRDY 帧的降采样**：多数（`2·ok ≥ n`）算"有重力牵引"。

```c

/* 每个 DRDY 帧 */                s_ff_n++;  if (gate->ekf_tilt) s_ff_ok++;

/* 每个 EKF 观测帧（stage 16）*/   多数有牵引: s_grav_err -= s_grav_err >> V5F_EKF_MAG_FF_SHIFT;

                                  否则:      inc = (1000ppm*|w|_dps + 2deg/h) * dt * 1e6  [µdeg]

                                             s_grav_err += inc（饱和，到顶停住不回绕）

```

| 参数 | 值 | 依据 |

|---|---|---|

| `V5F_EKF_MAG_FF_SHIFT` | **7** | 衰减 ×(1−1/128)/帧 ⇒ τ=128 帧=**0.367 s**，与重力通道自己的倾角收敛 `τ=dt/(K·h)≈0.36 s` 一致 |

| `V5F_EKF_MAG_FF_THR_DEG` | **2.0°** | 地磁自身误差量级（S3 实测 p50 1.7~2.15°）；与 §8.7 偏航口径同源 |

| `V5F_EKF_GYRO_DRIFT_DPS` | **2/3600 °/s** | 用户口径：零漂 2 deg/h |

| `V5F_EKF_GYRO_KS_YAW` | 1000 ppm | 用户口径：满量程 1000 ppm（§8.7 已引入） |

| `V5F_EKF_MAG_FF_MAX` | `0xFFFFFFFFu` | 饱和上限 = 4294.97°，**不回绕** |

**分辨率与增量**（dt=2.867 ms/观测帧）：

| \|w\| dps | 0（纯零漂） | 20 | 100 | 300 | 1000 |

|---|---|---|---|---|---|

| 增量 (µdeg/帧) | **1.59**（定点不截断） | 58.9 | 288 | 862 | 2870 |

| 到 2° 用时 | 1.0 h | 97 s | **19.9 s** | **6.6 s** | 2.0 s |

⇒ **静止/小运动永远停在入口 A**（重力一直有效，累加器被衰减到 0）；**持续机动几秒~几十秒自动切入口 B** ✓。

**不加回差**（用户确认）：判据**不含 EKF 的 P 反馈**（只由 `|w|` 与重力门驱动），单帧增量 ~300 µdeg 对阈值 2e6 µdeg

是 1/7000，穿越缓慢单调 ⇒ 不存在"更新→P 变→判据翻"的极限环。

### 8.8.3 方向正确性

- 入口 A 的残差/H/掩码是 `bak_v103_magvec` 的**原文**（当年唯一融合方式，多轮实机验证）⇒ 符号无需重新推导。

- 入口 B 是现码（§7.2 实机指标：转动中磁牵引拉偏 −0.37/+0.40/−0.84/+0.48）⇒ 符号已验证。

- 两者都是"z − h(x)"式残差、共用 `ekf_update`；本版的唯一新自由量是**哪几维参与**，不引入新符号风险。

### 8.8.4 上报

第 **ekf.mag_rs(列 149)**（`ekf.mag_rs`，原来是常数 1.0）改为上报**重力矢量误差估计（deg）**：

读 0 = 重力有效在入口 A；逼近/超过 2.0 = 快要/已经切入口 B。`SPI_rx.c` 该列注释已同步。

### 8.8.5 事故记录（本轮踩的坑，写下来防再犯）

落盘过程中 `open(EKF,'wb').write(ekf.encode('gbk'))` 里的 `encode` 因为一个 **U+2212（−）** 抛异常，

而 `open('wb')` **已经先把文件截成 0 字节** ⇒ `proc_ekf.c` 一度变空。

**已从 `.bak_v123`（补丁前自动备份）完整恢复**，恢复后校验：83265 B、`sq_yaw`×5、无 `s_grav_err`。

教训：**先 encode 再 open**（脚本里已改成 `_w()` 辅助函数），且**每次改动前必须先落备份**（这次正是它救的）。

### 8.8.6 验收（烧录 VER=123 后）

| # | 项 | 期望 |

|---|---|---|

| 1 | 静止/小运动（重力有效） | ekf.mag_rs(列 149) ≈ 0；地磁**只改偏航**，roll/pitch 完全不被地磁碰（可看姿态对地磁扰动的响应） |

| 2 | 持续机动 | ekf.mag_rs(列 149)按 `(1000ppm·\|w\| + 2°/h)` 增长；约 7~20 s 越过 2.0 → 自动切矢量方式 |

| 3 | 机动结束回到静置 | ekf.mag_rs(列 149)在 ~0.4 s 内衰减回 0，自动切回投影入口 |

| 4 | 静止 10 min 偏航 | 与 VER=122 同量级（≤0.2° 漂移滞后）；同朝向复现性不退化 |

| 5 | 360°/50 RPM 三轴 | 每圈 360.0 ± 0.1°（v119 标定项，不退化） |

| 6 | §0 判据 ①②③④ | 不变（没碰 A/C / DIP / DECL） |

| 7 | 溢出 | 长时间无重力牵引时 ekf.mag_rs(列 149)停在 4294.97 不再增长（不回绕、不变负） |

- 回退 VER=122：`Copy-Item bak_src\V5F\User\inc\v5f_tune.h.bak_v122 V5F\User\inc\v5f_tune.h -Force`

  + `Copy-Item bak_src\V5F\User\src\proc_ekf.c.bak_v122 V5F\User\src\proc_ekf.c -Force`

  + `Copy-Item bak_src\V5F\User\src\SPI_rx.c.bak_v122 V5F\User\src\SPI_rx.c -Force`

- 回退 VER=118：见 §8.6.1 三条（`.bak_v118_LASTGOOD`）。

- 备份：本次已存 `v5f_tune.h / proc_ekf.c / SPI_rx.c` 的 `.bak_v123`（= VER=122 内容）。

---

## 8.9 VER=124：**验收帧**新增一路 float = 当前地磁入口（0/1/2）

用户要求："在验收模式上报加一个 float 位表示当前地磁模式"。

⚠️ **先记一次改错**：我第一版把这一列加到了**调试帧**（`JF_CH_NUM 162→163`）—— 那是错的。

调试帧本来工作正常，**一个字节都不该动**；要动的是 **验收帧**（`V5F_CDC_QUAT_ONLY != 0` 那条分支：

CDC EP2 只发 EKF 四元数的 20 B JustFloat）。该版本已完整回退（脚本 `patch_v124_accept_magmode.py`

第一步就从 `.bak_v124` 把 `SPI_rx.c / cols_162.py / 6 个 acceptance 脚本` 恢复回 VER=123）。

### 8.9.1 验收帧格式（20 B -> 24 B）

| | 原 | 现 |

|---|---|---|

| 载荷 | `q[4]`（EKF 四元数，4×float32 小端） | `q[4]` + **`mag_mode`（1×float32）** |

| 帧尾 | `00 00 80 7F` @ 16..19 | `00 00 80 7F` @ **20..23** |

| 长度 | 20 B/帧（每 IMU 帧一帧，8 kHz） | **24 B/帧** |

`mag_mode` 取值：**0** = 本帧没有地磁修正（门控 / IST 采样去重 / 剔除 / 更新失败）；

**1** = 入口 A 重力法平面投影（只修正姿态角）；**2** = 入口 B 矢量方式（e1 偏航 + e2 倾斜）。

它放在**帧尾之前**（JustFloat 要求 `00 00 80 7F` 是最后 4 字节）⇒ 读取端把"通道数"从 4 改成 5

（含帧尾的记录 = 6 个 float = 24 B）。

**调试帧完全没动**：`JF_CH_NUM` 仍是 **162u**、帧长仍 654 B、`fw_tag` 仍是 `(124<<16)|(162<<8)|7`；

`V5F_CDC_QUAT_ONLY` 置 0u 时照旧工作 ✓（`tools/calib/cols_162.py` 自检 rc=0：162 列 / 120 组 / 锚点全中）。

### 8.9.2 改动清单

| 文件 | 改动 |

|---|---|

| `v5f_tune.h` | `V5F_FW_VER → 124u`；`V5F_CDC_QUAT_ONLY` 注释 20 B → **24 B**（第 5 路 = 地磁入口） |

| `SPI_rx.c` | 验收分支：`qbuf[20] → qbuf[24]`；`mm = g_v5f_hold.ekf.mag_mode; memcpy(qbuf+16,&mm,4)`；帧尾 16..19 → 20..23；`hid_up_enqueue(qbuf, 24u)`。**调试帧分支一行未改** |

| `SPI_rx.h` | `v5f_ekf_t` 末尾加 `float mag_mode;`（结构体只在 V5F 内部用，V3F 不引用） |

| `proc_ekf.c` | `static float s_mag_mode;`；每观测帧随 `s_mag_used` 清零；哪个入口返回 0 就置 1/2；`ekf_publish` 里 `h->ekf.mag_mode = s_mag_mode;` |

| `tools/acceptance/_accept3.py` | 行正则 20 B → **24 B**（`{19}`→`{23}`）、帧尾查 `b[20:24]`、并把第 5 路收进 `mds[]` |

| `tools/calib/zerodrift.py` | 20 → 24 字节、帧尾 `[16:20]` → `[20:24]` |

| `tools/calib/scale_sim.py` | `reshape(-1,5)` → `reshape(-1,6)`（4 分量 + 1 地磁 + 尾） |

| `tools/calib/rec.py` | 提示文本 20B → 24B |

| `tools/calib/cols_162.py` | 列名表不动（调试帧没变），只把 `VER_EXPECT` 107 → 124 |

| `tools/calib/jf_load.py` | **无需改**：它按十六进制 token 数自动识别通道数（现在会报 5 通道） |

| `tools/calib/bias_uncertainty.py` | 不动：那是另一种 9 通道 40 B 帧，不是验收帧 |

### 8.9.3 验收（烧录 VER=124 后）

| # | 项 | 期望 |

|---|---|---|

| 1 | 验收流格式 | 每帧 **24 B**，第 5 个 float ∈ {0,1,2}，末 4 字节恒为 `00 00 80 7F`；`_accept3.py` 的"坏帧"计数应≈0 |

| 2 | 静置 | 第 5 路 = **1**（投影入口，只修正姿态角） |

| 3 | 持续机动 | ekf.mag_rs(列 149)（调试帧的重力矢量误差估计）越 2.0 后第 5 路变 **2**，回落 0 后回 **1** |

| 4 | 地磁门关/采样未更新 | 第 5 路 = **0** ⇒ 直接证明"这一帧地磁没动姿态" |

| 5 | 调试帧 | 若把 `V5F_CDC_QUAT_ONLY` 置 0u，仍是 162 通道 654 B、`fw_tag` 通道位 162，行为与 VER=123 完全一致 |

- 回退：验收帧 `Copy-Item bak_src\V5F\User\src\SPI_rx.c.bak_v124b V5F\User\src\SPI_rx.c -Force`

  （`.bak_v124b` = 本次改验收帧之前的 VER=123 状态）；整套回 VER=123 见 §8.8.6。

---

## 8.10 VER=125：把地磁"牵引速度"锁到设计值（幅度门不动）

用户口径：**"幅度门暂时不变；将磁牵引速度修正到设计速度即可。"**

脚本：`tools/ekf_session/patch_v125_yaw_tau.py`；分析脚本：`tools/ekf_session/magdist_probe.py`、

`maggate_reset.py`、`maggate_thr.py`、`maggate_pick.py`、`maggate_corr.py`。

### 8.10.1 新录像（`R:\imu_20260922_195513.bin` / `_195551.bin`，设备**静止** + 外部磁干扰）

| 量 | 实测 | 说明 |

|---|---|---|

| 陀螺 w_z | 均值 −0.008 dps，30 s 积分 **−0.23°**（路径 1.95°） | 设备确实没动 |

| 固件磁航向 `psi_true` | 净 **−62.4°**、路径 **1684°**、瞬时 \|d/dt\| p99 **340 dps**（max 809） | 外部强干扰 |

| EKF 偏航 | 净 **−62.5°**、路径 240° | 被地磁拽着走 = **假运动** |

| `mag_norm` | \|mn−1\| p50 0.020 / p90 0.165 / p99 0.447；>0.10 占 25.6% | 现有幅度门（0.10）只挡住 1/4 |

| **`p_yy`（列121）= P[8][8]** | **p50 2.11e-03** | 设计值应为 **4.51e-07** |

| **`sigma_yaw`（列104）** | **p50 2.63°** | 设计值应为 **0.039°** |

| `ekf_mag_r_deg` | p50 10.1°（与 \|mn−1\| 无关：<0.02 时仍是 10.08°） | 那是**静态**校准偏差，不是干扰 |

⇒ K = P/(P+R) = 2.11/(2.11+1.22) ≈ **0.63**（地磁按满权重硬拽，有效 τ≈2 s）。

P88 恰好卡在旧地板 `(2°)²=1.2185e-03` 附近 ⇒ **刷进去的固件里偏航地板仍是旧的 `(2°)²`**

（VER=122 改的 `(0.01°)²` 没生效），这就是"牵引速度不是设计值"的根因。

### 8.10.2 相关性核对（用户要求：先验证总磁大小与 EKF 角度偏移的相关性）

`maggate_corr.py`：x = `|mag_norm−1|`（分箱），y = `d(EKF偏航 − 陀螺积分偏航)/dt`（地磁真正拽偏航的速率，dps）：

| \|mn−1\| 区间 | 帧占比 | \|拽偏航速率\| p90 |

|---|---|---|

| [0, 0.01) | 7.7% | 27.4 dps |

| [0.01, 0.02) | 16.0% | 26.0 dps |

| [0.02, 0.05) | 7.5% | 38.2 dps |

| [0.05, 0.10) | 4.0% | 257 dps |

**Pearson r = +0.476（rec1）/ +0.257（rec2）**；反事实回放（τ=15.85 s 一阶牵引）**任何幅度门都做不到

"偏移 ≤ 2°"**：L=0.01 → 最大 3.33°，L=0.10 → 5.5~6.1°，不收门 → 2.8~10.5°。

⇒ **幅度门单独不够**（这正是本次"幅度门先不动"的原因；要压到 ≤2° 必须再加"陀螺一致性门"，见 §8.11 待办）。

### 8.10.3 本版改动（只有牵引速度，标准 EKF 数学）

| # | 改动 | 依据 |

|---|---|---|

| ① | `V5F_EKF_YAW_P_MIN`：`(0.01°)²` → **1.0e-12**（纯数值地板） | 实测 P88 卡在旧地板 (2°)²；偏航地板不该是"地磁的 σ²" |

| ② | **牵引速度上限**：每次地磁更新前把偏航行 R 抬到 `R_yaw ≥ P88·(1/K_max − 1)`，`K_max = V5F_MAG_EPOCH_DT_S / V5F_MAG_YAW_TAU_MIN_S = 5.26 ms/15.85 s = 3.319e-4` | 抬 R = 声明地磁更吵（标准 EKF 限增益），**与 P88 记账是否精确无关** ⇒ τ 恒 ≥ 15.85 s |

| ③ | 新增常量 `V5F_MAG_YAW_TAU_MIN_S 15.85f`、`V5F_MAG_EPOCH_DT_S 0.00526f`；`V5F_FW_VER → 125u` | |

| ④ | 入口 A（投影）用 `R1[0] = max(R1[0], s_mag_ryaw_min)`；入口 B 用 `RRv[0] = max(RRv[0], s_mag_ryaw_min)` | 两个入口共用同一地板 |

**幅度门 `V5F_MAG_ERR_LIM` 保持 0.10 不变；调试帧/验收帧格式一个字节没动。**

设计点核对：P88=4.51e-07 → 自然 K=3.70e-4（τ=14.2 s），被上限收到 K=3.319e-4 ⇒ **τ=15.85 s**；

实测点核对：P88=2.11e-03 → R_min=6.356 ⇒ K=3.319e-4 ⇒ **τ=15.85 s**。（两处都锁在设计速度 ✓）

### 8.10.4 预期效果（用同一段录像推算）

τ=15.85 s 把干扰的**快分量**滤掉，只跟磁航向的**慢分量**：净漂移 −62.5° → **−8.6°**，

最大偏移 63° → 几度。静态 `p_yy` 应回到 **4.5e-7**、`sigma_yaw` 回到 **0.04°**。

### 8.10.5 验收（烧录 VER=125 后）

| # | 项 | 期望 |

|---|---|---|

| 1 | 静置 `p_yy`（列121） | **≈4.5e-7**（现在 2.11e-3 ⇒ 若仍 2e-3 说明固件没带上本改动） |

| 2 | 静置 `sigma_yaw`（列104） | **≈0.04°**（现在 2.63°） |

| 3 | 静止+干扰录像的 EKF 偏航 | 净漂 **≤ ~9°**、最大 **≤ ~5°**（现在 −62.5° / 63°） |

| 4 | 真正转动（360°@50RPM） | 每圈 360.0 ± 0.1° 不退化；`ekf yaw 步进 vs 陀螺步进` 不退化 |

| 5 | `ekf_mag_used` / 验收帧第 5 路 | 不变（仍 1=投影入口） |

- 回退：`Copy-Item bak_src\V5F\User\inc\v5f_tune.h.bak_v125 V5F\User\inc\v5f_tune.h -Force`

  + `Copy-Item bak_src\V5F\User\src\proc_ekf.c.bak_v125 V5F\User\src\proc_ekf.c -Force`

- 待办（用户已同意顺延）：**陀螺一致性门**（窗口 0.25 s，`|Δψ_mag−Δψ_gyro|/T > 20 dps` 置失效、保持 5 s；

  实测干扰帧内门开 0.00%，干净录像误触发 0%）—— 那是把"地磁干扰造成的偏移"压到 ≤ 地磁固有误差 2° 的**必需**项。

---

## 8.11 VER=126：恢复"上电一次性磁锚定" + 加"地磁失效门（陀螺一致性，按转速放宽）"

用户口径：**"原本的上电后一次性把坐标系牵引到磁北坐标也被减速了"**、**"陀螺一致门请参考新录制的一段

极限运动设计，适当放宽"**、**"新录制包括陀螺仪削顶等极端情况"**。

脚本：`tools/ekf_session/patch_v126_bootanchor_maggate.py`；分析：`maggate_design2.py`。

### 8.11.1 ① 上电一次性磁锚定被减速的根因与修法

- VER=62 的磁锚定窗是 `if (s_boot_t < V5F_EKF_MAG_ANCHOR_TS /*3 s*/)`，而 `s_boot_t` 是**从上电起算**

  （`s_boot_t += dt`，从未在对齐时清零）。

- VER=125 把牵引速度锁到 `τ ≥ 15.85 s` 之后，问题才显出来：**若对齐发生在 3 s 之后，锚定窗早已过去**

  ⇒ 上电那一次"直接写四元数"的快速牵引不再执行，只剩慢牵引 ⇒ 用户观察到的"被减速"。

- 修法（一行）：**对齐时 `s_boot_t = 0.0f`**，让锚定窗从**对齐时刻**起算。

  锚定本身是直接 `q ← Exp(dψ z)⊗q` 的快照，**不走 `ekf_update`**，因此不受 τ 上限约束 ✓。

### 8.11.2 ② 地磁失效门（陀螺一致性）——参数由新极限段定

判据：窗口 `T` 内 `|Δψ_mag − Δψ_gyro| / T > THR_eff` ⇒ 地磁失效，保持 `HOLD`。

| 参数 | 值 | 依据（2026-09-22 新录像） |

|---|---|---|

| `V5F_MAG_DIST_WIN` | **0.25 s**（2006 帧 @8.0219 kHz） | 受扰静止段：该窗口下**干扰期内门开 0.00%**；窗口放大到 1 s 后"磁场来回摆"的净变化会自我抵消 ⇒ 漏检 |

| `V5F_MAG_DIST_THR_DPS` | **20 dps** | 干净段 T=0.25 s 的 p99 ≈ 9 dps、max 16 dps |

| `V5F_MAG_DIST_KS` | **0.5**（`THR_eff = 20 + 0.5·\|w\|`） | **"适当放宽"的核心**：极限段 `\|w\|` p50 337 / p90 **2010** / max 2524 dps（48.5% >500 dps，含削顶）。高转速下陀螺刻度/削顶、姿态滞后、磁采样延迟的误差都随 `\|w\|` 线性增长，固定门限必然误触发 |

| `V5F_MAG_DIST_HOLD_N` | **3 s**（24066 帧） | 跨过摆动的过零点（0.25 s 窗口自带 ~0.25 s 盲区） |

| 护栏：削顶 | 任一轴 `\|gyro_lsb\| ≥ 32700` 时本段不判 | 削顶时陀螺不能当基准（用户明确要求覆盖该情况） |

| 护栏：高转速 | `\|w\| ≥ 100 dps` 时本段不判 | 大倾角自转时 body-z 速率本来就不是航向速率，宁放行不误判 |

实测结果（`maggate_design2.py`）：

| 录像 | 门关占空比 | 关键指标 |

|---|---|---|

| `195513`/`195551`（静止+外部干扰） | 69% / 77% | **干扰期内门开 0.00%** ✓✓ |

| `201451`（极限运动，含削顶） | **28%** | 地磁被按住、陀螺自己扛 —— 可接受且更安全 |

| `121205`（干净旋转段，T=0.25 s/THR=20） | **0%** | 无误触发 |

**幅度门 `V5F_MAG_ERR_LIM` 保持 0.10 不变；调试帧/验收帧格式一个字节没动。**

### 8.11.3 验收（烧录 VER=126 后）

| # | 项 | 期望 |

|---|---|---|

| 1 | 上电（对齐完成瞬间） | 偏航**一次性**跳到磁北（锚定窗从对齐起算，3 s 内每次地磁更新都直接快照）；不再需要等 τ |

| 2 | 静止 + 外部干扰 | 调试帧 `gate_ekf_mag_yaw`(155) 应长时间为 0；EKF 偏航不再出现"假运动"（对比 VER=125 的 −62.5°） |

| 3 | 极限运动（含削顶） | 门关 ~28%，姿态由陀螺主导；`ekf yaw 步进 vs 陀螺步进` 不退化；无削顶段误触发 |

| 4 | 常规飞行 | 门关 ≈0%（正常机动 |w| < 100 dps 且磁航向与陀螺一致） |

| 5 | 静置 `p_yy`(121) / `sigma_yaw`(104) | 仍应为 **4.5e-7 / 0.04°**（VER=125 项不退化） |

- 回退：`Copy-Item bak_src\V5F\User\inc\v5f_tune.h.bak_v126 V5F\User\inc\v5f_tune.h -Force`

  + `Copy-Item bak_src\V5F\User\src\proc_ekf.c.bak_v126 V5F\User\src\proc_ekf.c -Force`

---

## 8.12 VER=127：地磁失效门的保持时间与判定条件重定（用户口径）

用户口径：**"无效保持时间太长了；门关的时间还是太长，事实上这段运动中基本没有真的受到干扰，

基本是陀螺仪残差。"**

- 判定条件：从"按转速放宽门限 `THR + 0.5|w|`"改为**只在接近静止时判定**：**`|w| < 5 dps`**。

  理由：剧烈运动时 `e = |Δψmag − Δψgyro| / T` 的大头是**陀螺自己的残差 / 削顶 / 姿态滞后**（用户实测结论），

  不是地磁干扰；而 VER=125 已把地磁牵引锁到 `τ ≥ 15.85 s`，运动中本来就不需要这道门。

  静止 / 小运动才是外部磁干扰会"造成假运动"的场景。

- 保持时间：**3 s → 0.5 s**（`V5F_MAG_DIST_HOLD_N 24066 → 4011`）。

- `V5F_MAG_DIST_KS 0.5 → 0.0`（保留常量便于回退）；`THR = 20 dps`、窗口 `0.25 s` 不变；

  削顶护栏 `|gyro_lsb| ≥ 32700` 不变。

**新录像实测**（同一批数据，T=0.25 s、THR=20 dps）：

| 配置 | 极限段(201451) 门关 | 受扰静止段 干扰期内门开 |

|---|---|---|

| VER=126（`THR+0.5\|w\|`, `\|w\|<100`, HOLD=3 s） | 28% | 0.00% |

| **VER=127（THR=20, `\|w\|<5`, HOLD=0.5 s）** | **4.6%** | **0.00% / 0.05%** |

| 对照：HOLD=1 s | 6.9% | 0.00% |

⇒ 极限段的门关占比降到约 1/6，而干扰期照旧被全挡 ✓。

回退：`.bak_v127`（tune + proc_ekf）。

---

## 8.13 牵引速度上限（常数 R 地板）在极限运动下的实测 —— VER=128 试验，**未落盘、按用户指示回滚**

用户问题：**"你先前修改的地磁牵引速度，在极限运动中依然能有效牵引？"**

**结论：不能。** VER=125 的 R 地板把 `K` 钉成 `V5F_MAG_EPOCH_DT_S / V5F_MAG_YAW_TAU_MIN_S`

（`3.32e-4`，**常数、与 `|w|` 无关**），而陀螺自身的偏航残差率按设计口径

= `V5F_EKF_GYRO_KS_YAW · |w|` 随转速线性上升 ⇒ 稳态滞后 = 残差率 × τ：

实测 `R:\imu_20260922_201451.bin`（15053 帧；|w| p50 337 / p90 2010 / p99 2258 / max 2524 dps，

|w|>500 dps 占 48.5%），脚本 `tools/ekf_session/magpull_extreme.py`：

| 律 | τ @ 2000 dps | 稳态滞后 p50 / p90 / max | \|w\|>500 dps 段 p50 |

|---|---|---|---|

| **A 现版（VER=125/127 常数地板）** | 15.85 s | 5.3° / 31.9° / 40.0° | **28.3°** |

| C 设计曲线（VER=128 试验） | 1.00 s | 0.34° / 2.01° / 2.53° | 1.8° |

C 律内容（曾实现并验证通过）：`τ_min(|w|) = V5F_MAG_YAW_TAU_MIN_S · sqrt(q0² / Q(|w|))`，

`Q(|w|) = min(q0² + (KS_YAW·|w|·DEG2RAD)², V5F_EKF_Q_YAW_MAX)`，`K_max = dt_mag / τ_min`；

仍走"抬 R"这一 EKF 标准手法（不夹 K）。静止点与 VER=125 **完全一致**（3.32e-4 / 15.85 s），

|w| 满量程升到 5.26e-3（受 `V5F_EKF_Q_YAW_MAX` 的 1 s 设计底线约束）；

C 律注入的地磁高频噪声 `σ_mag·sqrt(K/2) = 0.10°`（A 律 0.026°），可忽略。

**决定（用户）：回滚牵引速度改动；门控不回滚。**

⇒ `V5F_FW_VER` 保持 **127**，`K_max` 恢复常数地板；

VER=126/127 的**运动一致性门**（`THR=20 dps`、仅在 `|w|<5 dps` 判定、`HOLD=0.5 s`、

削顶护栏 `|gyro_lsb| ≥ 32700`）**原样保留**，一个参数没动。

源码与 HEAD（`279c797`）逐字节一致，无源码改动落盘。

**遗留问题（已量化、未处理）**：极限运动（|w| ≳ 1000 dps）期间地磁偏航牵引被常数地板

限在 15.85 s，稳态滞后 28~40° ⇒ 该段时间内偏航事实上**由陀螺单独主导**，地磁只做慢速回中。

若日后要兼顾，只需把 `K_max` 换成上面的 C 律（`tools/ekf_session/patch_v128_yaw_speedup.py`

可直接重放），或提高 `V5F_EKF_Q_YAW_MAX` 进一步缩短 τ。

操作：

- 回滚：`python tools/ekf_session/rollback_v128.py`（从 `bak_src/…bak_v128` 还原 tune + proc_ekf）

- 重放试验律：`python tools/ekf_session/patch_v128_yaw_speedup.py`

- 分析：`python tools/ekf_session/magpull_extreme.py`

---

## 8.14 VER=129：牵引速度回滚到 VER=125 **降低之前**（删除常数 R 地板）

用户口径：**"回滚牵引速度 …… 现在牵引还不是期望的那个旧版本的快速牵引，应该在上次降低前。"**

"上次降低" = **VER=125 给偏航牵引加的常数 R 地板**：

`K_max = V5F_MAG_EPOCH_DT_S / V5F_MAG_YAW_TAU_MIN_S`（常数 `3.32e-4`）、

`R_yaw ≥ P88·(1/K_max − 1)`。它把增益钉在"静止工作点"，

于是 **P88 变大时地磁也不能快拉**（上电初值、失效后重开、大机动后 Q 增长），

只能按 15.85 s 慢爬 —— 实测极限段稳态滞后 28~40°（§8.13）。

**本条只删三处**（= `git diff bak_v125` 中全部牵引相关差异，逐条核对）：

1. `proc_ekf.c` 静态量 `s_mag_ryaw_min`；

2. `ekf_mag_entry_plane()` 里的 `if (R1[0] < s_mag_ryaw_min) R1[0] = s_mag_ryaw_min;`（连同注释）；

3. `ekf_m7_mag()` 中生成该地板的整个 `{ … }` 块（连同 VER=125 注释）；

4. `v5f_tune.h` 的 `#define V5F_MAG_YAW_TAU_MIN_S`（删除；`V5F_MAG_EPOCH_DT_S` 保留作设计口径记录）。

**一个字节都没动**：VER=126/127 运动一致性门（`THR=20 dps`、仅 `|w|<5 dps` 判定、`HOLD=0.5 s`、

削顶护栏）、VER=123 双入口 + 重力失效累加器（`THR=2°`）、VER=122 的 Q_yaw 设计

（`Q_YAW_ARW` + `KS_YAW·|w|`，`Q_YAW_MAX=7.14e-6`）、`V5F_EKF_MAG_VEC_K_MAX=0.10`、

`V5F_MAG_ERR_LIM=0.10`、`V5F_EKF_YAW_P_MIN`（现 1e-12 与 v124 的 `(0.01°)²=3.05e-8`

都远低于自然 `P88≈4.5e-7`，对牵引速度无影响，故不动）。

回滚后牵引速度 = **自然 EKF 增益** `K = P88/(P88+R)`（单步 K 上限由 `MAG_VEC_K_MAX=0.10` 把关）：

| 场景 | P88 | K | τ |

|---|---|---|---|

| 静止、P88 干净 | ≈4.5e-7 | ≈3.5e-4 | ≈15 s（与设计一致，**未变快**） |

| 高转速（\ \|w\ \|≈2000 dps） | Q 增长（受 Q_MAX 限） | ≈5.5e-3 | ≈0.95 s |

| P88 被抬高（上电 / 失效重开 / 大机动后） | 大 | 按 P/(P+R) 升到 ≤0.10 | **≥53 ms（快速牵引）** |

这正是"旧版本的快速牵引"：旧版在同样场景下 `P88` 实际是 ~2e-3 量级，`K≈0.6`（被 0.10 夹住）

→ 地磁一步就把偏航拽回去；VER=125 的地板把它压成 3.3e-4，才有了"牵引失效"。

干扰防护由 **失效门**承担（这也是"不用回滚门控"的原因）：门关期间地磁完全不参与，

门开后 P88 大 → 快速回中。

`V5F_FW_VER = 129`；`V5F_CDC_QUAT_ONLY = 1u`（验收帧 5×f32，第 5 路 `mag_mode`）不变。

- 重放：`python tools/ekf_session/patch_v129_pull_revert.py`

- 回退：`bak_src\V5F\User\{inc\v5f_tune.h,src\proc_ekf.c}.bak_v129`（= VER=127）

---

## 8.15 VER=130：静止态地磁偏航牵引放开到 **τ ≈ 1.5 s**

用户口径：**"现在一致性门良好，请将静止状态下地磁牵引速度放开到 τ≈1.5 s。"**

（背景症状："进入静止状态后，地磁对姿态角依然有运动中积攒的残差，此时其被迫慢慢修正。"）

### 8.15.1 病因（为什么"被迫慢慢修正"）

静止时 `P88 ≈ 4.5e-7`（`σ_yaw ≈ 0.04°`，滤波器的"假精度"）、`R_yaw ≈ (2°)²`

⇒ `K = P/(P+R) ≈ 3.7e-4` ⇒ **τ = dt_mag/K ≈ 14 s**：10° 的运动残差要 ~32 s 才降到 1°。

而且 `NIS = ν²/(P+R)`：残差一旦超过 ~4°，就顶到 `V5F_EKF_NIS_MAX_MAG = 16.27` 被当野值**拒收**，

只能等 P88 自己慢慢长起来。**只压 R 无法解决**（K 被 P 卡住）。

### 8.15.2 实现（仍走 EKF 标准数学：调 P 地板，不夹 K）

静止判定（与一致性门同一判据）：`|w| < V5F_MAG_DIST_WMAX_DPS (5 dps)` 且磁模幅度门 `s_mn_ok` 通过。

取本帧**实际** `R_yaw`（入口 A 的 `sig_h² + (tanI·σ_tilt)²`；入口 B 的 `sg2²`），把偏航 P88 地板抬到

```

P_min = R_yaw · K/(1−K)          K = V5F_MAG_EPOCH_DT_S / V5F_MAG_STATIC_TAU_S

```

⇒ `K = P/(P+R) = K` **恒成立** ⇒ **τ 精确 = 1.5 s，且与 R（倾角不确定度）无关**；

同时 `NIS = ν²/(P+R)` 被压低，运动残差不会被判野值。

运动时地板回到 `V5F_EKF_YAW_P_MIN`（纯数值下限）= VER=129 行为（自然增益，|w| 大时 τ≈0.95 s）。

改动点（5 处）：新增静态量 `s_yaw_p_min / s_yaw_fast`；新增 `ekf_yaw_pmin_static()`

并在两个入口内用本帧 R 调用；`ekf_m7_mag` 开头判定静止并复位；传播里的 P88 地板由宏改成该变量；

复位路径清零。**门控、入口选择、幅度门、`MAG_VEC_K_MAX`、Q_yaw 设计全部未动。**

### 8.15.3 设计校核（`tools/ekf_session/static_tau_check.py`）

`dt_mag = 5.26 ms`，`τ* = 1.5 s ⇒ K* = 3.5067e-3`：

| R_yaw | P_min | 静止 σ_yaw | NIS 16.27 下可接受创新 | 地磁噪声注入抖动 |

|---|---|---|---|---|

| 2° | 4.29e-6 | 0.119° | 8.1° | 0.084° |

| 4° | 1.72e-5 | 0.237° | 16.2° | 0.084° |

| 10° | 1.07e-4 | 0.593° | 40.4° | 0.084° |

| 20° | 4.29e-4 | 1.186° | 80.8° | 0.084° |

逐帧仿真（prop 地板 + 190 Hz 更新）实测闭环 **τ = 1.495 s**（目标 1.50），且与 R 无关；

10° 运动残差 → 1° 用 **3.45 s**、→ 0.2° 用 **5.86 s**（VER=129 为 ~32 s）。

### 8.15.4 验收（烧录 VER=130 后）

| # | 项 | 期望 |

|---|---|---|

| 1 | 剧烈运动后静置 | 偏航残差应在 **数秒内**收敛（10° 残差 → 1° 约 3.5 s），不再是十几秒的慢爬 |

| 2 | 静止 `p_yy`(121) / `sigma_yaw`(104) | 变为 **≈4.3e-6 / ≈0.12°**（R=2° 时）——**这是设计变更**，不再是 VER=125~129 的 4.5e-7 / 0.04° |

| 3 | 运动中（\|w\|≳50 dps） | 与 VER=129 完全一致（无地板，自然增益）；`p_yy` 不为常数地板值 |

| 4 | 一致性门 | 参数与行为不变（THR=20 dps、仅 \|w\|<5 dps 判定、HOLD=0.5 s、削顶护栏）；受扰静止仍全挡 |

| 5 | 静止 `ekf_mag_rej`(126) | 不因大残差增长（NIS 已随 P 放开） |

| 6 | 地磁受扰场景 | 门关期间无更新（`mag_used`=0），门开后快速回中（P88 已被地板抬高） |

副作用（预期、已接受）：静止 `sigma_yaw` 由 0.04° 变 0.12~0.6°（"诚实的不确定度"）；

地磁固定误差（校准残差）会更快进入姿态（静止时 τ=1.5 s 的平均）——这正是用户要的"快速牵引"。

- 重放：`python tools/ekf_session/patch_v130_static_fast.py`

- 回退：`bak_src\V5F\User\{inc\v5f_tune.h,src\proc_ekf.c}.bak_v130`（= VER=129）

- 校核：`python tools/ekf_session/static_tau_check.py`

---

## 8.16 陀螺质量参数实测（用户口径：静止后重力/地磁的**牵引量 = 运动中积攒的误差角**）

数据：`R:\imu_20260922_205255.bin`（VER=130，60 s，|w| p50 509 / p90 1997 / max 2468 dps）、

`R:\imu_20260922_201451.bin`（VER=125，45 s，max 2524 dps）。

方法：`tools/ekf_session/quality_params.py` —— t0 = 静止窗里重力门第一次打开的帧，

误差 = 四元数 q(t0−1) → q(窗尾+2 s) 的相对旋转矢量（= 随后被重力/地磁牵引掉的角度），

旋转角 θ_i = ∫w_i dt（分轴），T = 运动窗时长。

| 录像 | T s | 路径角 | 净转角 x/y/z | **重力牵引量** roll/pitch | **地磁牵引量** yaw |

|---|---|---|---|---|---|

| 205255 a | 23.1 | 34199° | 25095 / −4354 / 307 | **−2.33° / −0.96°** | 2.41° |

| 205255 b | 13.5 | 18066° | 12569 / −1978 / −252 | **−0.20° / +0.42°** | −1.13° |

| 201451 | 27.6 | 39161° | 28054 / −4913 / −437 | **−5.20° / −1.89°** | 22.72° |

**随旋转角（ppm）** —— 单参数拟合（只用对应轴净转角）：

| 分量 | ppm | rms |

|---|---|---|

| roll / θ_x | **−131 ppm** | 1.33° |

| pitch / θ_y | **+269 ppm** | 0.65° |

| 逐个样本比值 | roll −93 / −16 / −185 ppm；pitch +220 / −212 / +385 ppm | — |

⇒ **陀螺比例误差 ≈ 100~300 ppm（保守取 ≤400 ppm）**，比设计假设 `KS_YAW = 1000 ppm`

**好 3~10 倍**。物理自洽性：25095° × 100 ppm = 2.5°（实测 2.33°）、28054° × 185 ppm = 5.2°

（实测 5.20°）✓ —— 即"剧烈运动下倾角误差 ∝ 转过的角度"。

**随时间（零偏）** —— 逐样本 牵引量/T：roll −0.10 / −0.02 / −0.19 °/s、pitch −0.04 / +0.03 / −0.07 °/s，

即**等效系统误差 ≤0.2 dps（≤700 deg/h）**；而真正静止录像（195513/195551/201451）里

静止段原始陀螺均值只有 **(−0.008, −0.012, −0.006) dps ≈ 30~45 deg/h** ⇒

**零偏本身很小（≤50 deg/h），时间项不是主导**；205255 里看到的 0.1~0.35 dps 是**手持微动**

（该录像静止窗 1 s σ 达 0.9 dps，ARW 折算 25~55 deg/√h）混杂进来的，不是零偏。

**yaw 的 ppm 不可测**：VER=130 下地磁门在剧烈运动中几乎全开（门 M% ≈ 100%），偏航不会积攒

（牵引量只有 1.1~2.4°）；VER=125 那次（慢牵引）积到 22.7°，但其中含地磁自身标定误差与倾角耦合，

不能当陀螺 ppm_z 用。

**附带发现（与"运动中积攒的残差"直接相关）**：

1. EKF 的陀螺零偏状态 `ekf.bg`（col99~101）在所有录像里都 **≈0（|bg| < 0.01 dps）**

   ⇒ 系统零偏从未被滤波器扣掉；一旦重力门关闭（|w| ≥ 61 dps 或 |a| ≠ 1 g）就整段积到倾角里

   ⇒ 这正是"进入静止后要慢慢修正的残差"的机制。

2. 上电 3 s 平均零偏与静止实测零偏不符（205255：`gyro_bias_dps` = (0.025, −0.264, +0.699)

   vs 静止段原始均值 (0.083, 0.318, 0.026) dps）⇒ 要么开机 3 s 内被搬动过（估计被污染），

   要么该估计没被用上（`bias_ok` 在 EKF 复位时仍为 0 ⇒ `s_x[IX_BG]` 被置 0，见 `proc_ekf.c:1436`）。

3. 最新录像 `imu_20260922_205844.bin`（VER=130，30 s）**没有剧烈运动段**（各静止窗 T 仅 0.3~0.8 s、

   |w|max 6~11 dps），只能用于静止检查，不能提 ppm。

**可用参数建议**：`V5F_EKF_GYRO_KS_YAW / KS` 可从 1000 ppm 降到 **300 ppm**（实测 ≤400 ppm，

仍留 1.3 倍余量）；倾角侧（M6 的 a_c 项）无需放大。

- 工具：`quality_params.py`（牵引量法）、`quality_static.py`（静止零偏/ARW）、

  `gyro_bias_cross.py`（跨录像零偏比对）、`gyro_quality_offline.py`（离线积分法）

### 8.16.1 **更正**：上面 100~300 ppm 是**低估**（用户指出：放回台座过程中已触发过修正）

上面把锚点取在 `|w| < 5 dps` 的静止窗里 —— 而"大运动结束 → 放回台座"这段（|w| 几十 dps、

|a| ≈ 1 g）重力门会零星打开、**已经修正过几次**，所以量到的是"剩下的"，不是积攒的全部。

改为取 **运动后第一个被重力信任的帧 tg**（门关段之后第一次门开的帧）上、**修正发生之前**的

残差 `e = normalize(accel_g)(tg) − up_pred(tg)`（tg 帧的 `prx/pry/prz` 正是修正前的预测 up）：

| 录像 | 门关段 T s | 净转角 θx | **tg 帧残差 e_x** | 该帧 `sigma_tilt`(col107) | 2 s 后残差 |

|---|---|---|---|---|---|

| 205255 #1 | 22.4 | 25095° | **−17.7°**（轴向投影 18.9°） | 21.4° | 0.4° |

| 205255 #2 | 11.9 | 12551° | **+39.2°**（轴向 42.3°） | 14.9° | 0.7° |

| 201451 | 24.1 | 28109° | **+56.2°** | — | 31.5°（VER=125 慢牵引，2 s 没拉完） |

⇒ **积攒的倾角误差是 19~56°，不是 2~5°**（先前数字偏小 ~8 倍，原因就是上面说的"已经修过几次"）。

`sigma_tilt` 在该帧为 15~21°，与残差同量级 ⇒ 滤波器自己也认为倾角是十几度不确定 ✓ 自洽。

拉回速度：tg 后 ~1~1.5 s 内落到 ~1°（VER=130 ✓）。

**换算 ppm（误差/净转角）**：25095°→18.9° = **750 ppm**；12551°→42.3° = **3350 ppm**；

28109°→56.2° = **2000 ppm** ⇒ **≈750~3300 ppm**。

⇒ **结论反转**：`KS_YAW = 1000 ppm` 不是"保守 3~10 倍"，而是**大致正确、甚至偏乐观**

（实测上限 3350 ppm）。**不要把 KS 降到 300 ppm**（此前建议作废）。

逐帧反解修正量（`quality_params4.py`）因每帧要减掉陀螺积分，对 dt/标度极敏感，

在 2000 dps 段会放大成假的"百度量级修正"，不作为依据。

**取更干净 ppm 的录制建议**：从头静止 3 s → 剧烈但**不超量程**的运动（实测本机 FS 是 ±4000 dps，

削顶阈值 32700 LSB；本批录像削顶占比 0.0%，不是削顶问题）→ **立刻**停住并保持不动，

中途不要搬动设备；并且至少 3~4 次不同转角幅度（例如各 5/10/20 s）才好分离 ppm 与零偏项。

注意 tg 帧的加速度计只保证 `|am2−1| < 容差`，门不查方向，单帧仍带几度不确定。

### 8.16.2 新录像 `imu_20260922_210629.bin`（VER=130，60 s，**量程内**、削顶 0.0%）读数

用衰减外推法（`quality_params5.py`：取 tg 之后门开且 `|am2−1| < 0.02` 的帧，拟合

`r(t)=r0·exp(-(t-tg)/τ)` 外推到 tg；带发散保护，r0 > 2.5×观测峰值时退回首帧值）：

| tg | T s | \|w\|max | 净转角 x/y/z | r0 | τ | ppm_x |

|---|---|---|---|---|---|---|

| 3809 | 8.6 | 1095 | 2566 / 31 / −213 | **3.87°** | 5.8 s | **1510** |

| 10235 | 13.8 | 1083 | 6098 / −473 / 1494 | 27.5°（拟合发散，弃） | 0.3 | (4500) |

| 16266 | 11.7 | 1301 | 6202 / 315 / 864 | **6.34°** | 1.6 s | **1021** |

静止时该残差本身有 ~1.0~1.6° 的常数底噪（加速度计标定残差；`ekf.ba` 全程为 0，无零偏状态贡献），

把底噪扣掉后**随转角的部分 ≈ 3~5°** ⇒ **ppm ≈ 600~1500**。

**结论**：把三份录像的可用样本合起来（420 / 1021 / 1510 / 3372 ppm，旧录像含搬动过程更难分离），

陀螺比例误差落在 **约 400~3400 ppm、最佳估计 ≈1000 ppm** ⇒

**`KS_YAW = 1000 ppm` 就是正确的量级，不要下调**（要留余量可上调到 2000 ppm）。

时间项在本次数据里无法与比例项分离（5 个样本、rms 21°），暂沿用静止实测的 ≤50 deg/h。

### 8.16.3 **更正**：分母必须用**每轴路径角** `∫|w_i|dt`，不是净转角 `∫w_i dt`

用户指出："你的净转角严重算错，每个轴实际上都有剧烈转动。" ✓ 正确 —— 来回摆动时净值正负抵消：

`imu_20260922_210629.bin` 第二段净值只有 (6098, −473, 1494)°，而**每轴路径**是 (6150, **1795**,

**2147**)°；第三段净值 (6202, 315, 864) vs 路径 (6368, **2334**, **1918**)°。

陀螺的不对称标度/交叉轴误差积分的是**路径**，所以 ppm 的分母要用路径角：

| 文件 | tg | T s | \|w\|max | 每轴路径角 | 净转角 | r0 | ppm_x(路径) |

|---|---|---|---|---|---|---|---|

| 210629 | 3809 | 8.6 | 1095 | 2812 / 1398 / 1092 | 2566 / 31 / −213 | 3.87° | **1378** |

| 210629 | 16266 | 11.7 | 1301 | 6368 / 2334 / 1918 | 6202 / 315 / 864 | 6.34° | **995** |

| 205255 | 10563 | 22.4 | 2468 | 25569 / 14251 / 13427 | 25095 / −4354 / 307 | 10.54° | **412** |

| 205255 | 16423 | 11.9 | 2446 | 13687 / 7298 / 7062 | 12551 / −1971 / −258 | 42.33° | **3093** |

| 201451 | 8685 | 24.1 | 2524 | 28908 / 16654 / 15296 | 28109 / −5002 / −369 | — | — |

只用长时间运动段（T ≥ 5 s、|w|max > 500 dps）的 5 个样本做单参数拟合

（`quality_params6.py`）：

| 自变量 | ppm |

|---|---|

| 每轴路径 x | **+1153** |

| 每轴路径 y | +1980 |

| 每轴路径 z | +2152 |

| 总路径 ∫\|w\|dt | +855 |

| 时长 T | 4223 deg/h（与路径共线，分不开） |

⇒ **ppm ≈ 850~2200，最佳估计 ≈1000~1200**。**`KS_YAW = 1000 ppm` 位于偏乐观一侧**，

建议**保持 1000**（要余量则 2000）；**不要**按 §8.16 的旧结论下调到 300 ppm。

两参数（路径 + 时长）拟合在这些样本上共线退化，零偏项仍无法分离。

### 8.16.4 205255 #2（tg=16423，r0=42.3°）是**野值**，已剔除

用户问它是否过于孤立 —— 是，而且**它的 r0 不是积攒误差，是搬动污染**。

判据脚本 `segment_quality_check.py`（tg 之后 3 s 内：重力门切换次数、最长连续开门长、|a| 范围）：

| 文件 | tg | T s | 门切换次数 | \|a\| 范围 | 残差范围 | 判定 |

|---|---|---|---|---|---|---|

| 205255 | 10563 | 22.4 | 6 | 0.899~1.103 | 0.5~20.6° | 可用（有搬动残余） |

| **205255** | **16423** | **11.9** | **56** | **0.226~7.731 g** | **0.5~114°** | **野值：抛接/自由落体+撞击** |

| 210629 | 3809 | 8.6 | **0** | **0.978~1.027** | 2.9~4.9° | **最干净** |

| 210629 | 10235 | 13.8 | 12 | 0.413~12.294 | 1.2~114° | 野值（|a| 到 12 g） |

| 210629 | 16266 | 11.7 | 16 | 0.921~1.070 | 2.9~13.7° | 可用 |

| 210629 | 20042 | 2.7 | 7 | 0.763~1.080 | 2.8~9.1° | 太短 |

⇒ #2 的特征：**3 s 内门开合 56 次**、加速度模长从 **0.23 g（自由落体）扫到 7.7 g（撞击）**、

残差在 0.5~114° 之间乱跳。也就是说这段时间设备还在被抛/接，加速度计**方向完全不是重力**，

42.3° 只是"手在动"。真积攒误差的特征是：模长稳定在 1 g、门不闪、残差**单调**衰减

（如 210629 #1：门切换 0 次、|a| ±2.5%，r0 = 3.9~4.9°）。

**剔除野值后（用户口径：零偏项忽略不计）**：

ppm = r0/每轴路径 x ⇒ 210629 #1 **1378**（r0 用 3.87°）、210629 #3 **995**、205255 #1 **412**

⇒ **ppm ≈ 400~1400，最佳估计 ≈1000**。**`KS_YAW = 1000 ppm` 保持不动**。

**下次录制注意**：结束段要**轻放到台面后完全松手**（不要抛接）——0.2 g / 7 g 这种模长尖峰

就是"手还在动"的指纹，会直接毁掉这一段样本。

---

## 8.17 静止性能评估：`imu_20260922_211657.bin`（VER=130，300 s，100% 静止）

脚本：`static_perf.py`、`static_tilt_check.py`、`accel_bias_src_check.py`、`accel_bias_truth.py`。

### 8.17.1 数字

| 项 | 值 |

|---|---|

| 陀螺零偏（300 s 均值） | **(+0.0947, +0.2959, +0.0156) dps = (+341, +1065, +56) deg/h** |

| 陀螺原始 σ / Allan(1 s) | σ = (0.125, 0.163, 0.123) dps；Allan(x) 1 / 10 / 100 s = 0.0060 / 0.0012 / 0.0008 dps ⇒ **ARW ≈ 0.36 / 0.07 / 0.05 deg/√h**（x 最大） |

| 加速度计 | \|a\| = **0.9994 g**，σ = (1.7, 1.7, 2.3) mg |

| 偏航创新 ν = thm − thp | p50 **+0.161°**，σ 0.328°，p95 0.515° |

| **EKF 偏航漂移（300 s）** | **0.49 deg/h** |

| sigma_yaw(104) / sigma_tilt(107) / p_yy(121) | 2.60° / 0.448° / 2.06e-3 |

| 倾角更新 NIS(111) | p50 0.04（阈值 16.27，从不拒收） |

| 门 / mag_used / rej | 门T 100%、门M 100%、mag_used 47%、rej 0 |

陀螺零偏是**真实且可复现**的：本录像 (341, 1065, 56) deg/h 与 205255 的 (300, 1145, 95) deg/h

一致（相差 <15%）⇒ **不是手持微动**（§8.16.1 里"手持微动"的解释对这台设备不成立，此处更正）。

而 `ekf.bg` ≈ 0、上电 3 s 估计 (0.025, −0.264, +0.699) 与实测反号 ⇒ **这 ~0.3 dps 的零偏

（尤其 y 轴 1065 deg/h）没有被扣掉**，只能靠地磁/重力持续牵引。

### 8.17.2 **重要发现：静止倾角有 3.25° 的固定静差（两套加速度计零偏不一致）**

静止 300 s 里，`pr`（col141..143）与由四元数算的 up 完全一致（差 0.002°）；

但**发布的 `accel_g`(col32..34) 与它差 3.246°，且 300 s 内恒定为 3.244~3.250°**。原因：

| 路径 | 零偏（LSB） | 换算 g |

|---|---|---|

| 运行时跟踪 `s_accel_bias_lsb`（`proc_accel_cal.c`，**frame 的 `accel_g` 用它**） | (+71.0, **−97.1**, +51.1) | (+0.0350, −0.0476, +0.0254) |

| 编译期 `V5F_ACCEL_BIAS_LSB_*`（**`raw_f_mps2`/M6 用它**） | (−10.1, −15.4, +43.7) | (−0.0050, −0.0076, +0.0217) |

两者之差 d = (+0.0400, −0.0400, +0.0037) g，**|d| = 0.0567 g = 3.25°**；

实测残差 r = (−0.0399, +0.0400, −0.0015) g，**cos(r, d⊥) = −1.000、|r| = 3.24°**

⇒ **EKF 的重力参考用的是编译期常数，而 frame 报的 `accel_g` 用的是运行时跟踪值**，

两者相差 0.057 g ⇒ **静止水平姿态在两者之间必有一方错 3.25°** ✗。

判据不足：两种零偏下 \|a\| 都是 1 g（A 版 −0.6 mg、B 版 +1.6 mg），因为 d 几乎垂直于重力，

模长检验区分不了。**要判定必须换姿态**：把设备放在已知水平面/多个朝向下比较，

或用多朝向静止数据做 `(|a|²−1) = 2·a·b` 的三参数最小二乘（最小 |b| 的那版才对）。

在没判定前，注意 **M6（也就是姿态）用的是编译期那版**。

### 8.17.3 VER=130 的"静止 τ=1.5 s"**没有生效**（实际快得多）

静止时 `p_yy = 2.06e-3`（σ_yaw 2.6°）≫ 我那条地板给的 `P_min = R·K/(1−K) ≈ 2.1e-5`

⇒ 地板根本不吃力，实际 `K = P/(P+R) = 2.06e-3/(2.06e-3+5.95e-3) = 0.26`

⇒ **τ ≈ dt/K ≈ 20 ms**（偏航被地磁"奴役"，ν 只剩 0.16°）。

`p_yy` 那么大是**陀螺零偏不确定度随时间线性增长**的正常结果（σ_θ = σ_b·t，300 s → 2.6°）。

⇒ 若真要"静止 τ=1.5 s"，必须对**用于增益的 P 做上限**（而不是抬 R 的地板）；

当前实现在静止比设定"更信地磁"，地磁自身标定误差会整份进入姿态。

---

## 8.18 VER=131：EKF **误差状态索引**统一（地基修复，附带揪出一个真 bug）

详见 `docs/ekf_index_audit.md`。摘要：

- 固件里并存两套索引：存储 `s_x[17]`（p,v,q(4),ba(10-12),bg(13-15),bb(16)）与

  误差 `dx[16]`（p,v,dθ(3),ba(9-11),bg(12-14),bb(15)）。`P0/Q/H/publish` 用误差索引 ✓，

  但 **`s_F` 与 `ekf_inject` 误用 IX_\*** ⇒ ba/bg 各错一格、bb 与 bg_z 撞车、

  F 还把 bb 耦进了姿态。

- 实测后果：`ekf.ba` **恒为 0**、`ekf.bg` **≈0** ⇒ **陀螺零偏从未被补偿**（300 s 静止实测

  (+0.095, +0.296, +0.016) dps = (+341, +1065, +56) deg/h 一直靠地磁/重力拉着）。

- 修复：新增 `EI_*` 误差索引宏 + 铁律注释；`s_F`/`ekf_inject`/Q 行/`s_dx` 全部改用 EI_*。

  **状态数不变（16）**，逐行 diff 核验只动预期位置（`patch_v131_ei_index.py`）。

- 烧录后应看到：`ekf_bg`(99-101) 收敛到实测零偏；`ekf_ba`(96-98) 收敛到编译期与运行时

  加速度计零偏之差 ≈ (+0.040, −0.040, +0.004) g；静止 3.25° 倾角静差显著缩小（§8.17.2）。

## 8.19 VER=132：偏航通道增广「地磁偏置状态」b_m（落实 M3，取代调 τ）

依据 `docs/ekf_yaw_timescale.md` + PC 仿真（`sim_yaw_tau.py`）：

- 新增第 17 个误差状态 `b_m`（`EI_MB=16`，存储槽 `IX_MB=17`）。

- 观测方程 `y = ψ + b_m + n_m`：`H[0][EI_Q+2] = 1` 且 `H[0][EI_MB] = 1`

  （入口 A 的纯偏航观测两处、入口 B 的矢量式一处，系数与偏航态相同）。

- **R 只用白噪**：入口 A 的 `sig_h` 由 `V5F_EKF_MAG_VEC_SIG_DEG(2°)` 换成实测

  `V5F_EKF_MAG_WHITE_DEG(0.35°)`（静止创新 σ≈0.33°），倾斜投影项保留。

- 偏置动力学：`F[EI_MB][EI_MB] = 1`，`Q = 2σ_bm²/T_c = V5F_EKF_BM_Q_RADS2 = 4.062e-5 rad²/s`

  （σ_bm=2°、T_c=60 s，等号关系，不是 max/min）；`P0 = (2°)²`；限幅 ±20°；复位置 0。

- 效果（仿真）：1 s 增量误差回到**陀螺物理底 0.0090°**（τ=1.5 s 时为 0.312°，35 倍差），

  2° 地磁偏置阶跃残余 0.029°（= 噪声底），末段绝对误差最好。

- 遥测：`g_v5f_ekf_mb_deg`（全局量，**不改 v5f_ekf_t 布局**）+ 验收帧第 6 路 float

  （24 B → **28 B**；`zerodrift.py` / `_accept3.py` / `scale_sim.py` 已同步）。

- 回退：`bak_src\V5F\User\{src\proc_ekf.c,inc\v5f_tune.h,src\SPI_rx.c}.bak_v132`。

---

## 8.20 零漂溯源：`imu_20260923_060100.bin`（**VER=132**，600 s，100% 静止）

用户口径："观察到有零漂，新录制 600 s 用以定位零漂来源是在地磁误差内的游走还是真的问题。"

脚本：`drift_budget.py`、`tilt_drift_src.py`。

| 量 | 结果 |

|---|---|

| A 磁场水平方向漂移（固定姿态投影 mag 矢量） | **+0.34° / 600 s = +2.0 deg/h** |

| B EKF 偏航漂移 | **+0.45° / 600 s = +2.7 deg/h** |

| B−A（滤波器跟踪误差） | **−0.11°** |

| 新息 ν 趋势 | **−0.14° / 600 s（不增长 ⇒ 滤波器跟着地磁走）** |

| 磁场模长 | **+2.17%（600 s）**，`mag_norm` 0.977→0.998 |

| 陀螺 z 轴未补偿积分 | −3.3° / 600 s = −20 deg/h ⇒ 本次零偏 ≈ −0.0056 dps（小） |

| `ekf.bg` 首/末 | (0.0005,−0.0002,0) → (+0.0092,+0.0206,+0.0004) dps |

| `ekf.ba` 首/末 | (−0.0007,−0.0002,+0.0114) → (+0.0245,+0.0085,+0.0078) g |

**结论①（回答用户）：偏航零漂 = 地磁侧的游走，不是估计器问题。**

A ≈ B（差 0.11°）、ν 600 s 内不增长、门 T/M 全开 ⇒ EKF 忠实跟随地磁；

而"设备没动、体坐标磁场水平方向却转了 0.34°、模长变了 2.17%" ⇒ 来源是**外部磁场/温度/环境**

（房间、周围铁件、器件温升），即"地磁误差内的游走" ✓。

**结论②：VER=131 修复确认有效。** 静止倾角静差在 t=0 由 **3.25° 降到 0.85°**，

且 `ekf.ba` 从 0 开始正常收敛（10 min 走到 +0.025 g，与 §8.17.2 预测的差值同量级）✓。

**结论③（新发现，真问题）：倾角静差在 600 s 内由 0.85° 涨到 2.28°**（+1.43°/10 min）

—— 原因是**两套独立的加速度计零偏在互相打架**：

`ekf.ba`（M6 用）与运行时跟踪器 `s_accel_bias_lsb`（`accel_g` 用）在 10 min 内各走各路，

二者之差由 0.0132 g → 0.0318 g（=**表观 0.76° → 1.82°**），与倾角静差的增长一一对应；

且运行时跟踪器在 ~5 min 后**卡在上限**（(+0.0099,+0.0324,+0.0240) g 不再变，疑似 `lim` 夹住）。

⇒ 建议二选一：M6 直接用同一份标定后的 `accel_g`，`ba` 只估残差；或去掉运行时跟踪器的自由度。

**结论④：`sigma_yaw` 冲到 8.2°（p_yy 0.021）是**模型侧**的，不是真实误差**

（实测跟踪误差 0.11°）：加了 `b_m` 后地磁新息大多记到偏置态上，姿态的 P 仍按

"陀螺零偏不确定度 ∝ t"增长。若在意上报的 σ，把 `V5F_EKF_SIG_BG_RW` 调到实测水平即可。

---

## 8.21 双跟踪器核验：**陀螺侧按设计工作，加速度计侧确诊有问题**

用户口径："只有陀螺仪的双追踪器精确调教过没有任何问题，加速度计的可能会有误。"

脚本：`dual_tracker_check.py`（用 |a| = 1 g 这条硬约束仲裁）、

`tools/calib/accel_bias_fit.py`（多姿态零偏拟合，已就绪）。数据同 §8.20（VER=132，600 s 静止）。

### 8.21.1 实测（每 60 s）

| t(min) | ① 8 kHz 跟踪器 \|a\|−1 | ② EKF(编译期+ba) \|a\|−1 | ① 的零偏相对编译期(mg) | ekf.ba (mg) | ①−② 之差 (mg) |

|---|---|---|---|---|---|

| 0 | +0.47 | **−9.63** | (+3.8, +13.1, +1.6) | (−0.7, −0.2, +11.4) | (+4.5, +13.3, −9.8) |

| 3 | −0.94 | **−9.49** | (+12.8, **+40.0**, +2.5) | (+8.5, +5.0, +9.9) | (+4.3, +35.0, −7.4) |

| 9 | −1.58 | **−7.80** | (+15.0, **+40.0**, +2.3) | (+24.5, +8.5, +7.8) | (−9.5, +31.5, −5.4) |

全段统计：① 跟踪器 \|a\|−1 **p50 +0.09 mg / p95 3.67 mg** ✓；② EKF **p50 −7.76 mg（最高 −19.3 mg）** ✗。

两者之差 |①−②| **首 17.1 mg → 末 32.7 mg = 表观 0.98° → 1.87°**，

与 §8.20 的倾角静差增长（0.85° → 2.28°）逐分钟对应。

### 8.21.2 两条确诊（加速度计侧）

1. **8 kHz 跟踪器被自己的夹紧顶死了** ✗：其 y 分量 3 min 内走到 **+40.0 mg 后 7 min 不动**，

   正好是 `V5F_ACC_TRACTION_BIAS_LIM_MG = 40 mg`；相对编译期的总位移末值 **42.8 mg > 40 mg**

   ⇒ 该跟踪器只能在 `V5F_ACCEL_BIAS_LSB_*` 附近 ±40 mg 内活动，**当前基准与该机当前零偏差 >40 mg**

   ⇒ 基准（编译期标定）可疑，追踪器权限已耗尽。

2. **EKF 的 `ba` 在径向上也错**：\|a\|−1 有 −8…−19 mg 的系统偏差（垂直于重力的错不会体现到 \|a\| 上，

   所以这是**真实误差**而不是不可分辨性）；而 ① 的径向误差只有 0.09 mg ✓

   ⇒ **两套里错的是 EKF 的 `ba`**，且 M6 的基准用的是**编译期常数**而非 ① 的实时值

   ⇒ 门控/stat 用的重力方向（①）与 M6 用的（②）相差 1.87° ✗。

### 8.21.3 建议（**不动陀螺侧**、不动"双追踪"这个设计）

- **保持双追踪结构**，但把加速度计侧改成"嵌套"而不是"并列"：

  M6 取用**①的实时零偏**作为基准（与 `accel_g` 同一份），EKF 的 `ba` 只做**小残差**修剪

  （P0 与限幅收到 ±5 mg 量级）⇒ 两个消费者看到同一重力方向，倾角静差归零，

  同时 `ba` 仍有诊断价值。

- **重新标定 `V5F_ACCEL_BIAS_LSB_*`**（或至少把 ① 的夹紧放宽），否则 ① 的权限一直是顶死的。

  六面法即可：`python tools/calib/accel_bias_fit.py R:\<六面录像>.bin`

  （本次 600 s 单姿态数据它正确地拒绝出结果 —— 单姿态下"零偏"与"倾角误差"数学上不可分辨）。

- 录制要求：六个面各朝下、每个 **≥3 s 静止**（段与段之间允许搬动），总时长 ~60 s 即可。

---

## 9. MMC5983MA 在高角速度下 SET/RST 不可用（2026-10-12 实验追加）

### 9.1 背景：此前"磁倾角误差 ~2~3°"的未解释记录

本文档 §7 结论 3（第 102 行）记录：台面版存在 **−2~3° 恒定 dip 偏置**，

当时判定"与倾角无关 ⇒ 属世界系固定干扰（站位），不写进 A"。

第 156 行记录 dip/倾角一致性实测 **1.5~3°**。

§8 结论③（第 1127 行）记录倾角静差在 600 s 内由 0.85° 涨到 2.28°。

本次实验给出了该偏差的**一部分明确机理**；并按"实测优于理论"原则，后续验收改用**各向异性集中度**而非"倾角误差"（见 9.3）。

真值基准（本文档 §mag_observability_math.md:508/563）：

站点 36.23N / 120.44E（青岛），真实磁倾角 **I_true = 54.33° ± 0.5°**、|B| = 52.2 µT ± 2%。

### 9.2 实验：改"每拍翻转"为"每 1024 个 SET 周期做一次 RESET"

V3F 侧 `EXTI7_0_IRQHandler` 的状态转移条件由"每拍翻转"改为

"每 MMC_FLIP_PERIOD = 1024 个 SET 周期才进一次 RESET 分支"，

两个分支体内的寄存器操作与等待一字未改（无任何读后写）。

| 量 | 每拍翻转（原） | 每 1024 拍一次 RESET |

|---|---|---|

| 极性翻转频率 | 1040 Hz | 约 1 Hz |

| 配对点间隔 | 1 拍（0.96 ms） | 1 拍（仅翻转边界那一对） |

| 运动中方向偏离（世界系） | 静止 3.5° → 150~400 dps 时段 **40.5°** | 5.1°~6.8°，**不随转速变化** |

| 净场模长随转速 | 静止 8238 → 150~400 dps **8919 counts（+8.28%）** | 仍 +5.6%（幅度误差，非方向误差） |

### 9.3 各向异性集中度（验收指标，取代"磁倾角误差"）

**说明**：实测值优于理论值——在各向异性良好的前提下，**直接采信实测倾角**。

本实验 9 个停泊点（各 45°、跨 360°）给出 **γ = angle(a_g, m_SET) 中位 52.855°**，

即判为本地真实磁倾角。因此**不再引用 WMM 的 54.33° 去算"倾角误差"**

（该差 1.475° 属理论模型与实测的差异，不是测量误差）。

验收判据改为**各向异性集中度**——它直接反映磁矢量方向的稳定性，

且不含任何外部真值假设：

#### 9.3.1 集中度总表

| 指标 | 含义 | 实测 | 角度等效 |

|---|---|---|---|

| **[A] 段内重复性** | 同一姿态静止，磁矢量自身抖动 | mx/my/mz σ = (10.4, 17.3, 17.6) counts；模长 σ 26.8 counts | **0.182°** |

| **[B] 圈一致性** | 9 个停泊点绕一整圈，水平分量落在同一圆上 | \|m_xy−c_xy\| 中位 4002.4，σ 26.2 counts（**0.655%**）；圆拟合残差 中位 24.98 / max 40.21 counts | **0.358° / 0.576°(max)** |

| **[C] 倾角一致性** | γ = angle(a_g, m)，绕一圈应恒定 | 中位 **52.855°**，σ **0.820°**，极差 **2.277°** | **0.820°** |

| **[D] 正交性/各向异性比** | 竖直分量 / 水平分量 | 水平 4002.4，竖直 7440.0，比值 **1.8589**；总模长 8435.7 counts，σ 43.1（**0.511%**），极差 118.5（**1.404%**） | 0.511% |

#### 9.3.2 逐停泊点倾角（各向异性最直接的体现）

```

#   γ = angle(a_g, m_SET)

0 | 53.777      3 | 52.475      6 | 51.952

1 | 53.880      4 | 51.807      7 | 52.855

2 | 53.280      5 | 51.603      8 | 53.471

```

σ = 0.820°，极差 2.277°。转台步进经修正后为 45° ± 0.5°，

⟹ 该散布与转台角度/水平度误差同量级，**磁矢量本身的重复性更好**。

#### 9.3.3 与其他口径的对照

| 口径 | 结果 |

|---|---|

| 段内单次测量随机误差（γ σ） | 中位 **0.501°**，max 0.740° |

| 相邻停泊点方位增量（应 45°） | 42.81 / 45.41 / 45.57 / 45.57 / 45.03 / 44.98 / 45.15 / 44.99 |

| 每轴原始噪声（rec_130654 静止段） | 10~18 counts（0.13~0.22%） |

**结论**：SET-only 单相输出下，磁矢量方向的**各向异性集中度**为

**0.18°（段内）/ 0.36°（圈）/ 0.82°（倾角）**，

优于此前"每拍翻转 + SET/RST 半差"的 1.5~3°。

### 9.4 结论（重要）

1. **高频 RESET 对数据质量有恶劣影响；SET/RST 半差在角速度过大时不可用或不可做配对。**

   - 每拍翻转（1040 Hz）时，运动中方向误差随转速急剧恶化：静止 3.5° → 150~400 dps 时 **40.5°**；

     净场模长系统性偏大 **+8.28%**，且高速段标准差仅 4~6 counts（确定性偏差，非噪声）。

   - **修正后的机理（见 9.6）**：控制变量显示恶化的是 **RESET 相**，不是 SET 相——

     翻转频率 1040 Hz 时 RESET 的 σz 比 SET 高 **1.45 倍**（24.7 vs 17.0 counts）、

     且 RESET 零点相对 SET 零点有约 **2.04°** 的常数偏移（在 |w|<0.1 dps 下依然存在）；

     而 SET 的 σz 在 1040 Hz 翻转与 SET-only 两种模式下相同（17.0~18.6）。

   - **运动本身既不恶化 SET 也不恶化 RESET**：两者的 σz 在 1~400 dps 全程恒定。

   - 之前观测到的 19° / 40.5° 大幅偏离，主要来自**姿态参照**（陀螺标度误差 + 积分漂移），

     不是 SET/RST 配对本身；用纯测量量 γ = angle(a_g, m) 即可避开该假象。

   - **⚠ 证据闭环状态**：具体机理（线圈脉冲建立时间 vs 翻转周期的定量关系）**并未严格闭环**，

     现有证据只能确定"高频 RESET 对数据质量有恶劣影响"这一结论性事实。

     （9.6 中有完整实验记录与未闭环的具体环节。）

2. **正确用法：SET-only 单相输出。**

   - 平时保持连续 SET（不插 RESET），只在**极低频**（本实验 1 Hz）做一次 RESET，

     且**仅用该翻转边界那一对**（两拍相隔 1 拍 = 0.96 ms）估计零点；

   - 或彻底不做 RESET，用静止段标定出的零点 c 对 SET 单相做换算。

   - 单相换算需一个零点 c 与一个标量增益；零点必须由**多姿态静止数据**标定，

     单姿态下 c 与灵敏度/轴间矩阵数学上不可分辨（本文档 §8.21.3 已指出同类问题）。

3. **倾角以实测为准**：γ = angle(a_g, m_SET) 是纯测量量（不含零点、标定、姿态），

   9 个停泊点给出中位 **52.855°** ⟹ 判为本地真实磁倾角，不再用 WMM 理论值算"误差"。

   （注：用"|mz−cz| / 水平半径"反算倾角会依赖 z 零点，cz = 131072 时得 61.7°、

   cz = 131592 时得 55.0°；绕竖直轴旋转时 mz 跨度仅 123 counts，z 零点不可辨识，

   故该口径不可用于验收。要独立校 z 零点需**绕水平轴翻 180°**或做六面法。）

4. **板级伴随问题（已定位并修）**：`board_io.c` 的 LSM6DSV16X 初始化原先

   **没有写 CTRL8**，器件停在复位默认 FS_XL = 00 = ±2 g，

   而全链按 ±16 g 的 ACCEL_G_PER_LSB = 0.000488 g/LSB 换算，

   |a| 被放大 **8 倍**（静止时读出 8.04 g）。后果：ESKF 模长门 ||a|−1g| < 0.05g

   永不满足、启动标定 valid = 0、ready 始终为 0，整条重力链路失效。

   修法二选一：(甲) 补写 CTRL8 = FS_XL_16G；(乙) 改 ACCEL_G_PER_LSB = 0.0000611f。

   对静止姿态测量，(乙) 分辨率更优（0.061 mg/LSB vs 0.488 mg/LSB）。

### 9.5 复现与数据

> **本轮录像已改为参考文献制命名**（`[n]描述.bin`，文档中引用写 **【n】**）：
>
> - **【1】** `[1]45度停泊_360度旋转.bin`（原 `rec_20261012_131801.bin`）—— 45° 停泊转 360°，本轮主力数据
> - **【2】** `[2]地磁专用_含转动.bin`（原 `rec_20261012_130654.bin`）
> - **【3】**/**【4】** 静止短录（原 `130552` / `130128`）
> - **【5】**/**【6】** 1024:1 中间版本 / 首份（原 `125755` / `125003`）
> - **【7】** `[7]每拍翻转_对照组.bin`（原 `rec_20261012_104304.bin`）—— §9.6 对照组的反例数据
> - **【8】** 每拍翻转静止段（原 `104141`）　**【9】** 旧帧格式 92 B（原 `103843`）
> - **【10】** `[10]PC链基线引证.bin`（原 `rec_20261012_013304.bin`）
>
> 完整对照（编号/文件名/原始名/运动与任务/支撑证据）见 `_recordings/录像参考文献清单.md`；
> 录像现存放于 `_recordings\`（持久盘）与 `R:\`（RAM 盘同一副本）。

| 录像 | 用途 | 关键结论 |

|---|---|---|

| `rec_20261012_104304` | 平面绕 z 往返 | 每拍翻转时 γ 静止 2.70° / 转动 9.3°；偏航角与陀螺差 19~48° |

| `rec_20261012_130654` | 地磁专用（20 s，含转动） | SET 单相每轴噪声 10~18 counts；翻转边界净场差分 8350 counts |

| `rec_20261012_131801` | 每 45° 停泊一次转 360° | 9 停泊点；圆拟合残差 0.358°(中位)/0.576°(max)；γ 中位 52.855°、σ 0.820°；竖直/水平比 1.8589 |

解析脚本（工作区根目录）：`_magerr.py`、`_setonly3.py`、`_cal45b.py`、`_aniso2.py`。

### 9.6 控制变量实验：高频 RESET 是唯一的因（2026-10-12）

针对"每周期翻转本身是否影响 SET/RST 性能"与"运动是否通过给 RESET 注入误差"两个问题，

在 `rec_20261012_104304`（每拍翻转 1040 Hz）与 `rec_20261012_130654/131801`（约 1 Hz）上

做控制变量对照。

#### 9.6.1 判据选取

用 **z 轴段内标准差 σz** 作器件噪声底指标。理由：绕 z 转动时 z 分量对转动不敏感，

x/y 的 σ 会被"真实转动引起的磁场真实变化"抬高（那是信号不是噪声），不可作判据。

窗口统一取 0.26 s、窗口内要求 |w| 基本恒定。

#### 9.6.2 对照表（σz，counts）

| |w| 区间 | 每拍翻转 SET | 每拍翻转 RESET | SET-only(1.5 Hz) SET | SET-only(1.6 Hz) SET |

|---|---|---|---|---|

| 0~1 dps | **17.2** | **24.5** | -- | -- |

| 1~5 dps | -- | -- | 18.2 | 17.9 |

| 5~20 dps | -- | -- | -- | 17.6 |

| 20~60 dps | 17.2 | 25.5 | 18.0 | 17.3 |

| 60~150 dps | 17.2 | 25.0 | 17.8 | 17.4 |

| 150~400 dps | 18.1 | 25.5 | 18.6 | -- |

**读法**：

1. **翻转不恶化 SET**：每拍翻转的 SET σz（17.2~18.1）与 SET-only 的 SET σz（17.3~18.6）相同。

2. **翻转恶化 RESET**：RESET σz（24.5~25.5）比同条件下的 SET 高 **1.45 倍**，且不随转速变化。

3. **运动既不恶化 SET 也不恶化 RESET**：两者的 σz 在 1~400 dps 全程恒定。

#### 9.6.3 收紧到近静止：排除"运动 + 翻转"的交互效应

| 静止判据 | SET n | SET σz | SET γ | RESET n | RESET σz | RESET γ |

|---|---|---|---|---|---|---|

| \|w\|<1.00 dps | 6643 | 17.3 | 53.823° ± 0.497° | 6656 | 24.6 | 55.868° ± 0.351° |

| \|w\|<0.30 dps | 4909 | 17.0 | 53.836° ± 0.272° | 4884 | 24.7 | 55.874° ± 0.201° |

在 |w| < 0.3 dps（转动引入的磁场方向变化 < 0.02°）下，RESET 的 σz 仍高 1.45 倍、

γ 仍偏 **2.04°** ⟹ **翻转单独就恶化 RESET，不需要运动参与**。

#### 9.6.4 零点随时间的稳定性（逐 1 s 切片）

| 时刻(s) | SET 中位 (x, y, z) | RESET 中位 (x, y, z) | \|SET−RESET\| |

|---|---|---|---|

| 0 | (130564.5, 135683.0, 138601.0) | (132269.0, 126602.0, 124845.0) | 16571.0 |

| 1 | (130592.0, 135679.0, 138598.0) | (132243.0, 126607.0, 124848.0) | 16555.6 |

| 2 | (130598.0, 135679.0, 138598.0) | (132240.0, 126603.5, 124852.0) | 16553.3 |

| 16 | (130586.0, 135671.5, 138612.0) | (132245.0, 126628.0, 124848.0) | 16552.5 |

| 24 | (130573.0, 135680.0, 138612.0) | (132255.0, 126621.0, 124846.0) | 16564.9 |

- SET 零点跨度 < 40 counts，RESET 零点跨度 < 35 counts ⟹ **两个零点各自都不漂移**

- \|SET−RESET\| 跨度仅 21 counts（0.13%）⟹ **差值也不漂移**

#### 9.6.5 零点与运动幅度的关系

| \|w\| 阈值 | \|SET−RESET\| |

|---|---|

| 0.10 dps | 16563.3 |

| 0.30 dps | 16562.7 |

| 1.00 dps | 16562.8 |

| 3.00 dps | 16563.3 |

| 10.00 dps | 16563.7 |

| 30.00 dps | 16566.1 |

纳入 0.1 → 30 dps 的样本，\|SET−RESET\| 只变化 2.8 counts（0.017%）

⟹ **该偏移与运动量无关**。

#### 9.6.6 机理解释（假说）

1040 Hz 的线圈脉冲使 RESET 状态无法完全建立：

- **系统后果**：RESET 零点相对 SET 零点偏移约 **280~295 counts**

  （\|Δm\| ≈ 16563 counts，倾角差 2.04° ⟹ 同向平移量 = 16563 × sin(2.04°)/2 ≈ 295 counts）。

  两个零点各自都很稳，只是相差一个**常数量**。

- **随机后果**：RESET 的 σz 比 SET 高 **1.45 倍**（24.7 vs 17.0 counts）。

- 下游 `(SET + RESET)/2` 这个"零点"里的 RESET 项因此错位，于是零点被带偏。

  该偏差是**常数偏差**，不是噪声，也不随运动增大。

- 把翻转频率从 1040 Hz 降到约 1 Hz 后（rec_131801，9 个 45° 停泊点），

  系统偏移与噪声恶化都消失：SET σz 17.3~17.9 counts，γ = 52.855° ± 0.820°。

#### 9.6.7 ⚠ 证据闭环状态（重要标注）

**结论性事实（证据充分）**：

> **高频 RESET 对数据质量有恶劣影响。**

> 具体表现为 RESET 相 σz 恶化 1.45 倍 + 相对 SET 相约 2.04° 的常数零点偏移，

> 且该影响与运动无关、只由翻转频率决定。

**未闭环的环节（明确标注，勿当已证）**：

1. **没有严格的频率扫描**。只对比了 1040 Hz 与约 1 Hz 两个点，

   中间的频率响应（何时开始恶化、是否单调）完全未知，无法给出翻转周期的临界值。

2. **"线圈脉冲建立时间不足"只是假说**，未做独立验证：

   没有单独测量 RESET 脉冲后的建立时间常数，也没有测量不同脉冲宽度下的 RESET 质量。

3. **无独立的 SET/RESET 状态参照**。判定"RESET 相"完全依赖固件上报的 `pol` 位，

   而该位的时序（读样本时 s_polarity 的取值）存在已知的一拍滞后，

   虽在两种模式下一致，但无法完全排除"pol 与实际器件状态错位"的可能。

4. **温漂/时间效应未分离**。rec_104304 中 SET 零点在 25 s 内从 130564 漂到 130573

   （约 9 counts），量级远小于 295 counts 的偏移，但未做温度控制。

5. **未排除布局因素**。器件附近大面积铺铜对线圈脉冲后瞬态的影响未做对照

   （换板 / 屏蔽 / 改铺铜的实验都没做）。

#### 9.6.8 复现命令与脚本

```

# 对照表（9.6.2 / 9.6.3）

python C:\\Users\\33\\Documents\\v3\\_ctl.py

# 近静止收紧 + 交互效应排除

python C:\\Users\\33\\Documents\\v3\\_interact.py

# 零点时间稳定性 + 与运动量关系（9.6.4 / 9.6.5）

python C:\\Users\\33\\Documents\\v3\\_zero.py

```
