Tokisaki3333/h415-LSM6DSV16XTR/(commit log)

2026-10-09 baseline: MMC5983MA + LSM6DSV16X 双 DRDY 中断可用基线
    硬件工作点已经跑通并留档。这个仓库是【新板子】的独立仓库 ——
    旧板子（ICM42605+IST8310）的仓库已移出到
    _archive/baseline_mmc+gyro_20261009/OLD_GIT_旧板子仓库，不再使用。
    == 中断分工（V3F 只有 2 位抢占级 = 0/1）==
    级 0 EXTI15_8(33) 陀螺 DRDY 7680Hz（周期 130us）+ 复位键 PB10
    级 1 EXTI7_0 (36) 地磁 DRDY 1024Hz（周期 977us）
    陀螺必须更高：地磁 ISR 单次阻塞约 35us，若地磁优先会把陀螺堵 4 个周期丢帧。
    == 实测 ==
    地磁 mmc_hz=1024 pairs=512(=hz/2) mmc_err=0
    陀螺 IMU,hz=7678（目标 7680，99.97%）IMU,e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
2026-10-09 chore: 归档 DMA 死代码、精简过期注释、移除诊断脚手架
    == 死代码归档 ==
    原 DMA 采集路径（小核拉 CS 启 DMA、大核完成中断抬 CS 并解析）与当前实现
    （两个 DRDY 中断内阻塞 SPI 读）不一致，且已无任何调用方。移出主工程：
    Common/Common/sensor_dma.c -> _archive/deadcode_dma_path/Common_sensor_dma.c
    Common/Common/sensor_dma.h -> _archive/deadcode_dma_path/Common_sensor_dma.h
    V5F/User/src/sensor_dma_rx.c -> _archive/deadcode_dma_path/V5F_User_src_sensor_dma_rx.c
    三个文件内容一字未改（git 识别为 R100），README 记录了原设计、DMA 通道参数
    （SPI1: Ch3/Ch2 Mux3/2 请求63/64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
2026-10-09 baseline: 全速双核 IMU 采集 + TF 卡日志 + 传感器质量验证
    采集链路
    - V3F: 气压(47Hz) + GPS(20Hz) 时间预算式交错；地磁 ISR 发布到共享区
    - V5F: 陀螺 7680Hz RX DMA -> 解析 -> 发布；全速记录并回放到串口
    - 共享区三通道 (imu/mmc/bmp) 统一 hdr.cnt + ts_lo 发布语义
    TF 卡日志（裸扇区，不走 FatFS）
    - 每扇区 = 16B 头(MAGIC|SEQ|LEN|XOR) + 496B 数据
    - 写后逐扇区读回比对，verify_bad 计数
    - 回放只发有效数据段，消除旧格式 65% 零填充
    - 日志区起点 LBA 4096；单次 512 扇区批量写
    传感器质量结论（WMM2020 对照，GPS 实测 36.2296N 120.4328E）
    - 加计静止 |a|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
2026-10-09 wip: 1V2 电压配置(PA5) + 500MHz + CDC 恢复；SD 采集版 V5F/main.c 归档
2026-10-12 mag: MMC 每1024个SET周期一次RESET + 去掉板上配对; 补 CTRL8; 新增精度测量报告
    【V3F / 地磁驱动】
    - board_io.c: 状态机由"每拍翻转"改为"每 MMC_FLIP_PERIOD=1024 个 SET 周期做一次 RESET 周期"
    （原分支体内的寄存器写与等待一字未改，无任何读后写）
    - board_io.c: shm_publish_mmc 调用补第 5 个参数 s_polarity（匹配 mipc_shm.h）
    - board_io.c: 补写 CTRL8 = FS_XL_16G（原初始化漏写，器件停在复位默认 +-2g）
    【V5F / 处理链】
    - proc_mag.c: 移除板上配对/归一化/有效性检查，只保留原始 counts + 极性直通；
    g_proc.mag_valid 恒 0（配对与分析全部移到 PC 端）
    - 新增: pr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
2026-10-12 chore: 补入非临时的 MRS 工程文件（工作区定义 + 编码配置），明确排除编辑器快照
    - 新增入库:
    .mrs/CH32串口陀螺仪.mrs-workspace 工作区定义（folders 为相对路径，指向 V3F/V5F）
    V3F/.mrs/preferredEncoding.json 工程级文件编码配置
    （原先被 .gitignore 的 `.mrs/` 整目录规则挡住，用 git add -f + 否定规则补入）
    - .gitignore: 在 `.mrs/` 整目录忽略的规则下补两条否定规则，并显式排除
    .mrs/*.snapshot —— 编辑器布局快照（partsEditor/textFileEditor/labeledBookmarks），
    纯临时状态且内含本机绝对路径，不入库
    - 工程本体文件此前已全部入库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
2026-10-12 docs: 录像改用参考文献制命名 [n]描述.bin，建立与文档的一一对应
    【命名】证据链关键录像 10 份改名为 [n]描述.bin（原 rec_YYYYMMDD_HHMMSS.bin）：
    【1】 [1]45度停泊_360度旋转.bin 原 rec_20261012_131801.bin (45度停泊转360度，本轮主力数据)
    【2】 [2]地磁专用_含转动.bin 原 rec_20261012_130654.bin
    【3】 [3]静止短录_1024比1.bin 原 rec_20261012_130552.bin
    【4】 [4]静止短录_1024比1_二.bin 原 rec_20261012_130128.bin
    【5】 [5]1024比1_中间版本.bin 原 rec_20261012_125755.bin
    【6】 [6]1024比1_首份.bin 原 rec_20261012_125003.bin
    【7】 [7]每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
2026-10-12 docs: 更正"一转就漂"的结论 + 各文档加核对时间戳（用于矛盾时判优先级）
    【核心更正】docs/mag_calibration_log.md
    - §9 高频 RESET 实验与 §9.6 控制变量实验（本轮新增，已在此前提交）
    - 本次补充：在文档头部加"最后核对"时间戳
    【更正要点（与 MMC5983MA旋转性能问题_阶段成果.md 同步，该文件在工作区根、不入本仓库）】
    · 原判"误差 = AMR + SET/RESET 半差在器械转动中的固有方向畸变"（原理性缺陷）**已推翻**
    · 现行结论：误差来源 = SET/RESET 【高频翻转】引入的 RESET 相状态失真，可修且已修
    每拍翻转 1040 Hz：RESET σz 24.5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
2026-10-13 S2: 重力门锁死彻底修复 + 地磁读法防错文档
    阶段目标(大运动后姿态能在静止/手持段自动重新对准重力)已达成。
    交付录制 rec_20261013_082322: 末端 resid 0.131°、grav_open 100%；
    运动段 grav_open 0.0~0.3% 正确关闭。
    门控修复链(每一步均有量化依据):
    S1 删除自适应残差门 resid<acc_thr 恢复能力 0% -> 97.2%
    S2 速率门 ESKF_GRAV_WLIM_DPS 2.0->20 手端平开门 48.3% -> 85.5%
    S3 Q 的 k_s 项改为系统性形式 2*k_s^2*throt*|w|*dt + s_throt_acc
    (原 (k_s*|w|*dt)^2 累积是随机游走 ∝N, 与 §2.4 的 (k_s*throt)^2 ∝N^2 矛盾,
    使 P 倾斜 1sigma 只有 0.49°, 差 300 倍)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
2026-10-14 mag: v_mag 改为静止窗等效公式 + 磁观测纯净路径; 注入帧须跳过 CDC 陈旧段
    【1】v_mag 构造：注入后开启静止窗（ESKF_VMAG_NWIN=1000 个磁样本 ≈0.83s），
    累加实测 a_g 与磁单位矢量，用与 eskf_build_q0 数学等价的公式构造：
    zb=a_mean/|a_mean|; um=u_mean/|u_mean|; yb=normalize(um-(um.zb)zb)
    xb=zb x yb; v_mag = R0.um (R0=[xb;yb;zb] 为体->导航)
    不调用 eskf_build_q0（它会覆盖 s_eskf.q，而 PC 复刻的姿态由录制注入）。
    修复前：注入旁路启动标定 => v_mag 停在初值 [0,1,0]（水平假参考）=> 磁观测
    用假目标拉姿态，实测 mag_resid 56.4°、姿态歪 54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
2026-10-14 fix(mcu): v_mag 累加器移出 PC_PROBE + 产品路径复位 + 探针赋值加守卫
    v5f 固件编译失败（MCU 构建无 PC_PROBE），三处修复：
    【1】s_vmag_acc / s_vmag_aacc / s_vmag_cnt / s_vmag_ready / ESKF_VMAG_NWIN
    原声明落在 #ifdef PC_PROBE 块内 ⟹ MCU 下全部未声明。
    但 v_mag 的静止窗构造是【产品逻辑】（板载与 PC 共用），必须移出守卫。
    【2】补产品路径复位：原复位只在 proc_eskf_pc_inject（PC-only）内，
    板载复位后累加器会残留。改在 eskf_calib_reset()（proc_eskf_init 调用）
    统一清零 —— 板载正常启动走 eskf_build_q0 给出 q0/v_up/v_mag，
    注入路径走本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
2026-10-14 chore(mcu): 消除全部编译告警（ATT 越界写 + 4 组未使用变量）
    【1】justfloat.c: jf_att_push 真实越界写（gcc -Wstringop-overflow）
    账目错在把 put_head 当成 2 float。实际 put_head 写 4 float
    （2 同步 + type + seq），原实现数据又写了 14 float ⟹ 合计 18 float = 72 B，
    而 buf[JF_ATT_BYTES] = 16 float = 64 B ⟹ offset 64..71 越界。
    修正：数据只写 12 float（temp_raw / mag_err_deg 本帧无对应字段，显式 (void)），
    合计 16 float = 64 B，与 JF_ATT_NFLOATS=16 / JF_ATT_WIRE_BYTES=64 一致。
    注：jf_att_push 当前【无调用者】（main.c 只发 FULL 168B），属死路径，
    但仍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
2026-10-14 fix(mcu): proc_mag.c 补 math.h + 删除未使用变量 sgn
    v5f 编译告警（第二批）：
    proc_mag.c:141 warning: implicit declaration of function 'sqrtf'
    warning: incompatible implicit declaration of built-in function 'sqrtf'
    proc_mag.c:96 warning: unused variable 'sgn'
    1) proc_mag.c 未 include math.h，但产出净场模长用了 sqrtf
    （proc_eskf.c / proc_attitude.c / proc_agmag.c / proc_mag_corr.c 均已 include）。
    补上 #include <math.h>。
    2) proc_mag_step 内 float sgn 已无使用者
    （旧配对公式 (m_SET - m_RST)/2 已被"逐相球心 + 常量零点"取代），删除。
2026-10-14 docs: README 如实记录当前进度、已知缺陷与未来承诺
    原文仅写"实现了传感器采集、陀螺仪角速度部分基础校准，并未实现高级目标"，
    未反映 ESKF/地磁的实际状态（既有已验证项，也有尚未解决的问题）。
    本次改为如实记录：
    新增"进度（如实记录）"章节：
    已完成并验证：双核 8kHz 链路、IMU 全速采集、MMC5983MA 采集、
    陀螺零偏/标度（ESKF_KS_SCALE=75ppm）、加计倾斜（与参照逐帧一致，
    acc_resid 复现差 0.000044°）、ESKF 磁开/磁关两路径、v5f 编译零告警、
    168B v4 帧字段核对一致
    刚修复待观察：地磁通道三处缺陷（v_mag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
2026-10-14 hardware: 新增标定夹具 FreeCAD 模型 + 设计得失说明
    来源：v3模型\标定夹具（代码工作区之外的原始目录，未改动）
    入库内容 hardware/calibration_fixture/：
    上齿轮.FCStd / 下齿轮.FCStd / 支架.FCStd / 零件.FCStd / 齿轮台.FCStd / 未命名.FCStd
    README.md（用途、文件清单、实测得失、后续建议）
    共 6 个模型 + 1 个说明，3.49 MB，逐文件 MD5 与原始目录校验一致
    README 如实记录该夹具的得失（两面都写，不偏）：
    【能用的一面】本夹具就是实际标定所用的那套，实测勉强能用、精度不错。
    已用于本工程六面整圈标定，SET 相球拟合残差达 0.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
2026-10-14 hardware: 标定夹具 README 补充装配五金清单（BOM）
    按实际装配经验补充所需五金：
    轴承 内径 25 mm、外径 37 mm、厚度 <= 7 mm 1 个
    （即"需要特定型号轴承"的具体规格，非通用件）
    M3 铜柱 长度 >= 7 mm，建议 15 mm 以上 3 个
    M3 螺丝 或另加 3 根铜柱，无特殊要求 3 个
    M3 黄铜螺丝 用于固定 PCB，无特殊要求 2~4 个
    304 不锈钢螺丝 有弱磁性 —— 若使用，靠近地磁传感器的
    螺丝位置必须留空，否则污染磁标定
    并加"关键提示"：本夹具用于地磁标定，靠近传感器一侧的紧固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
2026-10-14 hardware: 夹具 README 补充免轴承方案、切片加强建议、建模软件说明
    按实际装配与建模经验补充三部分：
    1. 装配的两种方案
    方案 A 用轴承（原始设计，轴承受限）
    方案 B 不用轴承（推荐尝试）：修改「支架」模型把转动轴直径改小，
    使其避开轴承、直接支撑上/下齿轮 —— 省掉非通用轴承，装配更简单；
    代价是摩擦与径向跳动更大，精度需自行实测（本工程未在此方案下验证）
    无论哪种方案：建议在切片软件中对"转动轴与支架的连接处"做加强
    （加厚/加密填充/加圆角过渡），该处是悬臂受力根部
    2. 建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
2026-10-14 hardware: 夹具目录剔除两个无效模型（空白文档 / 中间残留）
    原始目录 v3模型\标定夹具 共 6 个 .FCStd，其中 2 个不应入库，故从仓库移出
    （原始目录保持不动，未删除任何文件）：
    【移出】齿轮台.FCStd
    经核验为【空白文档】：包内只有 Document.xml / PlacementList / ScaleList /
    GuiDocument.xml / Thumbnail.png，没有任何 .brp 几何数据；
    对象仅 Assembly + Origin + 三轴 + 三基准面 + Joints + 空 Link，
    没有 Sketch / Pad / Pocket / InvoluteGear。
    CreationDate 2026-10-10T20:21:40、LastModifiedDate 2026-10-10T21:27:02
    —— 建立后未建模。
    【移出】零件.FCStd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
2026-10-14 hardware: 未命名.FCStd 改名 PCB支架.FCStd，并明确四个模型即全部
    按确认：本夹具的全部模型就是 4 个 —— 支架 / 上齿轮 / 下齿轮 / PCB支架。
    git mv hardware/calibration_fixture/未命名.FCStd
    hardware/calibration_fixture/PCB支架.FCStd
    内容未改动：改名前后 MD5 均为 4FFFCC43BBBD，且与原始目录的
    未命名.FCStd 一致。原始目录保持不动（未删除、未改名任何文件）。
    README 相应更新：
    - "文件清单"改为 4 个并明确"本夹具的全部模型就是以下 4 个"，
    其中 PCB支架 注明原名是 未命名.FCStd（入库时改名，内容未改动）
    - 加注：PCB支架.FCStd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
2026-10-14 docs: 新增地磁工作交接文档（2026-10-15）
    如实记录本轮地磁方向精度工作的尝试、实测效果与假设，
    并严格区分【事实】/【假设】/【已否证】/【未验证前提】四类标记。
    主要内容:
    - 事实清单 F-1~F-13：帧解析、SET/RST 覆盖度、球拟合、两相中点姿态无关性、
    陀螺净转角、加计一致性、角度误差分解、水平模长波动、正六边形约束反解零点 δ
    - 未验证前提 U-1~U-4：零点取值、转台几何、磁-加计安装、场均匀性
    - 假设 H-1~H-3 与已否证 X-1~X-5
    - 本次工作犯过并已更正的 11 处口径/量纲/工具类错误 E-1~E-11
    - 待做判定实验 D-1~D-3
    关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
2026-10-14 docs: 补齐官方手册、录制工具与地磁工作交接（2026-10-15）
    【新增资料】
    - docs/datasheets/：9 份官方手册与规范
    LSM6DSV16XTR / MMC5983MA / MMC5603NJ / BMP388 / ICM-42605(旧代) 数据手册，
    CH32H417 数据手册与参考手册，ATGM336H GNSS 手册，LSM6DSV16X 寄存器映射表
    - docs/参考源_官方手册与规范.md：手册索引 + 器件换代说明 + 引用纪律
    （明确 reference_implementations_survey.md 为旧代 ICM-42605+IST8310 内容）
    - tools/recording/：record.ps1 / record.cmd / mag360_recording_protocol.md / README.md
    【新增交接文档】
    - 地磁工作交接_20261015.md：
    顶部为【唯一验收判据】（地磁矢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
2026-10-14 fix(comments): 修正两处注释与代码不符（不改任何数值）
    1) proc_eskf.c: ESKF_KS_SCALE 上方注释写 636 ppm 并附完整推导，
    而实际定义为 7.5e-5f（75 ppm），两值差 8.5 倍；因该常量平方后进 Q，
    倍率差 72 倍，直接影响所有观测的 K = P/(P+R)。
    注释改为"当前 75 ppm"，并把 636 ppm 的推导明确标为
    【已被替换的旧值记录】，附变更出处 commit 8c30f77，避免被改回。
    2) proc_tune.h: CORR_K_MIN/CORR_K_MAX 上方注释在论证"K 取 0.02"，
    而实际值均为 0.0f，读者会误以为漏改。
    经 git 历史确认，0 是【有意关闭】（commit 3f9bfc0 原注释
    "关闭：本链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
2026-10-14 docs: 记录关键录制的实际位置与大文件纪律
    【关键录制的现状（已核实）】
    - MCU 原始录制 rec_20261014_*.bin：全部不存在
    （R:\ 为 RAM 盘已清空；_recordings/ 为空；全盘搜索无命中）
    - PC 复刻导出：找到 8 个文件共 482 MB，已按用户指示拷到 R 盘并逐个 SHA256 校验
    R:\rec_关键_20261014\
    x_025232_on/off.bin x_034941_on/off.bin
    x_033516_on/off.bin x_043549_on/off.bin
    （_on = 磁开，_off = 磁关；76 B/帧 = 19 float；1,036,002 帧/份）
    这四份正对应接力文档 §4.3 的 A/B/C/D
    清单 R:\rec_关键_20261014\录制清单.md（含逐文件 SHA256 与对应表）
    - 仍缺：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
